kranthie/marvin-bot/sim/motion/README.md

# Motion pipeline: human motion to a Marvin Bot tracking policy

Status: one tracker follows all 25 clips generated with Kimodo (locomotion, sidesteps, turns,
a jog, a march, a kick, squatting and picking up, a bow, a dance and arm gestures) on the 1.41 m
model with the RS10P arm motors. Tracker v6: warm-started from v5 (about 5,000 epochs on the 1.44 m
model) and trained 1,800 more epochs on the current one (16,384 environments, batch 65,536, about
3 hours on one GPU); every clip stays upright, the hands are 3-8 cm and the feet 2-6.5 cm from the
reference's on most clips, with the arm-heavy clips the weakest (two-hand wave, reach forward,
clap, arms raise: hands 9-13 cm).
The clips with the reference as a ghost are on the [skills page](../../docs/skills.md).
Replayed in MuJoCo (`replay_mujoco.py`), it tracks as in training: see
[the MuJoCo check](#the-mujoco-check).

Instead of writing rewards for each skill, train a policy that tracks a reference motion
(BeyondMimic-style motion tracking). A new skill is then a new clip, not new reward code. The
pipeline uses NVIDIA's open tools:

| Step | Tool | Here |
|---|---|---|
| Motions | [Kimodo](https://github.com/nv-tlabs/kimodo) text to motion, with a root path per clip | `generate_kimodo.py` |
| Keypoints | ProtoMotions' `convert_soma23_npz_to_proto.py`, `extract_retargeting_input_keypoints_from_packaged_motionlib.py` | |
| Retarget | ProtoMotions' PyRoki retargeter | `retarget_marvin_bot.py` |
| Convert, package | ProtoMotions' `convert_pyroki_retargeted_robot_motions_to_proto.py`, `motion_lib.py` | `fix_sole_height.py` |
| Track | [ProtoMotions](https://github.com/NVlabs/ProtoMotions) on Newton, BeyondMimic-style rewards | `setup_protomotions.py`, `check_tracking.py` |

`setup_protomotions.py` writes Marvin Bot's MJCF, retargeting URDF and robot config into a
ProtoMotions checkout, all generated from `description/`, and the tracker experiment, made from
upstream's BeyondMimic config with the changes below; rerun it after a description change.

What is specific to Marvin Bot:

- **Scale.** Human keypoints are scaled to Marvin Bot's size in place of the retargeter's G1
  scale: the legs uniformly (0.69, the robot's straight leg over the source's standing one), the
  pelvis target put on the hip axis, the shoulders about the hips (0.62 wide, 0.75 high) and
  6.5 cm forward, the arms about each shoulder (0.79, reach to the wrist pitch axis). The knees
  and feet are then moved 1.5 and 3 cm out along the hip axis: scaled down, the human's feet end
  up 12-14 cm apart and Marvin Bot's are 11 cm wide. The solver also starts from and pulls
  towards the standing pose rather than the middle of each joint's range. With the source's
  pelvis and shoulders left high, the solver crouched the robot to reach them (knees at 37-58°
  through a walk).
- **Arms kept out of the body.** Upstream's retargeter leaves its self-collision cost off, and
  the retargeted arms passed through the body: hands 4-10 cm into the thighs in most walking
  frames, the palms 9 cm through each other in the clap. `retarget_marvin_bot.py` turns it on
  for the arms against the trunk, the legs and the other arm, which leaves no frame with an arm
  inside the body, and the tracking model's arms collide with the body and each other too.
- **Motions at Marvin Bot's pace.** `generate_kimodo.py` gives every locomotion clip and
  in-place skill a root path, so the speed and turn rate are set rather than worded: Kimodo's
  idea of "jogs forward" was a 2 m/s run, which no tracker followed. Of four samples per clip it
  keeps the one with the least foot sliding and crossing of the feet.
- **Palms in.** The motion pipeline's standing pose turns the wrists 80° so the palms face the
  thighs (`robot.yaml`'s stance, which the walking policies use, leaves them facing forward), and
  the retargeter holds the wrist yaw and pitch there, since no keypoint sets the hand's angle.
- **Soles.** ProtoMotions' converter puts the lowest body origin 4 cm above the floor, which
  suits G1's foot frame; `fix_sole_height.py` lifts each clip until the stance foot (the flatter
  one) is on the floor. Lifting until the clip's lowest corner touched instead left the walks
  3-5 cm in the air, since that corner is a toe tipped down at push-off, and the trackers hopped
  to keep up.
- **Tracker.** `mlp_bm_marvin_bot.py` is upstream's `mlp_bm_l2c2.py` with BeyondMimic's
  global anchor-position reward (0.5, sigma 0.3) and a termination when the torso is 0.5 m off
  the reference's, both left out upstream, which is why trackers 1-4 stood still; the reference
  torso's offset in the policy's observations; softer gains for an action scale of at least
  0.4 rad (the walking task's placeholder gains gave 0.2 rad at the hips and knees); more
  exploration (log std -2.3) and a looser body-velocity term (sigma 0.5); and a penalty (-2.0)
  on each foot whose contact differs from the reference's. Without it the trackers hopped,
  with both feet on the ground 70% of the time and both in the air 20%, where the reference
  steps; upstream's other experiments use -0.1, and -0.5 only halved it. The body rewards
  score BeyondMimic's 14 key bodies (pelvis, hips, knees, ankles, torso, shoulders, elbows,
  wrists) instead of all 28, whose average let an arm hang while the reference raised it (hands
  40-75 cm off in the arm skills), and an episode ends when any body is 25 cm from the
  reference's, as in ProtoMotions' deployed G1 tracker; together they brought the hands to
  8-20 cm in the same skills.
- **A second check.** ProtoMotions counts a clip as tracked when the torso height stays within
  25 cm of the reference's; `check_tracking.py` also compares the distance covered, the joint
  angles and the body positions, all bodies and the hands and feet alone (an average over every
  body hides a limb that misses), which is how the first tracker's shuffling showed up.
- **The head and a joint-angle term.** With only the 14 bodies scored the head was free: the
  tracker turned it at 46-60°/s RMS standing still (1-3°/s in the reference). Scoring the head
  and adding a joint-angle term (weight 0.5, sigma 0.3 rad) more than halved that (93°/s to 41°/s
  averaged over the 25 clips) and stopped the crouch the 0.3 m body kernel let through. The term
  scores only the legs, waist and neck: the retargeted arm angles are ill-defined (with the elbow
  nearly straight nothing fixes shoulder yaw, and with the arm out sideways shoulder pitch and yaw
  turn the arm the same way), so the arms-raise reference twists the shoulder yaw by 175° for no
  change in the hand. Scored over every joint, the term made the tracker copy that twist and miss
  the hands by 3 cm more in the arm clips; the arms are scored by their bodies instead.
- **Training size.** 16,384 robots at once keep one RTX-class GPU busy (95%, against 58% with
  4,096), for twice the simulated steps per hour.

## Environments

Everything lives in one parent folder, outside this repo: the ProtoMotions, PyRoki and Kimodo
checkouts, three Python environments (PyRoki uses JAX; Kimodo its own torch) and a work folder.
ProtoMotions keeps its checkpoints, meshes and sample motions in Git LFS (about 6 GB; install
`git lfs` first). The torch wheels below need an NVIDIA driver for CUDA 12.8 (570 or later);
Kimodo needs about 17 GB of GPU memory (or `TEXT_ENCODER_DEVICE=cpu`, under 3 GB). The pipeline
was last run on ProtoMotions `f69fdcaabff31846b4d2247207417b57dc788828` (2026-10-16), PyRoki
`388e43e1fc0d0ee382968d3dd72970fd62a0450c` and Kimodo `e1c219c99b4b94ba48be1fb6a1cbc64ecee4c954`
(2026-10-15), with JAX on the CPU.

Kimodo encodes prompts with Meta's Llama 3 8B Instruct, which is gated: request access to
`meta-llama/Meta-Llama-3-8B-Instruct` on Hugging Face, accepting the Meta Llama 3 Community
License, and log in with `hf auth login` before the first run. Kimodo downloads its own model
and the text encoder on first use (about 16 GB).

```bash
export M=/path/to/marvin-bot          # this repo
cd /path/to/parent && export W=$PWD/work && mkdir -p $W
git lfs install
git clone https://github.com/NVlabs/ProtoMotions
git -C ProtoMotions checkout f69fdcaabff31846b4d2247207417b57dc788828 && git -C ProtoMotions lfs pull
git clone https://github.com/chungmin99/pyroki
git -C pyroki checkout 388e43e1fc0d0ee382968d3dd72970fd62a0450c
git clone https://github.com/nv-tlabs/kimodo
git -C kimodo checkout e1c219c99b4b94ba48be1fb6a1cbc64ecee4c954
uv venv --python 3.12 venvs/proto
VIRTUAL_ENV=venvs/proto uv pip install torch --index-url https://download.pytorch.org/whl/cu128
VIRTUAL_ENV=venvs/proto uv pip install -r ProtoMotions/requirements_newton.txt
VIRTUAL_ENV=venvs/proto uv pip install -e ProtoMotions
uv venv --python 3.12 venvs/pyroki
VIRTUAL_ENV=venvs/pyroki uv pip install -e pyroki
uv venv --python 3.12 venvs/kimodo
VIRTUAL_ENV=venvs/kimodo uv pip install torch --index-url https://download.pytorch.org/whl/cu128
VIRTUAL_ENV=venvs/kimodo uv pip install -e "kimodo[soma]"
```

`setup_protomotions.py` edits the ProtoMotions checkout (it adds four generated files and
registers `marvin_bot` in `robot_configs/factory.py`), so rerun it after updating ProtoMotions or
the description.

## Steps

Generate the motions (`locomotion`, `skills` or clip names; see `generate_kimodo.py`), then run
the rest from the ProtoMotions checkout (`cd /path/to/parent/ProtoMotions`); the interpreters
are `../venvs/proto` and `../venvs/pyroki`. The retargeter runs one clip per process, all at
once, which takes a few minutes for the eleven locomotion clips on a 32-thread CPU (one after
another it takes about 10 minutes a clip, since JAX recompiles for each).

```bash
../venvs/kimodo/bin/python $M/sim/motion/generate_kimodo.py $W/npz locomotion skills
P=../venvs/proto/bin/python; R=../venvs/pyroki/bin/python
$P $M/sim/motion/setup_protomotions.py .
$P data/scripts/convert_soma23_npz_to_proto.py --input-dir $W/npz --output-dir $W/soma \
    --input-fps 30 --output-fps 30 --ignore-motion-filter
$P protomotions/components/motion_lib.py --motion-path $W/soma --output-file $W/soma.pt
$P data/scripts/extract_retargeting_input_keypoints_from_packaged_motionlib.py $W/soma.pt \
    --output-path $W/keypoints --skeleton-format soma --start-idx 0 --skip-freq 1
for f in $W/keypoints/*.npy; do
  d=$W/keypoints_split/$(basename $f .npy); mkdir -p $d; cp $f $d/
  ( $R $M/sim/motion/retarget_marvin_bot.py --protomotions . --keypoints-folder-path $d \
      --output-dir $W/retargeted --source-type soma --no-visualize &&
    $R $M/sim/motion/retarget_marvin_bot.py --protomotions . --keypoints-folder-path $d \
      --output-dir $W/retargeted --source-type soma --no-visualize \
      --save-contacts-only --contacts-dir $W/contacts ) &
done; wait
$P $M/sim/motion/add_head_motion.py $W/npz $W/retargeted \
    protomotions/data/assets/urdf/for_retargeting/marvin_bot.urdf
$P data/scripts/convert_pyroki_retargeted_robot_motions_to_proto.py \
    --retargeted-motion-dir $W/retargeted --output-dir $W/proto --robot-type marvin_bot \
    --contact-labels-dir $W/contacts --apply-motion-filter --force-remake
$P $M/sim/motion/fix_sole_height.py . $W/proto
$P protomotions/components/motion_lib.py --motion-path $W/proto --output-file $W/marvin_bot_motions.pt
$P protomotions/train_agent.py --robot-name marvin_bot --simulator newton \
    --experiment-path examples/experiments/mimic/mlp_bm_marvin_bot.py --experiment-name marvin_bot_track \
    --motion-file $W/marvin_bot_motions.pt --num-envs 16384 --batch-size 65536 --headless
$P $M/sim/motion/check_tracking.py \
    results/marvin_bot_track/results/predicted_motion_lib_epoch_<N>.pt $W/marvin_bot_motions.pt
```

The tracker trains at about 5.6 s an epoch with 16,384 robots on one RTX-class GPU and writes a
rollout of every clip (`predicted_motion_lib_epoch_<N>.pt`) every 600 epochs, from epoch 200;
score the latest with `check_tracking.py`.

### The MuJoCo check

The tracker is exported to ONNX with ProtoMotions' own tool and replayed in MuJoCo, clip by clip,
on the training MJCF with the motors as the walking policies' MuJoCo check models them (PD clipped
by the torque-speed line, joint armature and friction, none of which Newton's built-in PD has) and
sensor noise on the joint angles, joint speeds and pelvis rate. It fails if any clip falls, so it
is run on every new tracker when its training stops:

```bash
$P deployment/export_bm_tracker_onnx.py --checkpoint results/marvin_bot_track/last.ckpt --output $W/onnx
$P $M/sim/motion/replay_mujoco.py $W/onnx/unified_pipeline.onnx $W/marvin_bot_motions.pt $W/mujoco.pt
$P $M/sim/motion/check_tracking.py $W/mujoco.pt $W/marvin_bot_motions.pt
$P $M/sim/motion/render_tracking.py export <Newton rollout> $W/marvin_bot_motions.pt $W/v.npz \
    --mujoco $W/mujoco.pt    # then render: MuJoCo is drawn as a translucent orange robot
```

(`pip install onnx onnxruntime` in the ProtoMotions environment first.) Tracker v6 in MuJoCo: every
clip upright, and the averages over the 25 clips match training (joints 9.3° against 9.4° in
Newton, hands 5.6 cm against 5.6, feet 4.2 against 4.6; tracker v5 on the 1.44 m model: 11.0°,
6.7 cm, 4.5 cm). Peak torque stays under 75% of each motor's peak except the two-hand wave's left
shoulder yaw, which touches the RS10P's 42 N·m (the RS06 there hit its 36 N·m in v5). The hottest
joint in any clip is the clap's left shoulder roll at 78% of the RS10P's 14 N·m rating (RMS); the
legs stay under 56%.

The tracker reads the torso's position in the world (how far the reference is ahead of it). In
simulation that is exact; on the robot it has to come from odometry (legged odometry or the
camera's visual odometry), so a version without it, or trained with odometry drift (ProtoMotions
has a synthetic odometry-corruption option), is needed before hardware.

`add_head_motion.py` sets the neck from the human's head: ProtoMotions' retargeter (built for a
robot without a neck) has no head keypoint, so before it every reference looked straight ahead.

**Checking the clips before training** (`check_clips.py`). Each layer runs on Kimodo's human clip
and the third again on the robot reference, so a failure points at generation or at retargeting:

1. *Text match*: NVIDIA's text-motion retrieval model for SOMA (TMR-SOMA-RP-v1, which Kimodo's
   benchmark scores with) gives each clip its similarity to its own prompt and that prompt's rank
   among all 25; a clip another prompt describes better is suspect.
2. *Quality*: Kimodo's benchmark metrics: foot sliding while in contact (its published Skate is
   2-4 cm/s), contact consistency, and the hips' distance from the root path asked for.
3. *Skill checks*: a geometric test of what each prompt asked for (the hands meet in a clap, a
   hand above the shoulder swinging in a wave, the pelvis dropping in a squat, the speed, turn and
   direction of a walk), in units of the standing head height so it runs on both bodies.
4. *Review renders*: the human as a stick figure beside the robot reference, with the checks.

```bash
../venvs/kimodo/bin/python $M/sim/motion/check_clips.py human $W/npz       # layers 1-3
$P $M/sim/motion/render_tracking.py export $W/marvin_bot_motions.pt $W/marvin_bot_motions.pt $W/ref.npz
python sim/motion/check_clips.py robot $W/ref.npz                            # layer 3, this repo's env
MUJOCO_GL=egl python sim/motion/check_clips.py render $W/npz $W/ref.npz <out dir>   # layer 4
```

On the first 25 clips (2026-10-29) every clip ranked its own prompt first or second and slid
0.2-3.8 cm/s in contact, but five did less than asked: the wave waved for 2 s of 8, the arm raise
lifted the arms about 45° rather than to the sides, the march stopped after 3 s, and the idle and
the dance sway barely moved (1-2 cm; a root path pinned at the start held their hips still).
`generate_kimodo.py` now keeps the sample with the fewest failed skill checks; with sharper
prompts, no root path for the idle and the dance, and 8 samples each, all 25 pass and every clip
ranks its own prompt first except the reach (second, after the two-hand wave). On the robot two
fall short of the human: the clap's palms meet once rather than three times, and the pick-up's
hands stop 27 cm above the floor (with no waist pitch the robot cannot bend over to reach it).

`render_tracking.py render --plot` adds a strip under a tracked clip plotting how far the hands,
feet and head are from the reference's, frame by frame.

`convert_100style.py` turns [100STYLE](https://zenodo.org/records/8127870) motion capture
(CC-BY-4.0) into keypoints instead (then retarget with `--converted` and skip the Kimodo and
keypoint-extraction steps); it was the source before Kimodo.

## Lite's clips

[Lite](../../docs/design/lite.md) shares Max's upper body and has no legs. Its clips take the
upper body (waist, arms, wrists, neck) from the retargeted clips above. A base path and a column
height are written for each in `lite_clips.py`, as keyframes joined by minimum-jerk curves inside
the base controller's limits and the column's 38 mm/s, instead of being taken from the hips. The
`lite` group of `generate_kimodo.py` adds two standing upper bodies for it: holding a box and
handing something over.

No tracker is trained: Lite does not balance, so `lite_clips.py run` plays each clip on its
wheels in MuJoCo (`sim/mujoco/check_lite.py`'s model) with the joints' position servos. It scores:

- the hands against the clip;
- the base's path error;
- the two lightest wheels' loads;
- each joint's peak and RMS torque.

It fails if two wheels unload, a joint passes its rating, or the column is asked for more than
38 mm/s. Results are on the [skills page](../../docs/skills.md#lite).

```bash
../venvs/kimodo/bin/python $M/sim/motion/generate_kimodo.py $W/npz lite
# then the Steps above, from convert_soma23_npz_to_proto.py to add_head_motion.py, for these clips
python $M/sim/motion/lite_clips.py run $W/lite.npz $W/retargeted <the other clips' retargeted/> \
    --protomotions <ProtoMotions checkout>
MUJOCO_GL=egl python $M/sim/motion/lite_clips.py render $W/lite.npz $M/docs/media/skills/lite
```

## Motion sources compared

The same eight motions from three openly licensed sources, retargeted and tracked the same way
(1,400 epochs each, before the root paths, the contact penalty and the sole fix):

| | 100STYLE | Kimodo (SOMA-RP model) | CMU |
|---|---|---|---|
| Clips through ProtoMotions' motion filter | 8 of 8 | 8 of 8 | 5 of 8 (the rest jump) |
| Planted foot sliding (median) | 0.07 m/s | 0.06 m/s | 0.43 m/s |
| Tracker stays up | 5 of 8 | 3 of 8; 5 of 8 with gentler prompts | 3 of 5 |

Kimodo became the source: its motions tracked as well as 100STYLE's once the prompts asked for
a pace Marvin Bot can keep, a root path now sets that pace exactly, and it makes the skills
beyond walking that no openly licensed dataset has. 100STYLE remains an option for locomotion
(CC-BY-4.0, real capture). CMU's recordings are older and noisier.

## Data licences

Motion data is not committed. Kimodo's models are under the NVIDIA Open Model License (NVIDIA
claims no rights in the motions they generate) and were trained on Bones Studio's motion
capture; its text encoder is Meta's Llama 3 8B Instruct under the Meta Llama 3 Community License
and the LLM2Vec adapters (MIT). Each user accepts those licences when downloading the models;
nothing from them is redistributed here. 100STYLE is CC-BY-4.0: credit "100STYLE, I. Mason,
S. Starke and T. Komura, Real-Time Style Modelling of Human Locomotion via Feature-Wise
Transformations and Local Motion Phases (2022)" with anything you publish from it.
ProtoMotions' own sample motions are from the BONES-SEED dataset, whose licence covers only
non-profit academic institutions and companies under $1M annual revenue; this pipeline does not
use them. The CMU database (mocap.cs.cmu.edu) is free to use, with that credit. ProtoMotions'
and PyRoki's code is Apache-2.0 and MIT.
