kranthie/marvin-bot/docs/safety.md

# Safety

Marvin Bot weighs about 40 kg, runs on a 48 V lithium-ion battery that can deliver well over 100 A, and has joints that produce up to 120 N·m. It can break fingers, cause serious injury when it falls, and start a battery fire. These rules apply from the first actuator bench test onward. They are a first version and will grow with each phase.

> [!WARNING]
> Nothing described below has been built or tested yet: the e-stop, watchdog, fuses and battery
> protection are the design's requirements, and each must be verified on the bench before it is
> relied on. These notes are a starting point, not a complete or certified safety procedure.
> They do not replace your own risk assessment, the component makers' instructions, or the laws
> and standards that apply where you are, and following them does not make the robot safe. You
> build and run it at your own risk; see the warranty disclaimers in the licences.

## Before any actuator is powered

- Clamp the actuator or limb to the bench. Keep hands out of the range of motion whenever the driver is enabled.
- Start with low torque limits and low gains; raise them only after the motion has been checked at low limits.
- Know where the e-stop is and test it before each session.
- The CAN driver (`robot/drivers/robstride.py`) and the bench scripts are untested: check every command at low torque limits first.
- The wrist servos and the hands' finger servos are pinch points; treat them like any other powered joint.
- Lift the robot with two people or a hoist.

## E-stop and power

- The hardware e-stop is designed to open a contactor that removes power from all actuators. It does not cut the computer's supply, so logs and state survive a stop.
- There are two stops in series: a latching wired mushroom button and a wireless stop. Either one is to cut actuator power.
- A watchdog relay is to open the contactor too if the control loop stops sending heartbeats.
- The main battery path has a Class-T fuse, a precharge circuit and the contactor. Each limb's branch has its own fuse.
- When running from a bench supply, a regen clamp (brake resistor or TVS) must be fitted. Braking joints push energy back into the supply, and many supplies are damaged by it.

## Battery

- Charge the pack only on a non-flammable surface, attended, with a charger set to 4.1 V per cell for everyday use (4.2 V only when maximum range is needed).
- Store at about 50% charge, in a fire-resistant container, away from exits.
- Never use a pack that is swollen, damaged or has been in a hard fall until it has been inspected.
- If a pack swells, smokes or hisses: cut power only if that is safe, move away, keep others out and call emergency services. A lithium-ion fire cannot be put out reliably with a small extinguisher.
- The BMS must report to the computer; the robot sits down and powers off its actuators at about 15% charge.

## Walking tests

- All early standing and walking happens on a gantry with a harness that catches the robot before its knees touch the floor.
- Free walking starts only after phase 4's gantry walking tests in [plan.md](plan.md), in a clear area with padding and nobody within 2 m.
- One person operates; one person holds the e-stop and does nothing else.
- Policies run first in simulation (Isaac Lab and the MuJoCo cross-check) with the same limits, rates and latency as the robot.

## Lite (the wheeled variant)

Lite cannot fall the way a walking robot does, but it can tip over, run into people and pinch.
The figures are from `sim/mujoco/check_lite.py` ([design/lite.md](design/lite.md)).

- With the column up, a sideways push of about 46 N at the shoulders tips Lite over. Lower the
  column before driving, and whenever people are within reach.
- The base controller limits deceleration by column height and arm pose (0.8 m/s² with the column
  up and the arms forward), and ramps it. Never drive it with those limits off.
- The column is a pinch point at its stages and under the torso, and it is self-locking: it stays
  where it is when the power goes. Keep hands off it while it moves.
- The column's motor is rated for a 10% duty cycle (about 2 minutes on, 18 off). The driver
  enforces it.
- The e-stop cuts the wheels', arms' and column's power. Test that the base stops on it before
  every session, on blocks first with the wheels off the floor.
- Keep Lite away from stairs and drops: its wheels cross 10 mm thresholds, nothing taller.

## Software safety layers

- Commands from any high-level model (VLA, teleoperation) are clamped to joint, velocity and torque limits.
- If no new command arrives within a timeout, the robot holds its pose; if the controller itself stops, the watchdog cuts actuator power.
- Fall detection switches all joints to a damping mode.
- Motor faults (over-temperature, over-current, encoder errors) are logged and stop the robot.
