kranthie/marvin-bot/docs/skills.md

# Skills in simulation

Every skill the motion tracker has learned, on the current 1.41 m model (RS10P arm motors, the
rounded head). The solid robot is the trained policy; the translucent blue robot is the reference
motion it follows (a human motion generated with Kimodo and retargeted to Marvin Bot). One policy
plays all 25 clips: tracker v6, warm-started from the previous tracker (about 5,000 epochs on the
1.44 m model) and trained 1,800 more epochs on the current model, on Newton with 16,384 robots at
once (about 3 hours on one GPU); every clip stays upright. Under each clip: the hands' and feet's
mean distance from where the reference puts them, measured relative to the pelvis.

The clips are rendered with `sim/motion/render_tracking.py`; how they are made, trained and scored
is in [sim/motion/README.md](../sim/motion/README.md). This is simulation only, though in two
simulators: replayed in MuJoCo (`sim/motion/replay_mujoco.py`) with sensor noise and the motors'
torque-speed limits, every clip stays upright and the hands, feet and joints track as closely as
in Newton, where it was trained. It has not run on hardware. The weakest skills are the
arm-heavy ones (the two-hand wave, reach forward, clap, arms raise: hands 9–13 cm off), and the
squat and pick-up stop 4.5 and 9 cm short of the reference's lowest point. The arm motors are
closest to their limits in the two-hand wave (the left shoulder yaw touches the RS10P's 42 N·m
peak) and the clap (the left shoulder roll at 78% of its rated torque, RMS).

## Walking and turning

| Walk | Walk slow | Walk back |
|---|---|---|
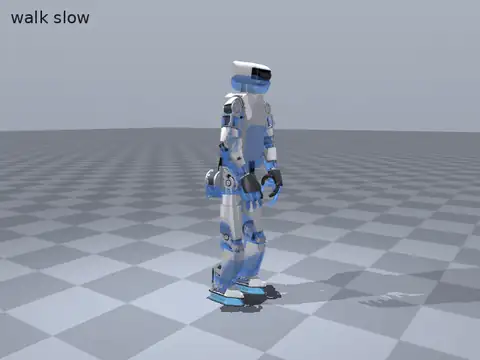
[picture p10: docs/media/skills/walk_slow.webp]
walk slow
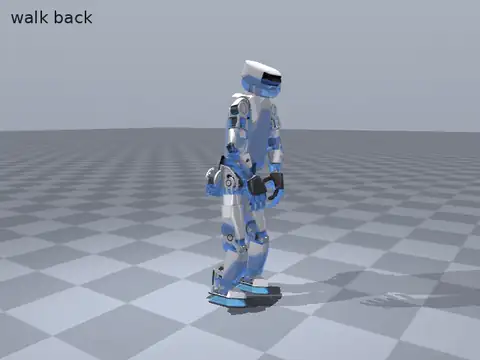
[picture p11: docs/media/skills/walk_back.webp]
walk back
| walk |  |  |
| hands 4.2 cm, feet 5.5 cm | hands 4.7 cm, feet 4.4 cm | hands 5.4 cm, feet 4.2 cm |

| Jog | March | Start stop |
|---|---|---|
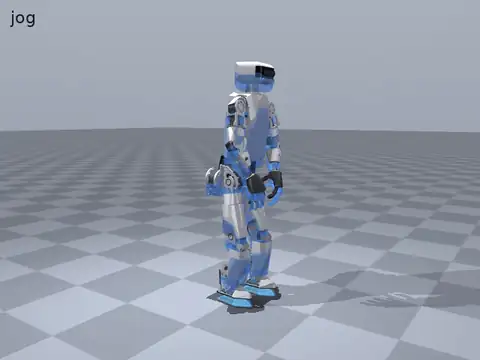
[picture p12: docs/media/skills/jog.webp]
jog
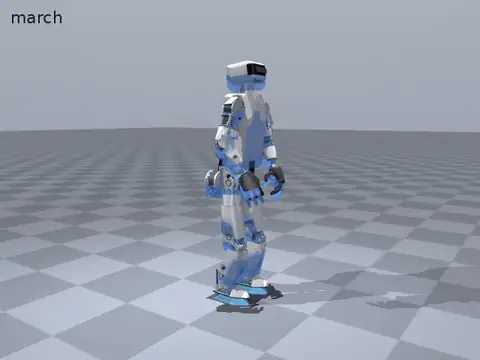
[picture p13: docs/media/skills/march.webp]
march
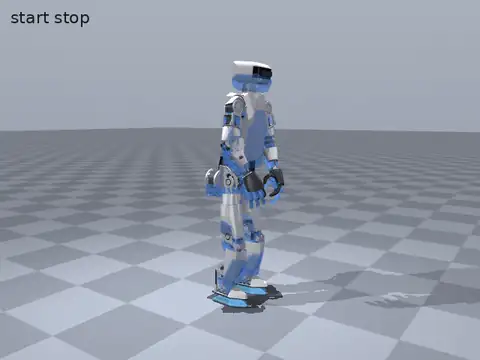
[picture p14: docs/media/skills/start_stop.webp]
start stop
|  |  |  |
| hands 4.1 cm, feet 6.1 cm | hands 4.9 cm, feet 6.1 cm | hands 3.6 cm, feet 4.8 cm |

| Carry walk | Side left | Side right |
|---|---|---|
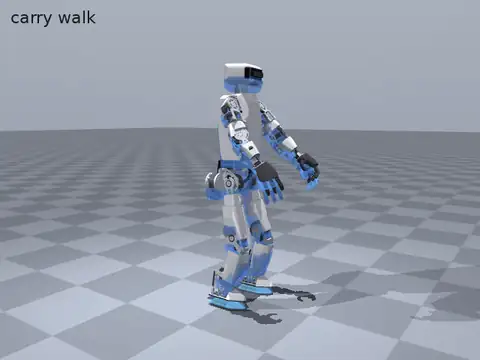
[picture p15: docs/media/skills/carry_walk.webp]
carry walk
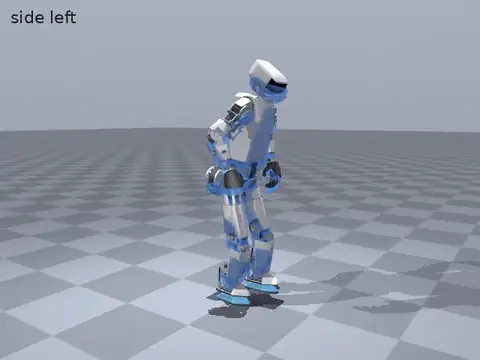
[picture p16: docs/media/skills/side_left.webp]
side left
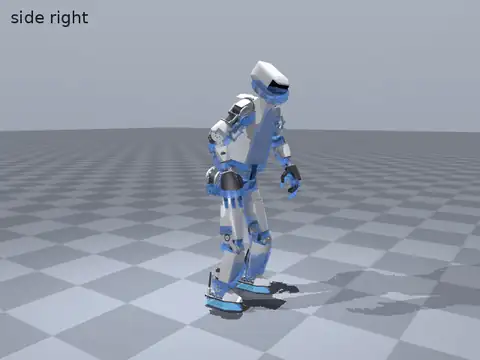
[picture p17: docs/media/skills/side_right.webp]
side right
|  |  |  |
| hands 6.7 cm, feet 5.5 cm | hands 6.2 cm, feet 5.3 cm | hands 7.2 cm, feet 5.2 cm |

| Turn left | Turn right | Turn in place |
|---|---|---|
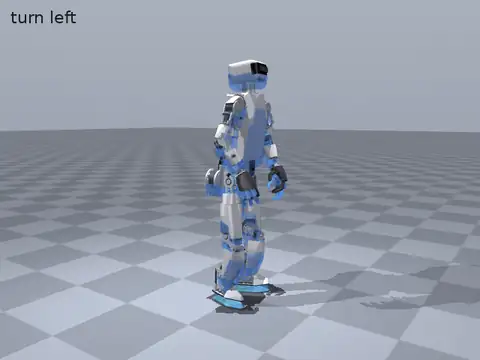
[picture p18: docs/media/skills/turn_left.webp]
turn left
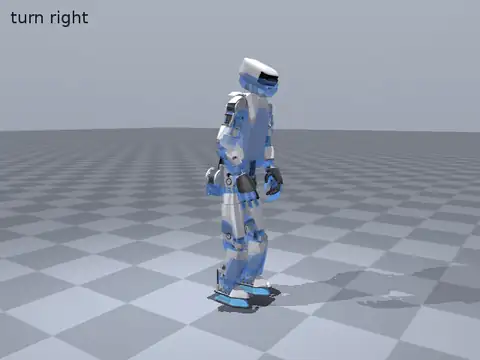
[picture p19: docs/media/skills/turn_right.webp]
turn right
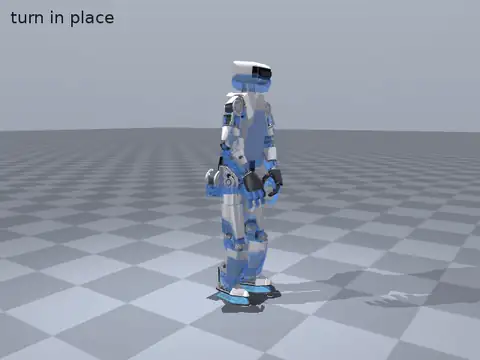
[picture p20: docs/media/skills/turn_in_place.webp]
turn in place
|  |  |  |
| hands 4.7 cm, feet 4.6 cm | hands 5.2 cm, feet 5.5 cm | hands 2.6 cm, feet 6.4 cm |

## Whole body

| Kick | Squat | Pick up |
|---|---|---|
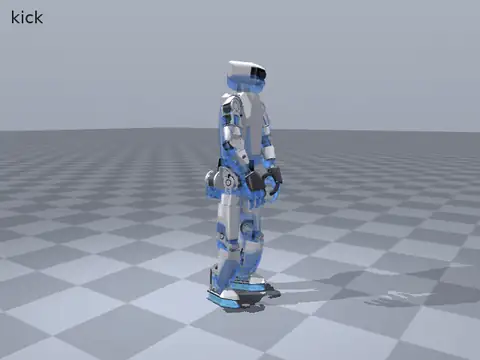
[picture p21: docs/media/skills/kick.webp]
kick
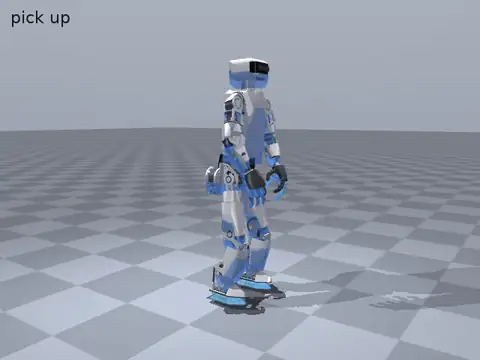
[picture p22: docs/media/skills/pick_up.webp]
pick up
|  | squat |  |
| hands 3.9 cm, feet 4.4 cm | hands 6.8 cm, feet 5.6 cm | hands 3.2 cm, feet 3.8 cm |

| Bow | Dance sway | Idle |
|---|---|---|
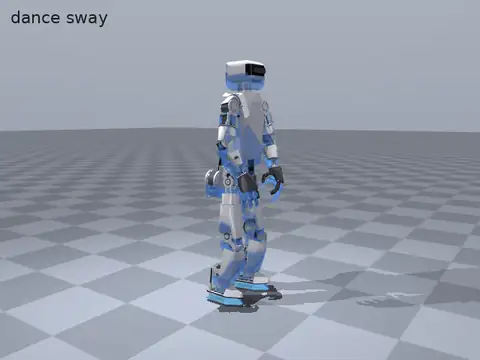
[picture p23: docs/media/skills/dance_sway.webp]
dance sway
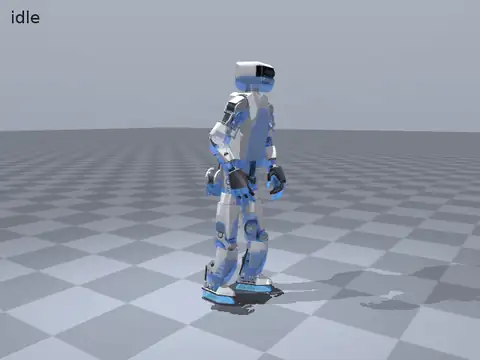
[picture p24: docs/media/skills/idle.webp]
idle
| bow |  |  |
| hands 3.6 cm, feet 4.3 cm | hands 7.3 cm, feet 3.5 cm | hands 2.9 cm, feet 4.4 cm |

| Look around |
|---|
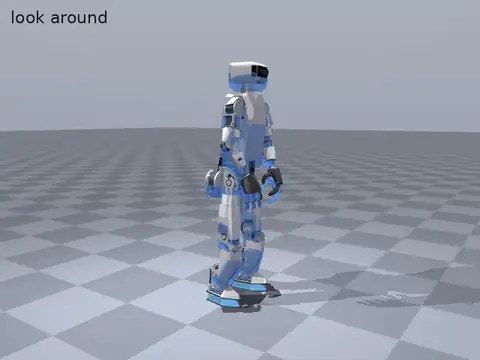
[picture p25: docs/media/skills/look_around.webp]
look around
|  |
| hands 3.4 cm, feet 3.6 cm |

## Arms and gestures

| Clap | Wave | Wave both |
|---|---|---|
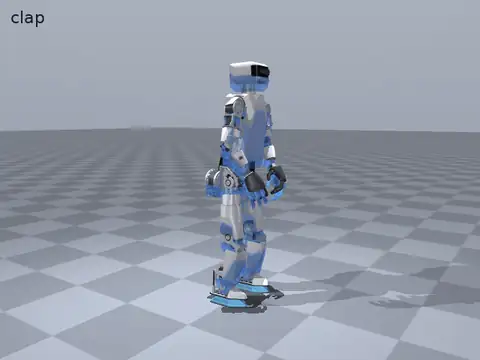
[picture p26: docs/media/skills/clap.webp]
clap
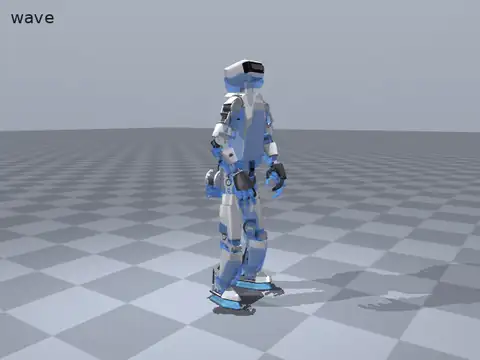
[picture p27: docs/media/skills/wave.webp]
wave
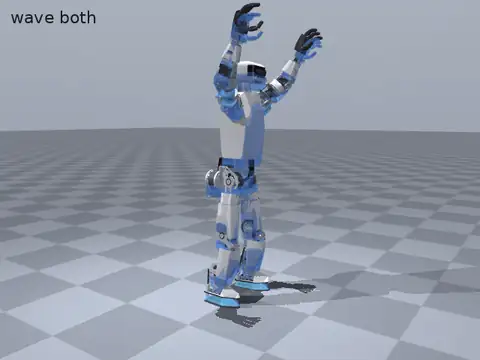
[picture p28: docs/media/skills/wave_both.webp]
wave both
|  |  |  |
| hands 8.8 cm, feet 3.8 cm | hands 5.1 cm, feet 2.7 cm | hands 12.8 cm, feet 5.2 cm |

| Point | Reach forward | Arms raise |
|---|---|---|
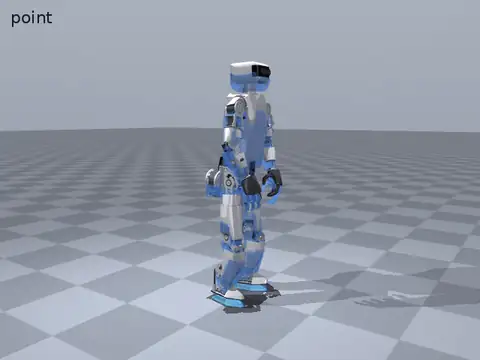
[picture p29: docs/media/skills/point.webp]
point
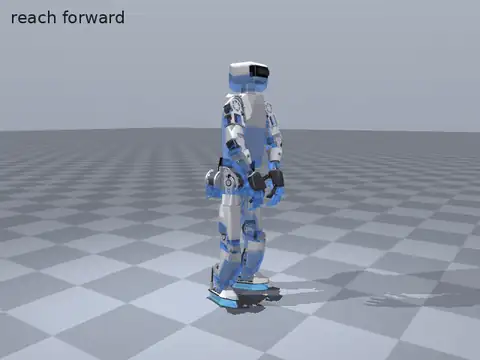
[picture p30: docs/media/skills/reach_forward.webp]
reach forward
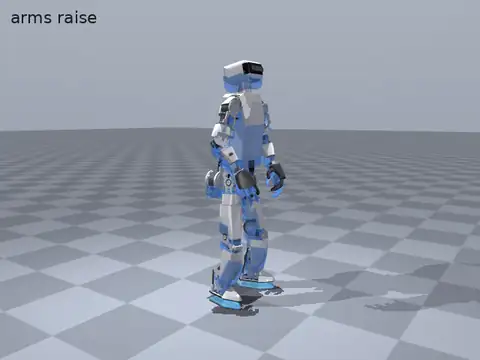
[picture p31: docs/media/skills/arms_raise.webp]
arms raise
|  |  |  |
| hands 3.4 cm, feet 2.9 cm | hands 9.7 cm, feet 4.8 cm | hands 8.8 cm, feet 1.8 cm |

## Lite

[Lite](design/lite.md) has no legs, so its clips keep only the upper body (waist, arms, wrists,
neck) from the same retargeted clips. Each clip's base path and column height are written as
keyframes, not taken from the hips, and kept inside the base controller's limits and the
column's 38 mm/s. Two upper bodies were generated for Lite: holding a box and handing something
over. `sim/motion/lite_clips.py` plays each clip on Lite's wheels in MuJoCo (rollers, torque
limits) with the joints' position servos. No learned policy is needed, since Lite does not
balance.

Under each clip:

- **hands:** how far the hands are from where the clip puts them;
- **wheels:** the two lightest wheels' lowest loads, as a share of a wheel's static share (both
  near 0% would mean tipping);
- **RMS:** the joint working hardest, as RMS torque against its rating.

Every clip stays on all four wheels, and no joint passes 33% of its rating.

| Idle | Look around | Point |
|---|---|---|
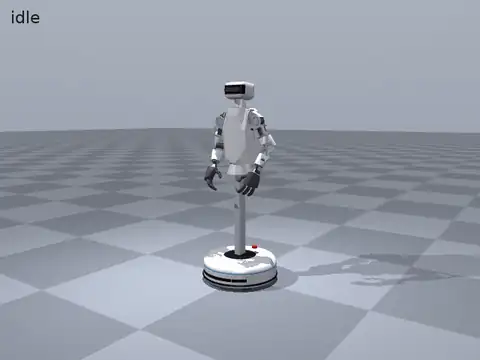
[picture p32: docs/media/skills/lite/idle.webp]
idle
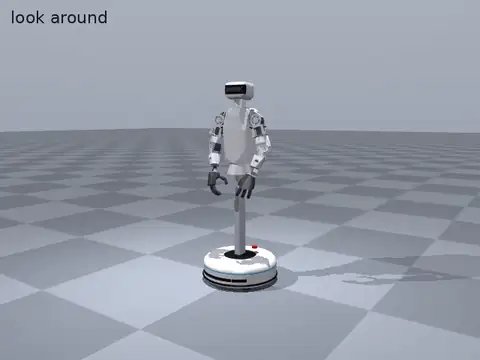
[picture p33: docs/media/skills/lite/look_around.webp]
look around
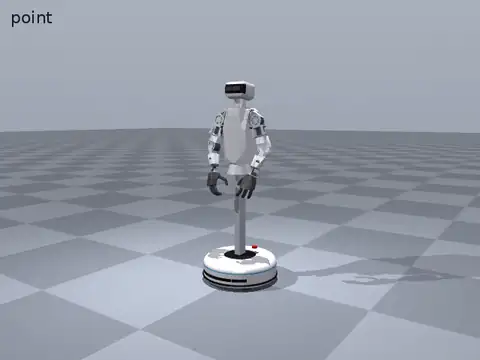
[picture p34: docs/media/skills/lite/point.webp]
point
|  |  |  |
| hands 0.9 cm, wheels 95/97%, RMS 8% | hands 0.6 cm, wheels 92/94%, RMS 9% | hands 1.2 cm, wheels 83/88%, RMS 17% |

| Wave | Wave both | Clap |
|---|---|---|
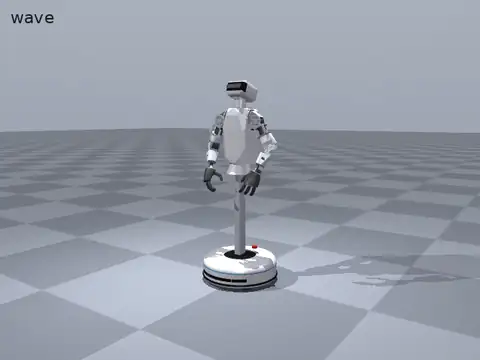
[picture p35: docs/media/skills/lite/wave.webp]
wave
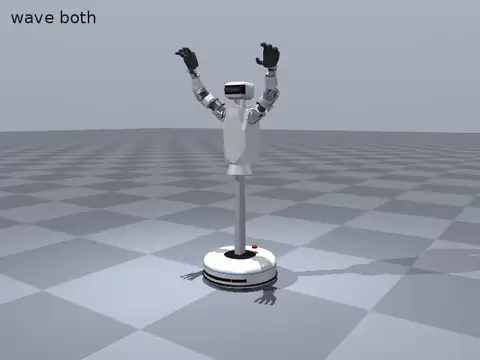
[picture p36: docs/media/skills/lite/wave_both.webp]
wave both
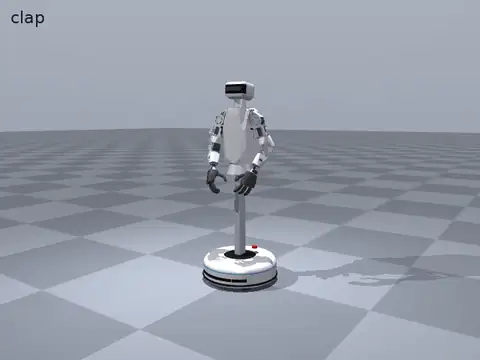
[picture p37: docs/media/skills/lite/clap.webp]
clap
|  |  |  |
| hands 1.4 cm, wheels 77/85%, RMS 17% | hands 2.5 cm, wheels 70/75%, RMS 20% | hands 1.7 cm, wheels 63/74%, RMS 24% |

| Arms raise | Dance sway | Hand over |
|---|---|---|
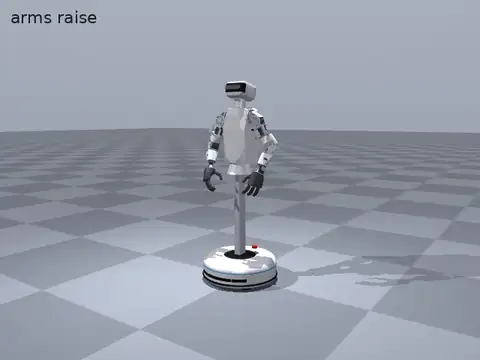
[picture p38: docs/media/skills/lite/arms_raise.webp]
arms raise
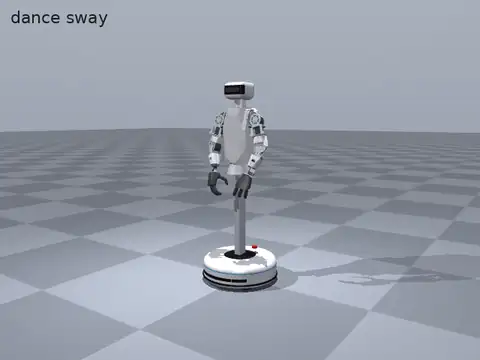
[picture p39: docs/media/skills/lite/dance_sway.webp]
dance sway
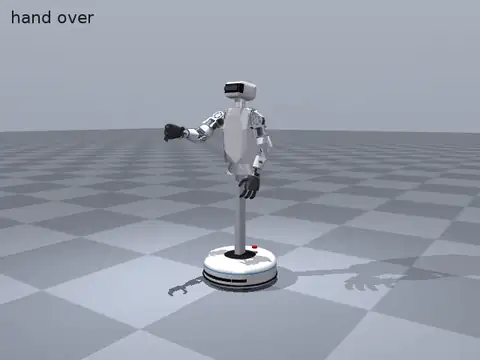
[picture p40: docs/media/skills/lite/hand_over.webp]
hand over
|  |  |  |
| hands 4.5 cm, wheels 93/95%, RMS 33% | hands 1.6 cm, wheels 16/45%, RMS 18% | hands 1.0 cm, wheels 90/92%, RMS 16% |

| Reach forward (column rises 0.10 m) | Carry (1 kg box, 1.2 m) | Turn (180°) |
|---|---|---|
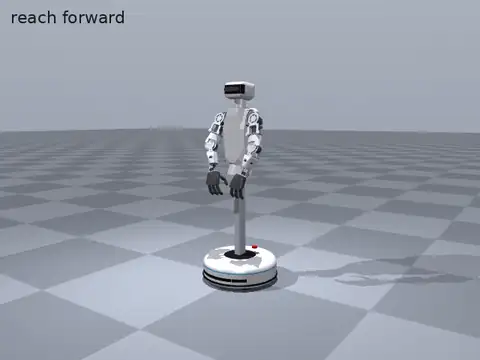
[picture p41: docs/media/skills/lite/reach_forward.webp]
reach forward
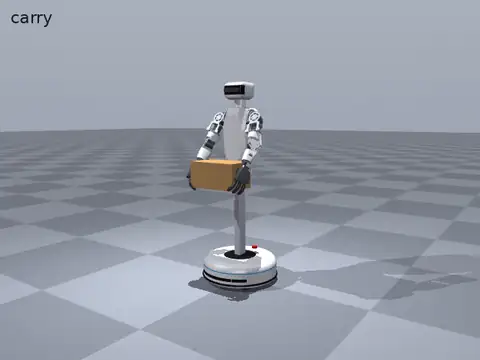
[picture p42: docs/media/skills/lite/carry.webp]
carry
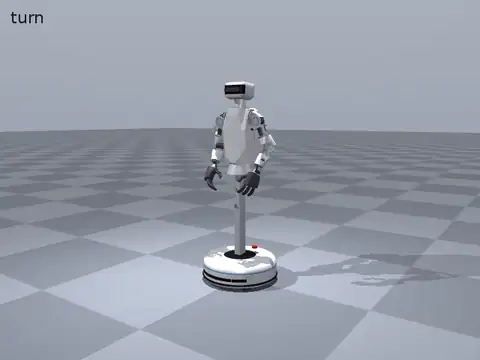
[picture p43: docs/media/skills/lite/turn.webp]
turn
|  |  |  |
| hands 1.0 cm, wheels 52/63%, RMS 21% | hands 1.8 cm, wheels 73/74%, RMS 27% | hands 0.9 cm, wheels 92/92%, RMS 8% |

| Sidestep (0.6 m and back) | Wave while driving | Column rise |
|---|---|---|
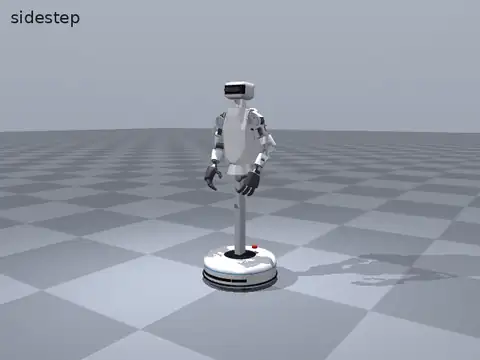
[picture p44: docs/media/skills/lite/sidestep.webp]
sidestep
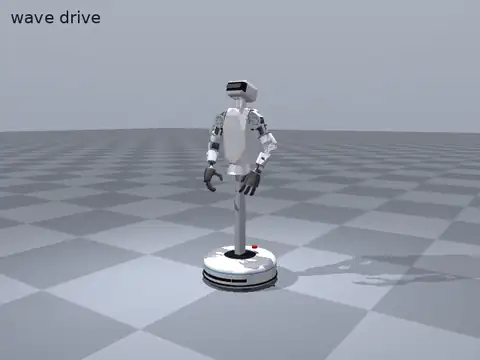
[picture p45: docs/media/skills/lite/wave_drive.webp]
wave drive
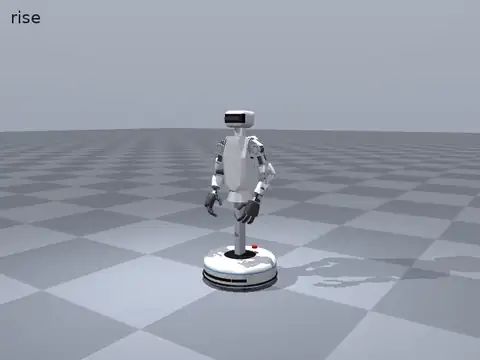
[picture p46: docs/media/skills/lite/rise.webp]
rise
|  |  |  |
| hands 1.0 cm, wheels 81/84%, RMS 8% | hands 1.5 cm, wheels 70/84%, RMS 17% | hands 1.0 cm, wheels 96/98%, RMS 8% |

The dance sway is the closest to the base's limit: one wheel drops to 16% of its share as the
torso swings.

The leg clips (walking, jogging, sidesteps, the kick, the march) and the bow have nothing to map
onto. The squat and pick-up need a reach to the floor, which Lite's hands, at least 0.44 m up,
cannot make.
