kranthie/marvin-bot/bom/bom.xlsx

Sheet: Summary
Marvin Bot bill of materials
This workbook is the BOM's source of truth; copy it to track your own build. Set a line's status to owned or ordered as you go (empty counts as to buy) and the totals follow. After editing, run python tools/bom/book.py to tidy it. Prices are indicative: see each line's price basis and the Sourcing sheet.
Group | Lines | Total USD | Owned USD | Ordered USD | To buy USD
Actuators | 6 | $6338.91 | $0 | $0 | $6338.91
Hands | 3 | $224 | $0 | $0 | $224
Compute & sensors | 6 | $4723 | $0 | $0 | $4723
Power | 14 | $1633.05 | $0 | $0 | $1633.05
Electronics & wiring | 14 | $843.9 | $0 | $0 | $843.9
Structure & materials | 19 | $2452 | $0 | $0 | $2452
Fasteners | 1 | $180 | $0 | $0 | $180
Tooling | 5 | $710 | $0 | $0 | $710
Safety | 4 | $470 | $0 | $0 | $470
Total (full cost to replicate) | 72 | $17574.86 | $0 | $0 | $17574.86
Lite (Lite qty, no spares) |  | $13439.13
Optional, not counted: a desktop RTX GPU with 24-32 GB for training and GR00T fine-tuning (RTX 5090: $1,999 list, about $4,000 or more street price in late 2026). Also not counted: the desktop CNC mill and 3D printer, shipping, import duties and tariffs.

Sheet: Actuators
ID | Item | Model | Status | Qty | Spares | Lite qty | Unit USD | Line USD | Price basis | Source | Notes
sts3250 | Feetech STS3250 serial-bus servo | STS3250 |  | 4 | 0 | 4 | $97.00 | $388.00 | 2026-10-29: $97 (AIFit Lab, ST-3250-C001, backordered); $125 elsewhere (sold out) | https://aifitlab.com/products/feetech-sts3250-servo-motor | neck yaw/pitch and wrist pitch; check the variant (C001 or C002) before ordering
desk-column | LINAK DL6 three-stage desk lifting column, 560 mm retracted, 650 mm stroke, Hall sensor | DL6 |  | 0 | 0 | 1 | $161.00 | $0.00 | EUR 152.05 incl. VAT at a European reseller (Nov 2026), about $161; reseller figure, not confirmed by LINAK |  | Lite's column (decisions 2026-11-07). Mounting from LINAK's data sheet: bottom plate 4 x M6 + 2 x M8, motor housing 177 x 97 x 46 with 6 x M6 in its sides. Driven directly through its motor and Hall sensor (column-driver), not LINAK's control box: bench-test that first. Fallback: TiMOTION TL18
rs00 | Robstride RS00 14 N·m actuator | RS00 |  | 2 | 0 | 6 | $138.99 | $277.98 | Seeed 2026-10-29: $138.99 each, $131.99 at 10+, in stock (RobStride list $125) | https://www.seeedstudio.com/Robostride-00-Actuator-p-6664.html | wrist yaw
rs03 | Robstride RS03 60 N·m actuator | RS03 |  | 9 | 1 | 3 | $225.00 | $2250.00 | Seeed 2026-10-29: $225 each, $214 at 10+, in stock (RobStride list $225) | https://www.seeedstudio.com/Robostride-03-Actuator-p-6774.html | hip yaw and the two ankle motors, both legs; waist yaw; shoulder pitch. Buy one first for the actuator bench test; 10 or more in one order get Seeed's $214 price
rs04 | Robstride RS04 120 N·m actuator | RS04 |  | 6 | 1 | 0 | $255.00 | $1785.00 | Seeed 2026-10-29: $255 each, $242 at 10+, in stock (RobStride list $255) | https://www.seeedstudio.com/Robostride-04-Actuator-p-6775.html | hip pitch, hip roll and knee, both legs; buy one first for the actuator bench test
rs10p | Robstride RS10P 42 N·m actuator | RS10P |  | 6 | 1 | 6 | $233.99 | $1637.93 | OpenELAB 2026-11-02 (search listing): $233.99 sale price, pre-order; RobStride China list ¥859 | https://openelab.io/products/robstride-10p-qdd-joint-actuator | shoulder roll, shoulder yaw and elbow; not stocked by Seeed when checked
 | Total actuators |  |  |  |  |  |  | $6338.91

Sheet: Hands
ID | Item | Model | Status | Qty | Spares | Lite qty | Unit USD | Line USD | Price basis | Source | Notes
hand-kit | AmazingHand open-source 8-DOF four-finger hand kit, left and right (8 Feetech SCS0009 servos each, 5 V) |  |  | 2 | 0 | 2 | $99.00 | $198.00 | Seeed 2026-10-29: $99 each, $97 at 10+, in stock; SKUs 100062181 (left), 100063642 (right) | https://www.seeedstudio.com/Amazing-Hand-Open-Source-3D-Printable-Robotic-Hand-Kit.html | the listing does not say what is in the box, so check that servos are included. 0.40 kg each as published (weigh); its design is CC-BY-4.0, see ACKNOWLEDGMENTS.md
dcdc-hand | DC-DC 12 V to 5 V, 3 A, small (in the wrist) |  |  | 2 | 0 | 2 | $8.00 | $16.00 | estimate |  | one per hand: 8 SCS0009 servos at up to 0.3 A each
servo-adapter-hand | Feetech serial-bus USB adapter (Waveshare Bus Servo Adapter (A) class) |  |  | 2 | 0 | 2 | $5.00 | $10.00 | Waveshare 2026-10-29: $4.99 (SKU 25514) | https://www.waveshare.com/bus-servo-adapter-a.htm | one bus per hand: SCS0009 servos use Feetech's SCS protocol, the STS3250s its STS protocol; the hand kit's own driver board may do instead
 | Total hands |  |  |  |  |  |  | $224

Sheet: Compute & sensors
ID | Item | Model | Status | Qty | Spares | Lite qty | Unit USD | Line USD | Price basis | Source | Notes
lidar-2d | 2-D scanning lidar, 360°, 12 m, ROS 2 driver (RPLIDAR C1 class) |  |  | 0 | 0 | 1 | $100.00 | $0.00 | retail listings $80-130 (Nov 2026); not confirmed by the maker |  | Lite: navigation and people near the base. Chosen for its 12 m range, 360° scan and open ROS 2 driver; any 360° 2-D lidar under 70 mm across fits the bracket
compute | Jetson AGX Orin 64 GB developer kit |  |  | 1 | 0 | 1 | $3499.00 | $3499.00 | NVIDIA list price since July 2026 (was $1,999); SparkFun 2026-10-29: $3,499, backorder | https://marketplace.nvidia.com/en-us/enterprise/robotics-edge/jetson-agx-orin-developer-kit/
imu-backup | Low-cost USB AHRS IMU |  |  | 1 | 0 | 1 | $35.00 | $35.00 | estimate |  | backup IMU and bench use
nvme | NVMe SSD, 1 TB, M.2 2280 |  |  | 1 | 0 | 1 | $100.00 | $100.00 | estimate |  | the dev kit's 64 GB eMMC is too small for logs and datasets
camera | Orbbec Gemini 335L depth camera |  |  | 1 | 0 | 1 | $359.00 | $359.00 | Orbbec store list $359 (store page rate-limited 2026-10-29); RobotShop US $413 with tariffs | https://store.orbbec.com/products/gemini-335l | check the JetPack 7.2 driver before ordering
imu | Primary IMU (industrial AHRS; or BMI088 on a microcontroller) |  |  | 1 | 0 | 1 | $730.00 | $730.00 | distributor 2026-10 |  | decide after bench test; the existing USB AHRS IMU is the backup
 | Total compute & sensors |  |  |  |  |  |  | $4723

Sheet: Power
ID | Item | Model | Status | Qty | Spares | Lite qty | Unit USD | Line USD | Price basis | Source | Notes
charger | 13S charger adjustable to 4.1 V per cell |  |  | 1 | 0 | 1 | $300.00 | $300.00 | reseller 2026-10 |  | daily charging at 4.1 V per cell
bms | 13S smart BMS 150 A with CAN telemetry |  |  | 1 | 0 | 1 | $145.00 | $145.00 | 2026-10-29: JK 8-24S 150 A $145 (18650 Battery Store, sold out); Daly 13S 150 A with CAN also sold | https://www.18650batterystore.com/products/jk-b2a24s15p-bms | check its CAN protocol and precharge support
psu-bench | 48 V 20 A bench power supply |  |  | 1 | 0 | 1 | $250.00 | $250.00 | estimate |  | for bench and gantry tests
batt-conn | Anti-spark blind-mate battery connector (AS150 class) |  |  | 2 | 0 | 2 | $15.00 | $30.00 | estimate |  | one on the pack and one on the cradle
fuse | Class-T fuse 100-125 A with holder; limb branch fuses |  |  | 1 | 0 | 1 | $60.00 | $60.00 | estimate
dcdc-servo | DC-DC 48 V to 12 V, 10 A, compact (at most 60 x 34 x 25 mm) |  |  | 1 | 0 | 1 | $60.00 | $60.00 | estimate |  | the pelvis channel under the waist motor has room for 60 x 34 x 25 mm; a chassis-mount 150 W module does not fit
dcdc-compute | DC-DC 75 V-input to 19-20 V; at least 120 W (computer) |  |  | 1 | 0 | 1 | $80.00 | $80.00 | estimate |  | upstream of the contactor
ideal-diode | Ideal-diode OR circuit (LTC4359 class) for the computer rail |  |  | 1 | 0 | 1 | $40.00 | $40.00 | estimate
keepalive | Keep-alive battery 50-100 Wh for the computer |  |  | 1 | 0 | 1 | $80.00 | $80.00 | estimate |  | lets the computer stay up during a pack swap
contactor | Main contactor (48 V DC rated) |  |  | 1 | 0 | 1 | $60.00 | $60.00 | estimate |  | opened by the e-stop chain
cells | Molicel P45B 21700 cells |  |  | 39 | 0 | 39 | $9.95 | $388.05 | 2026-10-29: $9.95 (Batteries in a Flash, in stock); 18650 Battery Store $9.99 regular | https://www.18650batterystore.com/products/molicel-p45b | 13S3P pack ~630 Wh; buy from an authorised dealer
pack-hw | Pack housing; nickel strip; quick-release cradle |  |  | 1 | 0 | 1 | $80.00 | $80.00 | estimate
precharge | Precharge resistor and relay |  |  | 1 | 0 | 1 | $20.00 | $20.00 | estimate
regen-clamp | Regen clamp (brake resistor chopper or TVS ~56-58 V) |  |  | 1 | 0 | 1 | $40.00 | $40.00 | estimate |  | needed whenever a bench supply is used
 | Total power |  |  |  |  |  |  | $1633.05

Sheet: Electronics & wiring
ID | Item | Model | Status | Qty | Spares | Lite qty | Unit USD | Line USD | Price basis | Source | Notes
can-xcvr | 3.3 V CAN transceiver boards for the Orin's on-board CAN |  |  | 2 | 0 | 2 | $10.00 | $20.00 | estimate |  | arm buses
loop-ties | Cable ties, P-clips and spiral wrap for the service loops |  |  | 1 | 0 | 1 | $20.00 | $20.00 | estimate |  | each joint's service loop tied to a plate either side (electrical/harness.yaml lists the plates): ties through the plates' lightening pockets, P-clips under a screw where a plate has none; spiral wrap over each loop
column-driver | Column driver: 24 V H-bridge module (BTS7960 class) and a USB microcontroller board |  |  | 0 | 0 | 1 | $20.00 | $0.00 | estimate |  | Lite: drives the desk column's motor and reads its Hall sensor
usb-hub | Compact USB 3 hub, 4-port |  |  | 1 | 0 | 1 | $30.00 | $30.00 | estimate |  | the dev kit has 4 USB-A and 2 USB-C ports; the robot uses 3 CAN adapters, 3 servo adapters, the camera, the IMU and the gamepad receiver
servo-adapter | Feetech serial-bus USB adapter (Waveshare Bus Servo Adapter (A) class) |  |  | 1 | 0 | 1 | $5.00 | $5.00 | Waveshare 2026-10-29: $4.99 (SKU 25514) | https://www.waveshare.com/bus-servo-adapter-a.htm | STS3250 bus (neck and wrist pitch)
can-usb-dual | Isolated USB-CAN adapter, dual channel (InnoMaker USB2CAN-X2 class; SocketCAN) |  |  | 2 | 0 | 0 | $130.00 | $260.00 | unconfirmed 2026-10-29: no live US listing found; ~$126 (AED 462) at a UAE marketplace | https://github.com/INNO-MAKER/usb2can | one per leg (hip and shank buses), 3 kV isolation per its manual; with can-usb-batt and the Orin's two on-board ports (arm buses) this covers all 7 CAN buses in robot.yaml in the 3 adapter outlines of the electronics bay
can-usb-single | Isolated USB-CAN adapter, single channel (CANable Pro class; candleLight / gs_usb) |  |  | 2 | 0 | 2 | $60.00 | $120.00 | reseller listing 2026-10-29, unverified: CANable Pro $60, Pro 1.1 (5 kV) $70 | https://reach.dog/shop/openlight-labs/products/canable-pro-isolated-usb-to-can-adapter | one for the battery (BMS) bus, one for the actuator bench rig
limb-conn | Limb-root connectors: XT60-class power pair and latching signal pair, per limb |  |  | 4 | 0 | 2 | $12.00 | $48.00 | estimate |  | on the bulkheads beside each limb's first flange
clip-mounts | Push-in cable-tie mounts (fir-tree stem for a 6.5 mm hole in a 1-6 mm panel) |  |  | 27 | 6 | 14 | $0.30 | $9.90 | estimate |  | one in each 6.5 mm harness clip hole on a solid pad (cad/mounts.py: CLIP_HOLE), at the service loops electrical/harness.yaml lists; the thicker plates take the printed TPU edge clips (cad/clips.py) instead
can-robstride-dbg | RobStride USB-to-CAN debug adapter (official GUI tool) |  |  | 1 | 0 | 1 | $15.00 | $15.00 | Seeed listing 2026-10, unverified: $15 each, $14 at 10+ | https://www.seeedstudio.com/Robostride-CAN-USB-Driver-Board-p-6708.html | for RobStride's configuration GUI (IDs, firmware); check whether it works as a SocketCAN bus before using it on the robot
cable-grommets | Rubber grommets for the motor cable holes (20-30 mm holes in 2-4 mm plate) |  |  | 6 | 0 | 6 | $1.00 | $6.00 | estimate |  | where a motor's cable passes a plate: the thigh floors and pelvis top plate (hip yaw and waist RS03 caps) and the wrist brackets (RS00 rear faces); the RS10Ps' cables leave their sides, through no plate; 5 used, 1 spare
harness | Silicone wire; connectors; strain relief; sleeving |  |  | 1 | 0 | 1 | $200.00 | $200.00 | estimate
can-cable | Twisted-pair CAN cable, connectors and 120 Ω terminations |  |  | 1 | 0 | 1 | $50.00 | $50.00 | estimate
gamepad | Wireless gamepad |  |  | 1 | 0 | 1 | $60.00 | $60.00 | estimate
 | Total electronics & wiring |  |  |  |  |  |  | $843.9

Sheet: Structure & materials
ID | Item | Model | Status | Qty | Spares | Lite qty | Unit USD | Line USD | Price basis | Source | Notes
omni-wheel | 152 mm double aluminium omni wheel (40 kg rating) |  |  | 0 | 0 | 4 | $79.00 | $0.00 | reseller listing (Nov 2026), not confirmed by the maker |  | Lite's base: hub bolt pattern and bore assumed in cad/lite_base.py; confirm before machining the hubs
alu-6061 | 6061-T6 aluminium plate and bar stock |  |  | 1 | 0 | 1 | $300.00 | $300.00 | estimate |  | leg cores and brackets for both legs; about 6 kg of finished CNC 6061 across the robot (build_parts.csv)
idler-6805 | 6805-2RS ball bearing (25 x 37 x 7 mm) |  |  | 4 | 1 | 4 | $4.00 | $20.00 | estimate 2026-11 |  | the arm yokes' idlers on the shoulder roll and elbow RS10Ps' rear stubs (cad/arm.py IDLER)
bearing-6806 | 6806-2RS thin-section ball bearing (30 x 42 x 7 mm) for far-side joint support |  |  | 6 | 0 | 0 | $10.00 | $60.00 | 2026-10-29: $6.45 (Zoro, 61806-2RS) to CA$25.68 (VXB); budget grades ~$8 | https://www.zoro.com/ezo-deep-groove-30mm-bore-42mm-od-sealed-6806-2rsc0srl/i/G2080051 | hip roll, hip pitch and knee, both legs
bearing-6901 | 6901-2RS ball bearing (12 x 24 x 6 mm) for the wheel pods' outer plates |  |  | 0 | 0 | 4 | $3.00 | $0.00 | estimate
alu-7075 | 7075-T6 bar for highly loaded flanges and ankle cranks |  |  | 1 | 0 | 1 | $100.00 | $100.00 | estimate
materials-upper | Aluminium and filament for torso; arms; head |  |  | 1 | 0 | 1 | $250.00 | $250.00 | estimate
push-rods | Ankle push rods (steel tube with threaded inserts) |  |  | 4 | 0 | 0 | $10.00 | $40.00 | estimate |  | two per ankle
fil-cfnylon | Carbon-fibre nylon filament (kg) |  |  | 2 | 0 | 1 | $95.00 | $190.00 | typical first-party price 2026-10 |  | structural and hidden functional prints (battery guides and latch, jigs); the shells are PETG; needs a hardened nozzle and dry storage
crossed-roller | Crossed-roller bearing for the waist |  |  | 1 | 0 | 1 | $80.00 | $80.00 | reseller range $20-80
rod-ends | M6 steel-ball rod ends for ankle push rods |  |  | 8 | 0 | 0 | $8.00 | $64.00 | estimate |  | two per push rod; size from simulated linkage loads
base-plates | Online laser or water-jet cutting: Lite's 6 mm floor plate and 4 mm deck plate (6061) |  |  | 0 | 0 | 1 | $150.00 | $0.00 | estimate, not quoted
machining-pelvis | Online machining: pelvis back (20 mm, 3D), pelvis top and two gussets (6 mm plates) |  |  | 1 | 0 | 0 | $400.00 | $400.00 | estimate, not quoted (typical online CNC price) |  | too large for a desktop mill; process "service" in build_parts.csv
machining-legs | Online machining: shin inner and outer plates, foot bases (6 pocketed 4-5 mm 6061 plates) |  |  | 1 | 0 | 0 | $450.00 | $450.00 | estimate, not quoted (typical online CNC price for pocketed plates) |  | too large for a desktop mill; process "service" in build_parts.csv
machining-torso | Online machining: two torso uprights (25 mm 6061; 3D) |  |  | 1 | 0 | 1 | $350.00 | $350.00 | estimate, not quoted (typical online CNC price) |  | too large for a desktop mill; process "service" in build_parts.csv
fil-petg | PETG filament, white (kg) |  |  | 2 | 0 | 2 | $20.00 | $40.00 | typical price 2026-11 |  | the body shells and head panels (about 1 kg printed, white); the visor band and camera frame in black PETG
fil-petgcf | PETG-CF filament (kg) |  |  | 2 | 0 | 2 | $33.00 | $66.00 | typical price 2026-10 |  | jigs and non-structural parts
base-springs | Pod compression springs: music wire 1.8 mm, mean dia 13 mm, 11.6 active coils, free 60 mm, ground ends (about 4.1 N/mm); urethane bump-stop tubes 10 x 6.5 x 32 mm |  |  | 0 | 0 | 4 | $4.00 | $0.00 | estimate: a stock spring near this size, or made to order |  | Lite: sized in cad/lite_base.py spring_rates() (12.5 N/mm at the wheel, 100 N at mid travel, 782 MPa at the bump stop)
fil-tpu | TPU 95A filament (kg) |  |  | 1 | 0 | 1 | $42.00 | $42.00 | typical price 2026-10 |  | soles and bumpers
 | Total structure & materials |  |  |  |  |  |  | $2452

Sheet: Fasteners
ID | Item | Model | Status | Qty | Spares | Lite qty | Unit USD | Line USD | Price basis | Source | Notes
fasteners | Metric fasteners; heat-set inserts; dowel pins; threadlocker |  |  | 1 | 0 | 1 | $180.00 | $180.00 | estimate |  | includes the 348 actuator bolts in build_fasteners.csv (12.9 socket head, M3-M5)
 | Total fasteners |  |  |  |  |  |  | $180

Sheet: Tooling
ID | Item | Model | Status | Qty | Spares | Lite qty | Unit USD | Line USD | Price basis | Source | Notes
spot-welder | Battery spot welder and pack supplies (fish paper, insulating rings, Kapton) |  |  | 1 | 0 | 1 | $150.00 | $150.00 | estimate |  | or have the pack built by a battery shop
endmills | Carbide 3-flute end mills for aluminium (1/8 and 1/4 in) |  |  | 8 | 0 | 8 | $20.00 | $160.00 | reseller range $14-33
hand-tools | Hand tools: torque screwdriver and hex bits, crimp tools, multimeter, digital scale (5 kg x 1 g) |  |  | 1 | 0 | 1 | $200.00 | $200.00 | estimate |  | the scale weighs parts against the mass budget; a desktop CNC mill and 3D printer are assumed and not counted
print-tools | Hardened-steel nozzle and filament dryer |  |  | 1 | 0 | 1 | $80.00 | $80.00 | estimate |  | carbon-fibre nylon wears brass nozzles and must be printed dry
leg-jig | Single-leg test jig (aluminium extrusion) |  |  | 1 | 0 | 0 | $120.00 | $120.00 | estimate
 | Total tooling |  |  |  |  |  |  | $710

Sheet: Safety
ID | Item | Model | Status | Qty | Spares | Lite qty | Unit USD | Line USD | Price basis | Source | Notes
padding | Fall padding foam |  |  | 1 | 0 | 0 | $50.00 | $50.00 | estimate
gantry | Gantry frame; harness and hoist |  |  | 1 | 0 | 0 | $300.00 | $300.00 | estimate
estop-wired | Latching e-stop button and contactor driver |  |  | 1 | 0 | 1 | $40.00 | $40.00 | estimate
estop-rf | Wireless e-stop: handheld transmitter; receiver and watchdog relay |  |  | 1 | 0 | 1 | $80.00 | $80.00 | estimate |  | in series with the wired e-stop
 | Total safety |  |  |  |  |  |  | $470

Sheet: Sourcing
ID | Vendor | Kind | URL | Unit USD | Tiers | Availability | Checked | Confirmed | Notes
bearing-6806 | Simply Bearings | distributor | https://simplybearings.co.uk/shop/p170125/68062RS-Budget-Rubber-Sealed-Thin-Section-Deep-Groove-Ball-Bearing-30x42x7mm/product_info.html |  | £6.33 ex VAT; £5.64 at 4+ |  | 2026-10-29 | yes | budget grade
bearing-6806 | Zoro | distributor | https://www.zoro.com/ezo-deep-groove-30mm-bore-42mm-od-sealed-6806-2rsc0srl/i/G2080051 |  |  |  | 2026-10-29 | no | EZO 6806-2RS; a 61806-2RS listing showed $6.45
bms | 18650 Battery Store | dealer | https://www.18650batterystore.com/products/jk-b2a24s15p-bms | $145.00 |  | sold out | 2026-10-29 | yes | JK-B2A24S15P, 8-24S 150 A, 2 A active balancing; confirm its CAN protocol
camera | Orbbec store | official | https://store.orbbec.com/products/gemini-335l | $359.00 |  |  | 2026-10-29 | no | store page rate-limited; $359 is the list price shown by resellers
camera | RobotShop | distributor | https://www.robotshop.com/products/orbbec-gemini-335l-camera | $413.00 |  | 5 in stock | 2026-10-29 | yes | includes US tariffs
can-robstride-dbg | Seeed Studio | official reseller | https://www.seeedstudio.com/Robostride-CAN-USB-Driver-Board-p-6708.html | $15.00 | $14 at 10+ |  | 2026-10 | no | price from an earlier check; not reopened
can-usb-dual | Carrefour UAE marketplace | marketplace | https://www.carrefouruae.com/mafuae/en/miscellaneous/innomaker-dual-channels-usb-to-can-converter-for-raspberry-pi5-4-pi3b-pi3-pi-zero-w-jetson-nano-tinker-bo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 | $126.00 |  |  | 2026-10-29 | no | AED 462 incl. VAT; the only listing with a price
can-usb-dual | InnoMaker USB2CAN-X2 (docs) | official | https://github.com/INNO-MAKER/usb2can |  |  |  | 2026-10-29 | yes | two channels, 3 kV isolation, SocketCAN; no live US price found
can-usb-single | Openlight Labs (CANable Pro) | official | https://reach.dog/shop/openlight-labs/products/canable-pro-isolated-usb-to-can-adapter | $60.00 |  |  | 2026-10-29 | no | Pro 1.1 (5 kV) $70; candleLight firmware gives gs_usb SocketCAN
can-usb-single | RobotShop (CANable Pro clone) | distributor | https://robotshop.com/products/eyou-robotics-can-usb-adapter-canable-pro | $42.00 |  |  | 2026-10-29 | no | third-party CANable Pro build
cells | 18650 Battery Store | authorised dealer | https://www.18650batterystore.com/products/molicel-p45b | $9.99 | sale $5.19 when in stock | sold out | 2026-10-29 | yes | regular price $9.99
cells | Batteries in a Flash | dealer | https://www.batteriesinaflash.com/regular-rechargeable-batteries/molicel-inr-21700-p45b-3-6-volt-4500mah-45a-lithium-ion-cell | $9.95 | $8.95 at 600+ | in stock | 2026-10-29 | yes
compute | CNX Software (news) | price report | https://www.cnx-software.com/2026/07/22/nvidia-increases-the-price-of-jetson-modules-and-devkits-by-up-to-101/ | $3499.00 |  |  | 2026-10-29 | yes | source for the July 2026 price change
compute | NVIDIA Marketplace | official | https://marketplace.nvidia.com/en-us/enterprise/robotics-edge/jetson-agx-orin-developer-kit/ | $3499.00 |  | reported out of stock 2026-10-21 | 2026-10-29 | no | page timed out; list price raised from $1,999 to $3,499 in July 2026 (NVIDIA developer FAQ, reported by CNX Software)
compute | SparkFun | distributor | https://www.sparkfun.com/nvidia-jetson-agx-orin-64gb-developer-kit.html | $3499.00 |  | backorder | 2026-10-29 | yes | SKU DEV-22099
dcdc-servo | Bravo Electro | distributor | https://www.bravoelectro.com/ddr-120c-12.html | $67.26 | $61.24 at 10+ |  | 2026-10-29 | yes | Mean Well DDR-120C-12 (33.6-67.2 V in, 12 V 10 A) is a DIN-rail module and too big for the pelvis channel; reference price only
hand-kit | Pollen Robotics AmazingHand | open-source design | https://github.com/pollen-robotics/AmazingHand |  |  |  | 2026-10-29 | yes | bill of materials and print files for building the hand from parts (the project gives under €200 per hand, plus the control board)
hand-kit | Seeed Studio (left) | official reseller | https://www.seeedstudio.com/Amazing-Hand-Open-Source-3D-Printable-Robotic-Hand-Kit.html | $99.00 | $97 at 10+ | in stock, China warehouse | 2026-10-29 | yes | SKU 100062181; box contents not listed
hand-kit | Seeed Studio (right) | official reseller | https://www.seeedstudio.com/Amazing-Hand-Right-Hand-The-Open-Source-Robotic-Hand-Developer-Kit.html | $99.00 | $97 at 10+ | in stock, China warehouse | 2026-10-29 | yes | SKU 100063642; box contents not listed
rs00 | Seeed Studio | official reseller | https://www.seeedstudio.com/Robostride-00-Actuator-p-6664.html | $138.99 | $131.99 at 10+ | in stock, China warehouse | 2026-10-29 | yes | RobStride list $125
rs03 | Seeed Studio | official reseller | https://www.seeedstudio.com/Robostride-03-Actuator-p-6774.html | $225.00 | $214 at 10+ | in stock, China warehouse | 2026-10-29 | yes
rs04 | Seeed Studio | official reseller | https://www.seeedstudio.com/Robostride-04-Actuator-p-6775.html | $255.00 | $242 at 10+ | in stock, China warehouse; lead time not shown | 2026-10-29 | yes | RobStride's own site links to Seeed and Amazon for ordering
rs10p | OpenELAB | reseller | https://openelab.io/products/robstride-10p-qdd-joint-actuator | $233.99 |  | pre-order (restock date shown had passed) | 2026-11-02 | no | search-result listing; page not loaded (rate-limited)
servo-adapter | Feetech FE-URT-1 (RobotShop UK) | distributor | https://uk.robotshop.com/products/fe-urt-1-usb-to-ttl-485-bus-programmer |  | £13.67 | 1 left | 2026-10-29 | yes | Feetech's own programmer; alternative
servo-adapter | Waveshare | official | https://www.waveshare.com/bus-servo-adapter-a.htm | $4.99 |  |  | 2026-10-29 | yes | Bus Servo Adapter (A) SKU 25514; supports ST and SC series
sts3250 | AIFit Lab | reseller | https://aifitlab.com/products/feetech-sts3250-servo-motor | $97.00 |  | backordered | 2026-10-29 | yes | ST-3250-C001 with bracket
sts3250 | OpenELAB | reseller | https://openelab.io/products/feetech-sts3250-c002-servo-12v |  | €75.85 |  | 2026-10-29 | yes | STS3250-C002 variant (12 V, 50 kg·cm, 1:345); check it suits the neck and wrist
sts3250 | RCDrone | reseller | https://rcdrone.top/products/feetech-sts3250-servo-motor | $125.00 |  | sold out | 2026-10-29 | yes

Sheet: Made parts (CAD)
Part | Qty | Process | Material | Form | Stock mm | Mass g | Size mm | Notes | Status | Build notes
elec_battery_socket | 1 | bought | bought |  |  | 15.0 | 31 x 21 x 11 | battery connector, cradle half (AS150 class), at the front of the battery bay
elec_bulkhead_arm_{side} | 2 | bought | bought |  |  | 15.0 | 30 x 28 x 10 | arm power and signal connectors
elec_bulkhead_leg_{side} | 2 | bought | bought |  |  | 15.0 | 30 x 28 x 12 | leg power (XT60 class) and signal connectors
elec_can_usb_1 | 1 | bought | bought |  |  | 35.0 | 60 x 22 x 12 | isolated USB-CAN adapter
elec_can_usb_2 | 1 | bought | bought |  |  | 35.0 | 60 x 22 x 12 | isolated USB-CAN adapter
elec_can_usb_3 | 1 | bought | bought |  |  | 35.0 | 60 x 22 x 12 | isolated USB-CAN adapter
elec_contactor | 1 | bought | bought |  |  | 180.0 | 50 x 45 x 35 | main contactor, 48 V DC, opened by the e-stop chain
elec_dcdc_compute | 1 | bought | bought |  |  | 120.0 | 60 x 40 x 13 | DC-DC 48 V to 19-20 V, 120 W+, ahead of the contactor
elec_dcdc_servo | 1 | bought | bought |  |  | 110.0 | 60 x 34 x 25 | DC-DC 48 V to 12 V, 10 A (servos)
elec_estop_relay | 1 | bought | bought |  |  | 60.0 | 40 x 35 x 14 | wireless e-stop receiver and watchdog relay
elec_harness_pelvis | 1 | bought | bought |  |  | 220.0 | 10 x 10 x 10 | harness allowance: pelvis (limb-root connectors on the bulkheads)
elec_harness_torso | 1 | bought | bought |  |  | 270.0 | 10 x 10 x 10 | harness allowance: torso (limb-root connectors on the bulkheads)
elec_imu | 1 | bought | bought |  |  | 60.0 | 40 x 30 x 20 | IMU on the pelvis, in the top box
elec_power_board_pelvis | 1 | bought | bought |  |  | 150.0 | 80 x 50 x 34 | pelvis power board: leg branch fuses
elec_power_board_torso | 1 | bought | bought |  |  | 90.0 | 50 x 30 x 12 | torso power board: bus bars, arm branch fuses
elec_precharge | 1 | bought | bought |  |  | 30.0 | 40 x 35 x 12 | precharge resistor and relay, across the contactor
head_camera | 1 | bought | bought |  |  | 133.0 | 124 x 29 x 27
pelvis_roll_bearing_{side} | 2 | bought | bought |  |  | 90.0 | 76 x 76 x 8 | RA6008 crossed-roller bearing (60 x 76 x 8 mm)
waist_bearing | 1 | bought | bought |  |  | 90.0 | 76 x 76 x 8 | RA6008 crossed-roller bearing (60 x 76 x 8 mm)
{side}_ankle_rod_a | 2 | bought | bought |  |  | 30.0 | 91 x 20 x 11 | steel tube with two M6 rod ends
{side}_ankle_rod_b | 2 | bought | bought |  |  | 45.0 | 191 x 50 x 11 | steel tube with two M6 rod ends
{side}_elbow_idler | 2 | bought | bought |  |  | 22.0 | 37 x 37 x 7 | 6805-2RS ball bearing: the elbow yoke's idler on the motor's rear stub
{side}_hand | 2 | bought | bought |  |  | 400.0 | 170 x 134 x 119 | AmazingHand by Pollen Robotics (CC-BY-4.0), description/third_party/amazing_hand
{side}_hip_pitch_bearing | 2 | bought | bought |  |  | 25.0 | 42 x 42 x 7 | 6806-2RS far-side bearing
{side}_hip_yaw_bearing | 2 | bought | bought |  |  | 90.0 | 76 x 76 x 8 | RA6008 crossed-roller bearing (60 x 76 x 8 mm)
{side}_knee_bearing | 2 | bought | bought |  |  | 25.0 | 42 x 42 x 7 | 6806-2RS far-side bearing
{side}_shoulder_roll_idler | 2 | bought | bought |  |  | 22.0 | 37 x 37 x 7 | 6805-2RS ball bearing: the shoulder roll yoke's idler
{side}_wrist_idler_pin | 2 | bought | bought |  |  | 4.0 | 9 x 8 x 8 | M4 shoulder screw, 8 mm shoulder: the hand mount's idler pivot
torso_foot_{side} | 2 | cnc | al6061 | flat 6.0 mm | 6 | 40.8 | 140 x 18 x 6
torso_strut_l0 | 1 | cnc | al6061 | flat 10.5 mm | 12 | 8.1 | 24 x 12 x 10
torso_strut_l1 | 1 | cnc | al6061 | flat 10.5 mm | 12 | 8.1 | 24 x 12 x 10
torso_strut_r0 | 1 | cnc | al6061 | flat 10.5 mm | 12 | 8.1 | 24 x 12 x 10
torso_strut_r1 | 1 | cnc | al6061 | flat 10.5 mm | 12 | 8.1 | 24 x 12 x 10
torso_waist_flange | 1 | cnc | al6061 | 3D | 6 | 97.0 | 96 x 96 x 6
{side}_foot_lug_back | 2 | cnc | al6061 | flat 8.0 mm | 8 | 41.1 | 66 x 36 x 8
{side}_foot_post_a | 2 | cnc | al6061 | flat 16.0 mm | 20 | 29.2 | 42 x 16 x 16
{side}_foot_post_b | 2 | cnc | al6061 | flat 16.0 mm | 20 | 29.2 | 42 x 16 x 16
{side}_foot_rib_a | 2 | cnc | al6061 | flat 4.0 mm | 4 | 25.9 | 150 x 16 x 4
{side}_foot_rib_b | 2 | cnc | al6061 | flat 4.0 mm | 4 | 25.9 | 150 x 16 x 4
{side}_foot_rib_c | 2 | cnc | al6061 | flat 4.0 mm | 4 | 22.0 | 102 x 20 x 4
{side}_hip_pitch_flange | 2 | cnc | al6061 | 3D | 4 | 42.4 | 80 x 80 x 4
{side}_hip_pitch_inner | 2 | cnc | al6061 | flat 4.0 mm | 4 | 81.0 | 170 x 80 x 4
{side}_hip_pitch_stub | 2 | cnc | al6061 | flat 12.0 mm | 12 | 21.0 | 30 x 30 x 12
{side}_shin_bridge_spacer | 2 | cnc | al6061 | flat 2.0 mm | 3 | 1.4 | 24 x 24 x 2
{side}_shin_knee_outer | 2 | cnc | al6061 | 3D | 8 | 97.9 | 121 x 100 x 8
{side}_shin_spacer_0 | 2 | cnc | al6061 | 3D | 20 | 22.4 | 58 x 16 x 16
{side}_shin_spacer_1 | 2 | cnc | al6061 | 3D | 20 | 22.4 | 58 x 16 x 16
{side}_thigh_knee_mount | 2 | cnc | al6061 | 3D | 15 | 61.4 | 120 x 120 x 14
{side}_thigh_knee_stub | 2 | cnc | al6061 | flat 12.0 mm | 12 | 21.0 | 30 x 30 x 12
head_frame | 1 | cnc | al7075 | flat 6.0 mm | 6 | 26.5 | 98 x 16 x 6
head_frame_bridge | 1 | cnc | al7075 | flat 4.0 mm | 4 | 13.3 | 40 x 30 x 4
head_frame_side_horn | 1 | cnc | al7075 | flat 3.0 mm | 3 | 16.2 | 110 x 18 x 3
head_frame_side_idler | 1 | cnc | al7075 | flat 3.0 mm | 3 | 16.2 | 110 x 18 x 3
head_frame_top | 1 | cnc | al7075 | flat 4.0 mm | 4 | 7.8 | 40 x 18 x 4
neck_bracket | 1 | cnc | al7075 | flat 2.5 mm | 3 | 13.8 | 50 x 40 x 2
neck_cheek_{side} | 2 | cnc | al7075 | flat 2.5 mm | 3 | 15.2 | 53 x 42 x 2
neck_hub | 1 | cnc | al7075 | flat 7.0 mm | 8 | 6.2 | 20 x 20 x 7
pelvis_gusset_front_{side} | 2 | cnc | al7075 | flat 8.0 mm | 8 | 252.2 | 212 x 135 x 8
pelvis_keel_floor | 1 | cnc | al7075 | flat 3.0 mm | 3 | 31.0 | 97 x 38 x 3
pelvis_roll_carrier_{side} | 2 | cnc | al7075 | 3D | 15 | 120.0 | 120 x 120 x 12
pelvis_roll_mount_{side} | 2 | cnc | al7075 | 3D | 15 | 78.9 | 120 x 120 x 14
pelvis_top | 1 | cnc | al7075 | flat 4.0 mm | 4 | 197.1 | 234 x 124 x 4
pelvis_waist_cage | 1 | cnc | al7075 | flat 55.1 mm | 60 | 111.5 | 107 x 107 x 55
pelvis_waist_ring | 1 | cnc | al7075 | 3D | 12 | 122.3 | 112 x 112 x 12
torso_base | 1 | cnc | al7075 | flat 2.5 mm | 3 | 112.7 | 150 x 122 x 2
torso_battery_shelf | 1 | cnc | al7075 | flat 1.5 mm | 3 | 20.4 | 155 x 60 x 2
torso_bridge | 1 | cnc | al7075 | flat 8.0 mm | 8 | 192.0 | 112 x 108 x 8
torso_compute_plate | 1 | cnc | al7075 | flat 1.5 mm | 3 | 27.1 | 115 x 104 x 2
torso_shoulder_cage_{side} | 2 | cnc | al7075 | flat 41.6 mm | 50 | 46.8 | 119 x 119 x 42
torso_shoulder_plate_{side} | 2 | cnc | al7075 | flat 6.0 mm | 6 | 114.5 | 146 x 134 x 6
torso_shoulder_ring_{side} | 2 | cnc | al7075 | 3D | 5 | 51.5 | 119 x 119 x 5
torso_spacer_l0 | 1 | cnc | al7075 | flat 17.3 mm | 20 | 20.7 | 22 x 22 x 17
torso_spacer_l1 | 1 | cnc | al7075 | flat 17.3 mm | 20 | 20.7 | 22 x 22 x 17
torso_spacer_r0 | 1 | cnc | al7075 | flat 17.3 mm | 20 | 20.7 | 22 x 22 x 17
torso_spacer_r1 | 1 | cnc | al7075 | flat 17.3 mm | 20 | 20.7 | 22 x 22 x 17
torso_waist_hub | 1 | cnc | al7075 | 3D | 10 | 38.2 | 66 x 66 x 9
{side}_ankle_crank_a | 2 | cnc | al7075 | 3D | 15 | 43.9 | 86 x 36 x 13
{side}_ankle_crank_b | 2 | cnc | al7075 | 3D | 15 | 43.9 | 86 x 36 x 13
{side}_ankle_cross | 2 | cnc | al7075 | 3D | 30 | 48.9 | 53 x 44 x 30
{side}_elbow_idler_stub | 2 | cnc | al7075 | 3D | 12 | 23.0 | 50 x 50 x 11
{side}_foot_lug_front | 2 | cnc | al7075 | flat 8.0 mm | 8 | 42.8 | 66 x 36 x 8
{side}_forearm_frame | 2 | cnc | al7075 | 3D | 5 | 72.8 | 132 x 72 x 5
{side}_forearm_hub | 2 | cnc | al7075 | flat 4.0 mm | 4 | 8.0 | 34 x 34 x 4
{side}_forearm_yoke | 2 | cnc | al7075 | 3D | 60 | 70.8 | 87 x 77 x 58
{side}_hand_arm_horn | 2 | cnc | al7075 | flat 3.0 mm | 3 | 4.9 | 29 x 22 x 3
{side}_hand_arm_idler | 2 | cnc | al7075 | flat 3.0 mm | 3 | 3.3 | 26 x 22 x 3
{side}_hand_mount | 2 | cnc | al7075 | flat 4.0 mm | 4 | 35.7 | 68 x 53 x 4
{side}_hip_pitch_back | 2 | cnc | al7075 | flat 3.0 mm | 3 | 27.9 | 69 x 68 x 3
{side}_hip_pitch_front | 2 | cnc | al7075 | flat 3.0 mm | 3 | 27.3 | 69 x 68 x 3
{side}_hip_pitch_mount | 2 | cnc | al7075 | 3D | 15 | 67.7 | 120 x 120 x 14
{side}_hip_pitch_outer | 2 | cnc | al7075 | 3D | 8 | 129.5 | 168 x 76 x 8
{side}_hip_pitch_top | 2 | cnc | al7075 | 3D | 3 | 52.2 | 109 x 96 x 3
{side}_hip_roll_front | 2 | cnc | al7075 | 3D | 5 | 105.8 | 141 x 98 x 5
{side}_hip_roll_hub | 2 | cnc | al7075 | 3D | 10 | 37.3 | 66 x 66 x 9
{side}_hip_roll_web | 2 | cnc | al7075 | flat 6.0 mm | 6 | 188.9 | 154 x 128 x 6
{side}_hip_yaw_hub | 2 | cnc | al7075 | 3D | 10 | 38.2 | 66 x 66 x 9
{side}_shin_bridge | 2 | cnc | al7075 | 3D | 25 | 40.8 | 58 x 24 x 24
{side}_shoulder_flange | 2 | cnc | al7075 | flat 6.0 mm | 6 | 107.3 | 101 x 92 x 6
{side}_shoulder_hub | 2 | cnc | al7075 | flat 3.0 mm | 3 | 30.6 | 70 x 70 x 3
{side}_shoulder_roll_front | 2 | cnc | al7075 | 3D | 8 | 123.5 | 152 x 112 x 7
{side}_shoulder_roll_hub | 2 | cnc | al7075 | flat 5.0 mm | 5 | 10.0 | 34 x 34 x 5
{side}_shoulder_roll_idler_stub | 2 | cnc | al7075 | 3D | 12 | 23.0 | 50 x 50 x 11
{side}_shoulder_roll_ring | 2 | cnc | al7075 | 3D | 6 | 56.2 | 81 x 73 x 6
{side}_shoulder_roll_top | 2 | cnc | al7075 | flat 2.5 mm | 3 | 41.8 | 90 x 80 x 2
{side}_shoulder_roll_yoke | 2 | cnc | al7075 | flat 8.0 mm | 8 | 47.6 | 74 x 49 x 8
{side}_shoulder_yaw_ring | 2 | cnc | al7075 | 3D | 8 | 60.1 | 112 x 92 x 7
{side}_thigh_cage | 2 | cnc | al7075 | flat 55.1 mm | 60 | 39.6 | 94 x 94 x 55
{side}_thigh_floor | 2 | cnc | al7075 | flat 6.0 mm | 6 | 132.4 | 124 x 124 x 6
{side}_thigh_plate | 2 | cnc | al7075 | flat 5.0 mm | 5 | 159.2 | 182 x 124 x 5
{side}_thigh_rib_back | 2 | cnc | al7075 | flat 6.0 mm | 6 | 17.2 | 61 x 17 x 6
{side}_thigh_rib_front | 2 | cnc | al7075 | flat 6.0 mm | 6 | 17.2 | 61 x 17 x 6
{side}_thigh_yaw_ring | 2 | cnc | al7075 | 3D | 12 | 107.9 | 112 x 112 x 12
{side}_upper_arm_hub | 2 | cnc | al7075 | flat 2.0 mm | 3 | 4.0 | 34 x 34 x 2
{side}_upper_arm_ring | 2 | cnc | al7075 | 3D | 6 | 72.5 | 84 x 84 x 6
{side}_upper_arm_strap | 2 | cnc | al7075 | flat 5.0 mm | 5 | 93.9 | 130 x 96 x 5
{side}_wrist_bracket | 2 | cnc | al7075 | flat 3.5 mm | 4 | 29.6 | 66 x 63 x 4
{side}_wrist_cradle | 2 | cnc | al7075 | 3D | 3 | 15.9 | 55 x 55 x 3
{side}_wrist_cradle_back | 2 | cnc | al7075 | flat 3.0 mm | 3 | 11.1 | 44 x 31 x 3
{side}_wrist_cradle_side_{side} | 4 | cnc | al7075 | flat 3.0 mm | 3 | 6.6 | 30 x 26 x 3
neck_cover | 1 | cover | petg | 3D |  | 59.6 | 93 x 92 x 92
pelvis_cover_back | 1 | cover | petg | 3D |  | 20.4 | 200 x 92 x 56
pelvis_cover_front | 1 | cover | petg | 3D |  | 11.7 | 143 x 68 x 56
torso_cover_back_l_waist | 1 | cover | petg | 3D |  | 51.1 | 174 x 107 x 98
torso_cover_back_r_waist | 1 | cover | petg | 3D |  | 51.1 | 174 x 107 x 98
torso_cover_back_{side} | 2 | cover | petg | 3D |  | 69.7 | 219 x 106 x 98
torso_cover_front_l_waist | 1 | cover | petg | 3D |  | 52.1 | 174 x 112 x 98
torso_cover_front_r_waist | 1 | cover | petg | 3D |  | 52.1 | 174 x 112 x 98
torso_cover_front_{side} | 2 | cover | petg | 3D |  | 65.1 | 219 x 113 x 98
{side}_forearm_cover | 2 | cover | petg | 3D |  | 24.1 | 90 x 80 x 76
{side}_shin_cover | 2 | cover | petg | 3D |  | 57.7 | 188 x 103 x 103
{side}_shoulder_cover | 2 | cover | petg | 3D |  | 6.6 | 104 x 66 x 63
{side}_thigh_cover | 2 | cover | petg | 3D |  | 63.8 | 201 x 134 x 134
{side}_toe_cover | 2 | cover | petg | 3D |  | 15.7 | 119 x 99 x 64
{side}_upper_arm_cover | 2 | cover | petg | 3D |  | 21.7 | 104 x 97 x 82
{side}_upper_thigh_cover | 2 | cover | petg | 3D |  | 14.6 | 108 x 91 x 64
torso_battery_guides | 1 | print | pa_cf | 3D |  | 7.9 | 147 x 60 x 20
torso_battery_latch | 1 | print | pa_cf | 3D |  | 34.3 | 130 x 60 x 4
head_camera_frame | 1 | print | petg | 3D |  | 9.0 | 131 x 36 x 11
head_shell_cheek_{side} | 2 | print | petg | 3D |  | 23.7 | 100 x 95 x 34
head_shell_chin | 1 | print | petg | 3D |  | 19.5 | 147 x 40 x 32
head_shell_crown | 1 | print | petg | 3D |  | 85.9 | 199 x 153 x 26
head_shell_rear | 1 | print | petg | 3D |  | 52.1 | 155 x 95 x 58
head_visor | 1 | print | petg | 3D |  | 21.3 | 153 x 63 x 44
pelvis_back_clip_{side} | 2 | print | tpu | 3D |  | 1.6 | 26 x 15 x 14 | harness edge clip for a 10 mm plate (cad/clips.py)
torso_bridge_clip | 1 | print | tpu | 3D |  | 1.6 | 24 x 12 x 10 | harness edge clip for a 8 mm plate (cad/clips.py)
{side}_foot_sole | 2 | print | tpu | 3D |  | 78.6 | 240 x 110 x 3
{side}_hip_pitch_outer_clip | 2 | print | tpu | 3D |  | 1.6 | 24 x 12 x 10 | harness edge clip for a 8 mm plate (cad/clips.py)
{side}_shoulder_roll_front_clip | 2 | print | tpu | 3D |  | 1.6 | 26 x 20 x 12 | harness edge clip for a 7 mm plate (cad/clips.py)
pelvis_back | 1 | service | al7075 | flat 10.0 mm | 10 | 632.9 | 324 x 135 x 10
torso_upright_{side} | 2 | service | al7075 | flat 3.0 mm | 3 | 116.8 | 314 x 149 x 3
{side}_foot_base | 2 | service | al7075 | flat 4.0 mm | 4 | 96.9 | 230 x 100 x 4
{side}_shin_inner | 2 | service | al7075 | flat 4.0 mm | 4 | 198.5 | 379 x 140 x 4
{side}_shin_outer | 2 | service | al7075 | flat 5.0 mm | 5 | 186.7 | 310 x 160 x 5

Sheet: Actuator bolts (CAD)
Actuator | Face | Thread | Qty | Notes | Status
RS00 | output | M3 | 12 | socket head, 12.9; length = plate + thread engagement, per part
RS00 | rear | M3 | 8 | socket head, 12.9; length = plate + thread engagement, per part
RS00 | stator | M3 | 12 | socket head, 12.9; length = plate + thread engagement, per part
RS03 | output | M4 | 54 | socket head, 12.9; length = plate + thread engagement, per part
RS03 | stator | M4 | 72 | socket head, 12.9; length = plate + thread engagement, per part
RS04 | output | M5 | 54 | socket head, 12.9; length = plate + thread engagement, per part
RS04 | stator | M4 | 60 | socket head, 12.9; length = plate + thread engagement, per part
RS10P | output | M4 | 36 | socket head, 12.9; length = plate + thread engagement, per part
RS10P | rear | M3 | 8 | socket head, 12.9; length = plate + thread engagement, per part
RS10P | stator | M4 | 36 | socket head, 12.9; length = plate + thread engagement, per part
