kranthie/marvin-bot/site/src/content/docs/guide/sources.mdx

---
title: "Sources"
description: "Every source cited in the guide (184 in all), grouped by kind, with what it was used for and the pages that cite it."
sidebar:
  label: "Sources"
  order: 901
---

import '../../../guide/sources/style.css';

Every source cited in the guide (184 in all), grouped by kind, with what it was used for and the pages that cite it. Each playground also lists its own sources, numbered as they are cited on that page.

:::tip[The project itself]
Marvin Bot's own numbers and decisions come from its repository, [github.com/kranthie/marvin-bot](https://github.com/kranthie/marvin-bot): `README.md`, `docs/` (plan, decisions, roadmap, requirements, safety, skills, design notes), `description/`, `cad/`, `sim/`, `tools/`, `electrical/`, `bom/bom.xlsx` and `ACKNOWLEDGMENTS.md`, as of 2026-10-29.
:::

:::note[Credits]
This guide was researched and written with Claude (Anthropic), as was much of the Marvin Bot project. Open-source projects, papers, datasheets and documentation are credited below; no text or figures are copied from them beyond short cited facts. Hand meshes and designs belong to their authors (AmazingHand by Pollen Robotics, CC-BY-4.0).
:::

## Papers

1. [A. A. Biewener, Biomechanical consequences of scaling, J. Exp. Biol. 2005](https://doi.org/10.1242/jeb.01520) <span class="used">— how animals compensate for scaling · cited on [07](../07-mass-proportions/)</span>
2. [A. Ghanbarzadeh, E. Najafi, Safe physical human-robot interaction through variable impedance control based on ISO/TS 15066, arXiv:2311.13814, 2023](https://arxiv.org/abs/2311.13814) <span class="used">— table of ISO/TS 15066 maximum permissible force, effective spring constant and effective mass per body region; vmax = F/√(μk); reduced mass. · cited on [12](../12-safety/)</span>
3. [A. Kumar et al., RMA: Rapid Motor Adaptation for Legged Robots, RSS 2021 (arXiv 2107.04034)](https://arxiv.org/abs/2107.04034) <span class="used">— online adaptation from history. · cited on [20](../20-sim-to-real/)</span>
4. [A. L. Hof, M. G. J. Gazendam, W. E. Sinke, The condition for dynamic stability, J. Biomech. 2005](https://doi.org/10.1016/j.jbiomech.2004.03.025) <span class="used">— extrapolated centre of mass · cited on [02](../02-balance/)</span>
5. [Araujo et al., Retargeting Matters (GMR), arXiv:2510.02252 (2025)](https://arxiv.org/abs/2510.02252) <span class="used">— GMR, non-uniform scaling, retargeting artefacts hurt tracking · cited on [17](../17-motion-tracking/)</span>
6. [B. Katz, J. Di Carlo, S. Kim, "Mini Cheetah: A Platform for Pushing the Limits of Dynamic Quadruped Control," ICRA 2019](https://doi.org/10.1109/ICRA.2019.8793865) <span class="used">— low-cost modular QDD actuators and the MIT-mode driver lineage. · cited on [04](../04-actuators/)</span>
7. [Ben et al., HOMIE, arXiv:2502.13013](https://arxiv.org/abs/2502.13013) <span class="used">— RL legs + exoskeleton arms, pose curriculum, height command; walk and squat with free arms · cited on [18](../18-wbc-vla/), [22](../22-roadmap/)</span>
8. [Black, Galliker, Levine, Real-Time Execution of Action Chunking Flow Policies, arXiv:2506.07339](https://arxiv.org/abs/2506.07339) <span class="used">— real-time chunking · cited on [18](../18-wbc-vla/)</span>
9. [Christoph et al., ORCA hand, 2025](https://arxiv.org/abs/2504.04259) <span class="used">— tendon-driven open-source hand alternative · cited on [19](../19-hands/)</span>
10. [D. Amodei et al., Concrete Problems in AI Safety, arXiv 1606.06565, 2016](https://arxiv.org/abs/1606.06565) <span class="used">— reward hacking as a general failure mode. · cited on [16](../16-rl-walking/)</span>
11. [D. Rempe, M. Petrovich, Y. Yuan et al., Kimodo: Scaling Controllable Human Motion Generation, arXiv 2603.15546, 2026](https://arxiv.org/abs/2603.15546) <span class="used">— Kimodo as kinematic motion diffusion · cited on [17](../17-motion-tracking/)</span>
12. [F. Muratore et al., Robot Learning from Randomized Simulations: A Review, Frontiers in Robotics and AI 2022 (arXiv 2111.00956)](https://arxiv.org/abs/2111.00956) <span class="used">— robustness versus conservatism of randomisation. · cited on [20](../20-sim-to-real/)</span>
13. [G. Cervettini, R. Mauceri, A. Coppola, F. Bergonti, L. Fiorio, M. Maggiali, D. Pucci, "A Framework for Optimal Ankle Design of Humanoid Robots," IEEE-RAS Humanoids 2025 (arXiv 2509.16469)](https://arxiv.org/abs/2509.16469) <span class="used">— RSU and SPU parallel ankles, closed-form inverse kinematics, Jacobian rank loss, RSU judged better overall. · cited on [06](../06-ankle-linkage/)</span>
14. [Gu, Wang, Chen, Humanoid-Gym, arXiv 2404.05695](https://arxiv.org/abs/2404.05695) <span class="used">— sim-to-sim validation in MuJoCo; open humanoid RL framework with sim-to-sim check.; sim-to-sim validation in MuJoCo, humanoid randomisation practice. · cited on [14](../14-simulation/), [16](../16-rl-walking/), [20](../20-sim-to-real/)</span>
15. [H. Wang, W. Zhang, R. Yu et al., PhysHSI: Towards a Real-World Generalizable and Natural Humanoid-Scene Interaction System, arXiv 2510.11072, 2025](https://arxiv.org/abs/2510.11072) <span class="used">— carry/sit skills as cited in roadmap · cited on [22](../22-roadmap/)</span>
16. [He, Luo et al., OmniH2O, arXiv:2406.08858](https://arxiv.org/abs/2406.08858) <span class="used">— whole-body teleoperation tracker · cited on [18](../18-wbc-vla/)</span>
17. [Huang et al., HoST: Learning humanoid standing-up control across diverse postures (2025)](https://arxiv.org/abs/2502.08378) <span class="used">— get-up skill · cited on [22](../22-roadmap/)</span>
18. [Hwangbo et al., Learning agile and dynamic motor skills for legged robots, 2019](https://arxiv.org/abs/1901.08652) <span class="used">— actuator and delay modelling for transfer; learned actuator networks; RL in simulation transferring to a legged robot.; actuator networks, actuator dynamics as a main gap.; measured actuator model used in training · cited on [03](../03-architecture/), [15](../15-pd-control/), [16](../16-rl-walking/), [20](../20-sim-to-real/), [22](../22-roadmap/)</span>
19. [J. Denavit and R. S. Hartenberg, A kinematic notation for lower-pair mechanisms based on matrices, J. Applied Mechanics 1955](https://doi.org/10.1115/1.4011045) <span class="used">— classic joint-parameter convention · cited on [01](../01-dof-kinematics/)</span>
20. [J. Englsberger, C. Ott, A. Albu-Schäffer, Three-dimensional bipedal walking control based on DCM, T-RO 2015](https://doi.org/10.1109/TRO.2015.2405592) <span class="used">— DCM dynamics · cited on [02](../02-balance/)</span>
21. [J. Lee et al., Learning Quadrupedal Locomotion over Challenging Terrain, Science Robotics, 2020 (arXiv 2010.11251)](https://arxiv.org/abs/2010.11251) <span class="used">— privileged teacher-student training. · cited on [16](../16-rl-walking/), [20](../20-sim-to-real/)</span>
22. [J. Pratt, J. Carff, S. Drakunov, A. Goswami, Capture Point: a step toward humanoid push recovery, Humanoids 2006](https://doi.org/10.1109/ICHR.2006.321385) <span class="used">— capture point, flywheel/hip strategy · cited on [02](../02-balance/)</span>
23. [J. Schulman et al., High-Dimensional Continuous Control Using Generalized Advantage Estimation, arXiv 1506.02438, 2015](https://arxiv.org/abs/1506.02438) <span class="used">— GAE, the γ/λ trade-off. · cited on [16](../16-rl-walking/)</span>
24. [J. Schulman et al., Proximal Policy Optimization Algorithms, arXiv 1707.06347, 2017](https://arxiv.org/abs/1707.06347) <span class="used">— clipped surrogate objective, ε = 0.2, loss terms. · cited on [16](../16-rl-walking/)</span>
25. [J. Siekmann et al., Blind Bipedal Stair Traversal via Sim-to-Real Reinforcement Learning, RSS 2021 (arXiv 2105.08328)](https://arxiv.org/abs/2105.08328) <span class="used">— biped stair policy transferred with randomisation. · cited on [20](../20-sim-to-real/)</span>
26. [J. Tobin et al., Domain Randomization for Transferring Deep Neural Networks from Simulation to the Real World, IROS 2017 (arXiv 1703.06907)](https://arxiv.org/abs/1703.06907) <span class="used">— domain randomisation idea.; origin of domain randomisation. · cited on [16](../16-rl-walking/), [20](../20-sim-to-real/)</span>
27. [Kim et al., PyRoki, arXiv:2505.03728 (2025)](https://arxiv.org/abs/2505.03728) <span class="used">— retargeting as cost minimisation, Levenberg-Marquardt in JAX · cited on [17](../17-motion-tracking/)</span>
28. [L. Pinto et al., Asymmetric Actor Critic for Image-Based Robot Learning, arXiv 1710.06542, 2017](https://arxiv.org/abs/1710.06542) <span class="used">— critic with privileged observations. · cited on [16](../16-rl-walking/)</span>
29. [Liao et al., Berkeley Humanoid, 2024 (arXiv 2407.21781)](https://arxiv.org/abs/2407.21781) <span class="used">— policy 50 Hz, PD 25 kHz on the motor driver · cited on [03](../03-architecture/)</span>
30. [Liao et al., BeyondMimic, 2025 (arXiv 2508.08241)](https://arxiv.org/abs/2508.08241) <span class="used">— motion-tracking recipe; armature = I\_rotor N², kp = I w², kd = 2 I zeta w, w = 10 Hz, zeta = 2, action scale 0.25 tau\_max/kp, zero-armature effects; tracking formulation, observations, anchor, kernels, sigma values and weights, penalties, terminations, adaptive sampling · cited on [03](../03-architecture/), [15](../15-pd-control/), [17](../17-motion-tracking/)</span>
31. [Luo et al., SONIC, arXiv:2511.07820](https://arxiv.org/abs/2511.07820) <span class="used">— scale of a general tracker · cited on [18](../18-wbc-vla/)</span>
32. [M. Mittal et al., Symmetry Considerations for Learning Task Symmetric Robot Policies, ICRA 2024 (arXiv 2403.04359)](https://arxiv.org/abs/2403.04359) <span class="used">— mirror data augmentation. · cited on [16](../16-rl-walking/)</span>
33. [M. Vukobratović and B. Borovac, Zero-moment point: thirty five years of its life, IJHR 2004](https://doi.org/10.1142/S0219843604000083) <span class="used">— ZMP definition and balance condition · cited on [02](../02-balance/)</span>
34. [Mahony, Hamel, Pflimlin, Nonlinear complementary filters on SO(3), IEEE TAC 2008](https://ieeexplore.ieee.org/document/4608934) <span class="used">— complementary filtering · cited on [11](../11-sensors-compute/)</span>
35. [N. Rudin et al., Learning to walk in minutes using massively parallel deep RL, CoRL 2021](https://arxiv.org/abs/2109.11978) <span class="used">— RL locomotion with random pushes; thousands of parallel robots on one GPU; policies output position targets to PD at a lower rate; massively parallel PPO, terrain curriculum.; friction, push and noise randomisation in GPU-parallel locomotion training.; GPU-parallel simulation makes sim-first cheap · cited on [02](../02-balance/), [14](../14-simulation/), [15](../15-pd-control/), [16](../16-rl-walking/), [20](../20-sim-to-real/), [22](../22-roadmap/)</span>
36. [NVIDIA, GR00T N1, 2025 (arXiv 2503.14734)](https://arxiv.org/abs/2503.14734) <span class="used">— dual-system VLA design; System 1/2, Eagle-2 10 Hz, H=16, K=4, 63.9 ms L40, data pyramid · cited on [03](../03-architecture/), [18](../18-wbc-vla/)</span>
37. [P. M. Wensing et al., Proprioceptive actuator design in the MIT Cheetah, T-RO 2017](https://doi.org/10.1109/TRO.2016.2640183) <span class="used">— reflected inertia scales with N^2; low gear ratios; torque density and leg inertia · cited on [05](../05-leg-loads-stairs/), [07](../07-mass-proportions/)</span>
38. [R. I. Davis, A. Burns, R. J. Bril, J. J. Lukkien, Controller Area Network (CAN) schedulability analysis: refuted, revisited and revised, Real-Time Systems 35(3), 2007](https://doi.org/10.1007/s11241-007-9012-7) <span class="used">— worst-case frame length formula (g + 8s + 13 + ⌊(g + 8s − 1)/4⌋), response time growth with load. · cited on [10](../10-can-bus/)</span>
39. [R. Riener, M. Rabuffetti, C. Frigo, Stair ascent and descent at different inclinations, Gait &amp; Posture 2002](<https://doi.org/10.1016/S0966-6362(01)00141-4>) <span class="used">— human knee moments on stairs vs level walking · cited on [05](../05-leg-loads-stairs/)</span>
40. [R. Zanella, F. Califano, S. Stramigioli, Physical human-robot interaction: a critical review of safety constraints, arXiv:2601.19462, 2026](https://arxiv.org/abs/2601.19462) <span class="used">— transient limits taken as twice the quasi-static values except for the skull, forehead and face (no factor) · cited on [12](../12-safety/)</span>
41. [Radosavovic et al., Real-World Humanoid Locomotion with RL, 2023](https://arxiv.org/abs/2303.03381) <span class="used">— further reading on learned humanoid controllers; humanoid RL locomotion, history-based policies.; humanoid sim-to-real with a history-conditioned policy. · cited on [03](../03-architecture/), [16](../16-rl-walking/), [20](../20-sim-to-real/)</span>
42. [S. Kajita et al., Biped walking pattern generation by using preview control of ZMP, ICRA 2003](https://doi.org/10.1109/ROBOT.2003.1241826) <span class="used">— cart-table model, preview control · cited on [02](../02-balance/)</span>
43. [S. Kajita et al., The 3D linear inverted pendulum mode, IROS 2001](https://doi.org/10.1109/IROS.2001.973365) <span class="used">— LIPM · cited on [02](../02-balance/)</span>
44. [S. Seok et al., "Design Principles for Energy-Efficient Legged Locomotion and Implementation on the MIT Cheetah Robot," IEEE/ASME T-Mech, 2015](https://doi.org/10.1109/TMECH.2014.2339013) <span class="used">— large-gap motors with a single low-ratio stage.; motor torque scaling with gap radius · cited on [04](../04-actuators/), [07](../07-mass-proportions/)</span>
45. [Sentis &amp; Khatib, Synthesis of Whole-Body Behaviors through Hierarchical Control of Behavioral Primitives, IJHR 2(4) 2005](https://doi.org/10.1142/S0219843605000594) <span class="used">— prioritised whole-body control · cited on [18](../18-wbc-vla/)</span>
46. [Shaw, Agarwal, Pathak, LEAP Hand, RSS 2023](https://arxiv.org/abs/2309.06440) <span class="used">— direct-servo open-source hand alternative · cited on [19](../19-hands/)</span>
47. [T. He et al., ASAP: Aligning Simulation and Real-World Physics for Learning Agile Humanoid Whole-Body Skills, arXiv 2502.01143, 2025](https://arxiv.org/abs/2502.01143) <span class="used">— humanoid delta-action correction from real data. · cited on [20](../20-sim-to-real/)</span>
48. [T. Koolen et al., Capturability-based analysis and control of legged locomotion, Part 1, IJRR 2012](https://doi.org/10.1177/0278364912452673) <span class="used">— N-step capturability · cited on [02](../02-balance/)</span>
49. [Tan et al., Sim-to-Real: Learning Agile Locomotion for Quadruped Robots, 2018](https://arxiv.org/abs/1804.10332) <span class="used">— latency as a sim-to-real factor; actuator identification, latency modelling, randomisation.; actuator identification to close the sim-to-real gap · cited on [03](../03-architecture/), [20](../20-sim-to-real/), [22](../22-roadmap/)</span>
50. [W. Zhao, J. P. Queralta, T. Westerlund, Sim-to-Real Transfer in Deep Reinforcement Learning for Robotics: a Survey, arXiv 2009.13303, 2020](https://arxiv.org/abs/2009.13303) <span class="used">— the reality gap and mitigation families. · cited on [20](../20-sim-to-real/)</span>
51. [X. B. Peng et al., Sim-to-Real Transfer of Robotic Control with Dynamics Randomization, ICRA 2018 (arXiv 1710.06537)](https://arxiv.org/abs/1710.06537) <span class="used">— dynamics randomisation.; dynamics randomisation with a memory policy. · cited on [16](../16-rl-walking/), [20](../20-sim-to-real/)</span>
52. [Y. Chi et al., "Demonstrating Berkeley Humanoid Lite: An Open-source, Accessible, and Customizable 3D-printed Humanoid Robot," RSS 2025 (arXiv 2504.17249)](https://arxiv.org/abs/2504.17249) <span class="used">— cycloidal gearboxes chosen for printed parts; directly driven joints.; an open humanoid whose joints are each driven by their own actuator with no linkages. · cited on [04](../04-actuators/), [06](../06-ankle-linkage/)</span>
53. [Ze et al., TWIST, arXiv:2505.02833](https://arxiv.org/abs/2505.02833) <span class="used">— single whole-body controller, RL+BC · cited on [18](../18-wbc-vla/)</span>
54. [Zhao et al., ACT, arXiv:2304.13705](https://arxiv.org/abs/2304.13705) <span class="used">— action chunking · cited on [18](../18-wbc-vla/)</span>
55. [Zhu et al., Hiking in the Wild (2026)](https://arxiv.org/abs/2601.07718) <span class="used">— depth-image locomotion · cited on [22](../22-roadmap/)</span>
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
