kranthie/marvin-bot/description/urdf/marvin_bot.urdf

<?xml version='1.0' encoding='utf-8'?>
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
<robot name="marvin_bot">
  <link name="pelvis">
    <inertial><origin xyz="-0.0748805 1.36046e-06 0.0318838"/><mass value="6.64042"/>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</inertial>
    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
  </link>
  <link name="left_hip_roll_link">
    <inertial><origin xyz="-0.0064319 -0.018442 0.00142279"/><mass value="1.84062"/>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</inertial>
    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
  </link>
  <link name="left_hip_pitch_link">
    <inertial><origin xyz="-0.000205741 0.0105302 -0.058796"/><mass value="0.42525"/>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</inertial>
    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
  </link>
  <link name="left_thigh_link">
    <inertial><origin xyz="-0.000192525 0.00264786 -0.0853338"/><mass value="3.15606"/>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</inertial>
    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
  </link>
  <link name="left_shin_link">
    <inertial><origin xyz="0.0130723 0.00148225 -0.168535"/><mass value="2.72775"/>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</inertial>
    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
  </link>
  <link name="left_ankle_link">
    <inertial><origin xyz="0 0 0"/><mass value="0.04888"/>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</inertial>
    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
  </link>
  <link name="left_foot_link">
    <inertial><origin xyz="0.00740474 -0.000590465 -0.0435859"/><mass value="0.39163"/>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</inertial>
    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
  </link>
  <link name="torso_link">
    <inertial><origin xyz="-0.0258329 0.000785997 0.221944"/><mass value="8.91888"/>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</inertial>
    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
  </link>
  <link name="neck_link">
    <inertial><origin xyz="-1.11549e-06 -0.00426394 0.016063"/><mass value="0.12495"/>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</inertial>
    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
  </link>
  <link name="head_link">
    <inertial><origin xyz="0.0339416 -0.00132547 0.0916511"/><mass value="0.44837"/>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</inertial>
    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
  </link>
  <link name="left_shoulder_pitch_link">
    <inertial><origin xyz="0.00165018 0.037703 -0.0207198"/><mass value="0.67707"/>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</inertial>
    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
  </link>
  <link name="left_shoulder_roll_link">
    <inertial><origin xyz="0.00390892 -0.000116495 -0.065583"/><mass value="0.7665"/>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</inertial>
    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
  </link>
  <link name="left_upper_arm_link">
    <inertial><origin xyz="-0.00259556 -0.0009845 -0.0979229"/><mass value="0.73331"/>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</inertial>
    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
  </link>
  <link name="left_forearm_link">
    <inertial><origin xyz="-0.00679528 -0.000789061 -0.0808469"/><mass value="0.60312"/>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</inertial>
    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
  </link>
  <link name="left_wrist_link">
    <inertial><origin xyz="9.43313e-07 -0.00588037 -0.0547627"/><mass value="0.11874"/>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</inertial>
    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
  </link>
  <link name="left_palm_link">
    <inertial><origin xyz="-0.00180875 -0.0015828 -0.0818449"/><mass value="0.44391"/>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</inertial>
    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
  </link>
  <link name="right_hip_roll_link">
    <inertial><origin xyz="-0.0064319 0.018442 0.00142279"/><mass value="1.84062"/>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</inertial>
    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
  </link>
  <link name="right_hip_pitch_link">
    <inertial><origin xyz="-0.000205741 -0.0105302 -0.058796"/><mass value="0.42525"/>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</inertial>
    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
  </link>
  <link name="right_thigh_link">
    <inertial><origin xyz="-0.000192525 -0.00264786 -0.0853338"/><mass value="3.15606"/>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</inertial>
    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
  </link>
  <link name="right_shin_link">
    <inertial><origin xyz="0.0130723 -0.00148225 -0.168535"/><mass value="2.72775"/>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</inertial>
    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
  </link>
  <link name="right_ankle_link">
    <inertial><origin xyz="0 0 0"/><mass value="0.04888"/>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</inertial>
    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
  </link>
  <link name="right_foot_link">
    <inertial><origin xyz="0.00740474 0.000590465 -0.0435859"/><mass value="0.39163"/>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</inertial>
    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
  </link>
  <link name="right_shoulder_pitch_link">
    <inertial><origin xyz="0.00165018 -0.037703 -0.0207198"/><mass value="0.67707"/>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</inertial>
    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
  </link>
  <link name="right_shoulder_roll_link">
    <inertial><origin xyz="0.00390892 0.000116495 -0.065583"/><mass value="0.7665"/>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</inertial>
    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
  </link>
  <link name="right_upper_arm_link">
    <inertial><origin xyz="-0.00259556 0.0009845 -0.0979229"/><mass value="0.73331"/>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</inertial>
    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
  </link>
  <link name="right_forearm_link">
    <inertial><origin xyz="-0.00679528 0.000789061 -0.0808469"/><mass value="0.60312"/>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</inertial>
    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
  </link>
  <link name="right_wrist_link">
    <inertial><origin xyz="9.43313e-07 0.00588037 -0.0547627"/><mass value="0.11874"/>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</inertial>
    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
  </link>
  <link name="right_palm_link">
    <inertial><origin xyz="-0.00192237 0.00156631 -0.0812256"/><mass value="0.44391"/>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</inertial>
    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
  </link>
  <joint name="left_hip_roll" type="revolute">
    <parent link="pelvis"/><child link="left_hip_roll_link"/>
    <origin xyz="0 0.1 0"/><axis xyz="1 0 0"/>
    <limit lower="-0.523599" upper="0.785398" effort="120" velocity="20.944"/>
  </joint>
  <joint name="left_hip_pitch" type="revolute">
    <parent link="left_hip_roll_link"/><child link="left_hip_pitch_link"/>
    <origin xyz="0 -0.025 0"/><axis xyz="0 -1 0"/>
    <limit lower="-0.523599" upper="2.0944" effort="120" velocity="20.944"/>
  </joint>
  <joint name="left_hip_yaw" type="revolute">
    <parent link="left_hip_pitch_link"/><child link="left_thigh_link"/>
    <origin xyz="0 0.025 -0.17"/><axis xyz="0 0 -1"/>
    <limit lower="-1.5708" upper="1.5708" effort="60" velocity="20.4204"/>
  </joint>
  <joint name="left_knee" type="revolute">
    <parent link="left_thigh_link"/><child link="left_shin_link"/>
    <origin xyz="0 0 -0.155"/><axis xyz="0 1 0"/>
    <limit lower="0" upper="2.26893" effort="120" velocity="20.944"/>
  </joint>
  <joint name="left_ankle_pitch" type="revolute">
    <parent link="left_shin_link"/><child link="left_ankle_link"/>
    <origin xyz="0 0 -0.315"/><axis xyz="0 -1 0"/>
    <limit lower="-0.698132" upper="0.698132" effort="118.8" velocity="20.6266"/>
  </joint>
  <joint name="left_ankle_roll" type="revolute">
    <parent link="left_ankle_link"/><child link="left_foot_link"/>
    <origin xyz="0 0 0"/><axis xyz="1 0 0"/>
    <limit lower="-0.349066" upper="0.349066" effort="84" velocity="29.1719"/>
  </joint>
  <joint name="waist_yaw" type="revolute">
    <parent link="pelvis"/><child link="torso_link"/>
    <origin xyz="0.025 0 0.115"/><axis xyz="0 0 1"/>
    <limit lower="-2.61799" upper="2.61799" effort="60" velocity="20.4204"/>
  </joint>
  <joint name="neck_yaw" type="revolute">
    <parent link="torso_link"/><child link="neck_link"/>
    <origin xyz="0 0 0.41"/><axis xyz="0 0 1"/>
    <limit lower="-1.0472" upper="1.0472" effort="4.9" velocity="7.85398"/>
  </joint>
  <joint name="neck_pitch" type="revolute">
    <parent link="neck_link"/><child link="head_link"/>
    <origin xyz="0 0 0.035"/><axis xyz="0 1 0"/>
    <limit lower="-0.349066" upper="0.698132" effort="4.9" velocity="7.85398"/>
  </joint>
  <joint name="left_shoulder_pitch" type="revolute">
    <parent link="torso_link"/><child link="left_shoulder_pitch_link"/>
    <origin xyz="0 0.11 0.35"/><axis xyz="0 -1 0"/>
    <limit lower="-1.0472" upper="3.14159" effort="60" velocity="20.4204"/>
  </joint>
  <joint name="left_shoulder_roll" type="revolute">
    <parent link="left_shoulder_pitch_link"/><child link="left_shoulder_roll_link"/>
    <origin xyz="0 0.048 -0.025"/><axis xyz="1 0 0"/>
    <limit lower="-0.349066" upper="2.0944" effort="42" velocity="13.09"/>
  </joint>
  <joint name="left_shoulder_yaw" type="revolute">
    <parent link="left_shoulder_roll_link"/><child link="left_upper_arm_link"/>
    <origin xyz="0 0 -0.085"/><axis xyz="0 0 -1"/>
    <limit lower="-2.61799" upper="2.61799" effort="42" velocity="13.09"/>
  </joint>
  <joint name="left_elbow" type="revolute">
    <parent link="left_upper_arm_link"/><child link="left_forearm_link"/>
    <origin xyz="0 0 -0.115"/><axis xyz="0 -1 0"/>
    <limit lower="0" upper="2.35619" effort="42" velocity="13.09"/>
  </joint>
  <joint name="left_wrist_yaw" type="revolute">
    <parent link="left_forearm_link"/><child link="left_wrist_link"/>
    <origin xyz="0 0 -0.125"/><axis xyz="0 0 -1"/>
    <limit lower="-1.5708" upper="1.5708" effort="14" velocity="32.9867"/>
  </joint>
  <joint name="left_wrist_pitch" type="revolute">
    <parent link="left_wrist_link"/><child link="left_palm_link"/>
    <origin xyz="0 0 -0.063"/><axis xyz="0 -1 0"/>
    <limit lower="-1.0472" upper="1.0472" effort="4.9" velocity="7.85398"/>
  </joint>
  <joint name="right_hip_roll" type="revolute">
    <parent link="pelvis"/><child link="right_hip_roll_link"/>
    <origin xyz="0 -0.1 0"/><axis xyz="-1 0 0"/>
    <limit lower="-0.523599" upper="0.785398" effort="120" velocity="20.944"/>
  </joint>
  <joint name="right_hip_pitch" type="revolute">
    <parent link="right_hip_roll_link"/><child link="right_hip_pitch_link"/>
    <origin xyz="0 0.025 0"/><axis xyz="0 -1 0"/>
    <limit lower="-0.523599" upper="2.0944" effort="120" velocity="20.944"/>
  </joint>
  <joint name="right_hip_yaw" type="revolute">
    <parent link="right_hip_pitch_link"/><child link="right_thigh_link"/>
    <origin xyz="0 -0.025 -0.17"/><axis xyz="0 0 1"/>
    <limit lower="-1.5708" upper="1.5708" effort="60" velocity="20.4204"/>
  </joint>
  <joint name="right_knee" type="revolute">
    <parent link="right_thigh_link"/><child link="right_shin_link"/>
    <origin xyz="0 0 -0.155"/><axis xyz="0 1 0"/>
    <limit lower="0" upper="2.26893" effort="120" velocity="20.944"/>
  </joint>
  <joint name="right_ankle_pitch" type="revolute">
    <parent link="right_shin_link"/><child link="right_ankle_link"/>
    <origin xyz="0 0 -0.315"/><axis xyz="0 -1 0"/>
    <limit lower="-0.698132" upper="0.698132" effort="118.8" velocity="20.6266"/>
  </joint>
  <joint name="right_ankle_roll" type="revolute">
    <parent link="right_ankle_link"/><child link="right_foot_link"/>
    <origin xyz="0 0 0"/><axis xyz="-1 0 0"/>
    <limit lower="-0.349066" upper="0.349066" effort="84" velocity="29.1719"/>
  </joint>
  <joint name="right_shoulder_pitch" type="revolute">
    <parent link="torso_link"/><child link="right_shoulder_pitch_link"/>
    <origin xyz="0 -0.11 0.35"/><axis xyz="0 -1 0"/>
    <limit lower="-1.0472" upper="3.14159" effort="60" velocity="20.4204"/>
  </joint>
  <joint name="right_shoulder_roll" type="revolute">
    <parent link="right_shoulder_pitch_link"/><child link="right_shoulder_roll_link"/>
    <origin xyz="0 -0.048 -0.025"/><axis xyz="-1 0 0"/>
    <limit lower="-0.349066" upper="2.0944" effort="42" velocity="13.09"/>
  </joint>
  <joint name="right_shoulder_yaw" type="revolute">
    <parent link="right_shoulder_roll_link"/><child link="right_upper_arm_link"/>
    <origin xyz="0 0 -0.085"/><axis xyz="0 0 1"/>
    <limit lower="-2.61799" upper="2.61799" effort="42" velocity="13.09"/>
  </joint>
  <joint name="right_elbow" type="revolute">
    <parent link="right_upper_arm_link"/><child link="right_forearm_link"/>
    <origin xyz="0 0 -0.115"/><axis xyz="0 -1 0"/>
    <limit lower="0" upper="2.35619" effort="42" velocity="13.09"/>
  </joint>
  <joint name="right_wrist_yaw" type="revolute">
    <parent link="right_forearm_link"/><child link="right_wrist_link"/>
    <origin xyz="0 0 -0.125"/><axis xyz="0 0 1"/>
    <limit lower="-1.5708" upper="1.5708" effort="14" velocity="32.9867"/>
  </joint>
  <joint name="right_wrist_pitch" type="revolute">
    <parent link="right_wrist_link"/><child link="right_palm_link"/>
    <origin xyz="0 0 -0.063"/><axis xyz="0 -1 0"/>
    <limit lower="-1.0472" upper="1.0472" effort="4.9" velocity="7.85398"/>
  </joint>
</robot>
