kranthie/marvin-bot/description/urdf/marvin_bot_lite.urdf

<?xml version='1.0' encoding='utf-8'?>
<!-- Generated by tools/build_urdf.py from description/*.yaml. Do not edit. -->
<robot name="marvin_bot_lite">
  <link name="lite_base">
    <inertial><origin xyz="-0.00294806 7.22359e-07 0.116589"/><mass value="17.3345"/><inertia ixx="0.486622" ixy="-7.83679e-06" ixz="-0.000716606" iyy="0.405784" iyz="-6.6709e-07" izz="0.517966"/></inertial>
    <visual><geometry><mesh filename="../meshes/floor_plate.stl"/></geometry><material name="al6061"><color rgba="0.72 0.74 0.77 1"/></material></visual>
    <visual><geometry><mesh filename="../meshes/deck_plate.stl"/></geometry><material name="al6061"><color rgba="0.72 0.74 0.77 1"/></material></visual>
    <visual><geometry><mesh filename="../meshes/standoff_0.stl"/></geometry><material name="al6061"><color rgba="0.72 0.74 0.77 1"/></material></visual>
    <visual><geometry><mesh filename="../meshes/standoff_1.stl"/></geometry><material name="al6061"><color rgba="0.72 0.74 0.77 1"/></material></visual>
    <visual><geometry><mesh filename="../meshes/standoff_2.stl"/></geometry><material name="al6061"><color rgba="0.72 0.74 0.77 1"/></material></visual>
    <visual><geometry><mesh filename="../meshes/standoff_3.stl"/></geometry><material name="al6061"><color rgba="0.72 0.74 0.77 1"/></material></visual>
    <visual><geometry><mesh filename="../meshes/standoff_4.stl"/></geometry><material name="al6061"><color rgba="0.72 0.74 0.77 1"/></material></visual>
    <visual><geometry><mesh filename="../meshes/standoff_5.stl"/></geometry><material name="al6061"><color rgba="0.72 0.74 0.77 1"/></material></visual>
    <visual><geometry><mesh filename="../meshes/standoff_6.stl"/></geometry><material name="al6061"><color rgba="0.72 0.74 0.77 1"/></material></visual>
    <visual><geometry><mesh filename="../meshes/standoff_7.stl"/></geometry><material name="al6061"><color rgba="0.72 0.74 0.77 1"/></material></visual>
    <visual><geometry><mesh filename="../meshes/standoff_8.stl"/></geometry><material name="al6061"><color rgba="0.72 0.74 0.77 1"/></material></visual>
    <visual><geometry><mesh filename="../meshes/standoff_9.stl"/></geometry><material name="al6061"><color rgba="0.72 0.74 0.77 1"/></material></visual>
    <visual><geometry><mesh filename="../meshes/standoff_10.stl"/></geometry><material name="al6061"><color rgba="0.72 0.74 0.77 1"/></material></visual>
    <visual><geometry><mesh filename="../meshes/standoff_11.stl"/></geometry><material name="al6061"><color rgba="0.72 0.74 0.77 1"/></material></visual>
    <visual><geometry><mesh filename="../meshes/column_foot.stl"/></geometry><material name="al6061"><color rgba="0.72 0.74 0.77 1"/></material></visual>
    <visual><geometry><mesh filename="../meshes/column_collar.stl"/></geometry><material name="al6061"><color rgba="0.72 0.74 0.77 1"/></material></visual>
    <visual><geometry><mesh filename="../meshes/pod_inner_45.stl"/></geometry><material name="al6061"><color rgba="0.72 0.74 0.77 1"/></material></visual>
    <visual><geometry><mesh filename="../meshes/pod_outer_45.stl"/></geometry><material name="al6061"><color rgba="0.72 0.74 0.77 1"/></material></visual>
    <visual><geometry><mesh filename="../meshes/pod_spacer_0_45.stl"/></geometry><material name="al6061"><color rgba="0.72 0.74 0.77 1"/></material></visual>
    <visual><geometry><mesh filename="../meshes/pod_spacer_1_45.stl"/></geometry><material name="al6061"><color rgba="0.72 0.74 0.77 1"/></material></visual>
    <visual><geometry><mesh filename="../meshes/pod_bearing_45.stl"/></geometry><material name="bought"><color rgba="0.45 0.45 0.47 1"/></material></visual>
    <visual><geometry><mesh filename="../meshes/pod_motor_45.stl"/></geometry><material name="bought"><color rgba="0.45 0.45 0.47 1"/></material></visual>
    <visual><geometry><mesh filename="../meshes/pod_clevis_45.stl"/></geometry><material name="al6061"><color rgba="0.72 0.74 0.77 1"/></material></visual>
    <visual><geometry><mesh filename="../meshes/pod_pivot_pin_45.stl"/></geometry><material name="steel"><color rgba="0.45 0.45 0.47 1"/></material></visual>
    <visual><geometry><mesh filename="../meshes/pod_spring_tab_45.stl"/></geometry><material name="al6061"><color rgba="0.72 0.74 0.77 1"/></material></visual>
    <visual><geometry><mesh filename="../meshes/pod_post_45.stl"/></geometry><material name="steel"><color rgba="0.45 0.45 0.47 1"/></material></visual>
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
    <visual><geometry><mesh filename="../meshes/charge_contact_l.stl"/></geometry><material name="bought"><color rgba="0.45 0.45 0.47 1"/></material></visual>
    <visual><geometry><mesh filename="../meshes/charge_contact_r.stl"/></geometry><material name="bought"><color rgba="0.45 0.45 0.47 1"/></material></visual>
    <visual><geometry><mesh filename="../meshes/desk_column.stl"/></geometry><material name="bought"><color rgba="0.45 0.45 0.47 1"/></material></visual>
    <visual><geometry><mesh filename="../meshes/screws_pod_45.stl"/></geometry><material name="bought"><color rgba="0.45 0.45 0.47 1"/></material></visual>
    <visual><geometry><mesh filename="../meshes/screws_pod_135.stl"/></geometry><material name="bought"><color rgba="0.45 0.45 0.47 1"/></material></visual>
    <visual><geometry><mesh filename="../meshes/screws_pod_225.stl"/></geometry><material name="bought"><color rgba="0.45 0.45 0.47 1"/></material></visual>
    <visual><geometry><mesh filename="../meshes/screws_pod_315.stl"/></geometry><material name="bought"><color rgba="0.45 0.45 0.47 1"/></material></visual>
    <visual><geometry><mesh filename="../meshes/screws_frame.stl"/></geometry><material name="bought"><color rgba="0.45 0.45 0.47 1"/></material></visual>
    <collision><origin xyz="0 0 0.105"/><geometry><box size="0.5 0.5 0.16"/></geometry></collision>
    <collision><origin xyz="0 0 0.4"/><geometry><box size="0.08 0.05 0.43"/></geometry></collision>
  </link>
  <link name="torso_link">
    <inertial><origin xyz="-0.00355161 0.00127022 0.232075"/><mass value="5.51888"/><inertia ixx="0.102978" ixy="-0.00033485" ixz="-0.00435817" iyy="0.0920814" iyz="-9.70297e-05" izz="0.02584"/></inertial>
    <visual><origin xyz="0.01 0 0.1"/><geometry><box size="0.072 0.11 0.11"/></geometry><material name="body"><color rgba="0.19 0.20 0.23 1"/></material></visual>
    <visual><origin xyz="-0.068 0 0.07"/><geometry><box size="0.05 0.08 0.05"/></geometry><material name="body"><color rgba="0.19 0.20 0.23 1"/></material></visual>
    <visual><geometry><mesh filename="../meshes/torso_waist_hub.stl"/></geometry><material name="al7075"><color rgba="0.72 0.74 0.77 1"/></material></visual>
    <visual><geometry><mesh filename="../meshes/torso_waist_flange.stl"/></geometry><material name="al6061"><color rgba="0.72 0.74 0.77 1"/></material></visual>
    <visual><geometry><mesh filename="../meshes/torso_base.stl"/></geometry><material name="al7075"><color rgba="0.72 0.74 0.77 1"/></material></visual>
    <visual><geometry><mesh filename="../meshes/torso_battery_shelf.stl"/></geometry><material name="al7075"><color rgba="0.72 0.74 0.77 1"/></material></visual>
    <visual><geometry><mesh filename="../meshes/torso_upright_l.stl"/></geometry><material name="al7075"><color rgba="0.72 0.74 0.77 1"/></material></visual>
    <visual><geometry><mesh filename="../meshes/torso_foot_l.stl"/></geometry><material name="al6061"><color rgba="0.72 0.74 0.77 1"/></material></visual>
    <visual><geometry><mesh filename="../meshes/torso_strut_l0.stl"/></geometry><material name="al6061"><color rgba="0.72 0.74 0.77 1"/></material></visual>
    <visual><geometry><mesh filename="../meshes/torso_strut_l1.stl"/></geometry><material name="al6061"><color rgba="0.72 0.74 0.77 1"/></material></visual>
    <visual><geometry><mesh filename="../meshes/torso_shoulder_ring_l.stl"/></geometry><material name="al7075"><color rgba="0.72 0.74 0.77 1"/></material></visual>
    <visual><geometry><mesh filename="../meshes/torso_shoulder_cage_l.stl"/></geometry><material name="al7075"><color rgba="0.72 0.74 0.77 1"/></material></visual>
    <visual><geometry><mesh filename="../meshes/torso_shoulder_plate_l.stl"/></geometry><material name="al7075"><color rgba="0.72 0.74 0.77 1"/></material></visual>
    <visual><geometry><mesh filename="../meshes/torso_spacer_l0.stl"/></geometry><material name="al7075"><color rgba="0.72 0.74 0.77 1"/></material></visual>
    <visual><geometry><mesh filename="../meshes/torso_spacer_l1.stl"/></geometry><material name="al7075"><color rgba="0.72 0.74 0.77 1"/></material></visual>
    <visual><geometry><mesh filename="../meshes/torso_upright_r.stl"/></geometry><material name="al7075"><color rgba="0.72 0.74 0.77 1"/></material></visual>
    <visual><geometry><mesh filename="../meshes/torso_foot_r.stl"/></geometry><material name="al6061"><color rgba="0.72 0.74 0.77 1"/></material></visual>
    <visual><geometry><mesh filename="../meshes/torso_strut_r0.stl"/></geometry><material name="al6061"><color rgba="0.72 0.74 0.77 1"/></material></visual>
    <visual><geometry><mesh filename="../meshes/torso_strut_r1.stl"/></geometry><material name="al6061"><color rgba="0.72 0.74 0.77 1"/></material></visual>
    <visual><geometry><mesh filename="../meshes/torso_shoulder_ring_r.stl"/></geometry><material name="al7075"><color rgba="0.72 0.74 0.77 1"/></material></visual>
    <visual><geometry><mesh filename="../meshes/torso_shoulder_cage_r.stl"/></geometry><material name="al7075"><color rgba="0.72 0.74 0.77 1"/></material></visual>
    <visual><geometry><mesh filename="../meshes/torso_shoulder_plate_r.stl"/></geometry><material name="al7075"><color rgba="0.72 0.74 0.77 1"/></material></visual>
    <visual><geometry><mesh filename="../meshes/torso_spacer_r0.stl"/></geometry><material name="al7075"><color rgba="0.72 0.74 0.77 1"/></material></visual>
    <visual><geometry><mesh filename="../meshes/torso_spacer_r1.stl"/></geometry><material name="al7075"><color rgba="0.72 0.74 0.77 1"/></material></visual>
    <visual><geometry><mesh filename="../meshes/torso_bridge.stl"/></geometry><material name="al7075"><color rgba="0.72 0.74 0.77 1"/></material></visual>
    <visual><geometry><mesh filename="../meshes/torso_bridge_clip.stl"/></geometry><material name="tpu"><color rgba="0.17 0.18 0.20 1"/></material></visual>
    <visual><geometry><mesh filename="../meshes/torso_compute_plate.stl"/></geometry><material name="al7075"><color rgba="0.72 0.74 0.77 1"/></material></visual>
    <visual><geometry><mesh filename="../meshes/elec_contactor.stl"/></geometry><material name="bought"><color rgba="0.45 0.45 0.47 1"/></material></visual>
    <visual><geometry><mesh filename="../meshes/elec_precharge.stl"/></geometry><material name="bought"><color rgba="0.45 0.45 0.47 1"/></material></visual>
    <visual><geometry><mesh filename="../meshes/elec_power_board_torso.stl"/></geometry><material name="bought"><color rgba="0.45 0.45 0.47 1"/></material></visual>
    <visual><geometry><mesh filename="../meshes/elec_estop_relay.stl"/></geometry><material name="bought"><color rgba="0.45 0.45 0.47 1"/></material></visual>
    <visual><geometry><mesh filename="../meshes/elec_can_usb_1.stl"/></geometry><material name="bought"><color rgba="0.45 0.45 0.47 1"/></material></visual>
    <visual><geometry><mesh filename="../meshes/elec_can_usb_2.stl"/></geometry><material name="bought"><color rgba="0.45 0.45 0.47 1"/></material></visual>
    <visual><geometry><mesh filename="../meshes/elec_can_usb_3.stl"/></geometry><material name="bought"><color rgba="0.45 0.45 0.47 1"/></material></visual>
    <visual><geometry><mesh filename="../meshes/elec_dcdc_compute.stl"/></geometry><material name="bought"><color rgba="0.45 0.45 0.47 1"/></material></visual>
    <visual><geometry><mesh filename="../meshes/elec_battery_socket.stl"/></geometry><material name="bought"><color rgba="0.45 0.45 0.47 1"/></material></visual>
    <visual><geometry><mesh filename="../meshes/elec_harness_torso.stl"/></geometry><material name="bought"><color rgba="0.45 0.45 0.47 1"/></material></visual>
    <visual><geometry><mesh filename="../meshes/elec_bulkhead_arm_l.stl"/></geometry><material name="bought"><color rgba="0.45 0.45 0.47 1"/></material></visual>
    <visual><geometry><mesh filename="../meshes/elec_bulkhead_arm_r.stl"/></geometry><material name="bought"><color rgba="0.45 0.45 0.47 1"/></material></visual>
    <visual><geometry><mesh filename="../meshes/torso_battery_guides.stl"/></geometry><material name="pa_cf"><color rgba="0.17 0.18 0.20 1"/></material></visual>
    <visual><geometry><mesh filename="../meshes/torso_battery_latch.stl"/></geometry><material name="pa_cf"><color rgba="0.17 0.18 0.20 1"/></material></visual>
    <visual><origin xyz="0 0.08225 0.35" rpy="1.5708 0 0"/><geometry><cylinder radius="0.05" length="0.0441"/></geometry><material name="RS03"><color rgba="0.23 0.49 0.85 1"/></material></visual>
    <visual><origin xyz="0 0.05395 0.35" rpy="1.5708 0 0"/><geometry><cylinder radius="0.039" length="0.0125"/></geometry><material name="RS03"><color rgba="0.23 0.49 0.85 1"/></material></visual>
    <visual><origin xyz="0 -0.08225 0.35" rpy="1.5708 0 0"/><geometry><cylinder radius="0.05" length="0.0441"/></geometry><material name="RS03"><color rgba="0.23 0.49 0.85 1"/></material></visual>
    <visual><origin xyz="0 -0.05395 0.35" rpy="1.5708 0 0"/><geometry><cylinder radius="0.039" length="0.0125"/></geometry><material name="RS03"><color rgba="0.23 0.49 0.85 1"/></material></visual>
    <visual><origin xyz="0.0115 0 0.3529" rpy="0 0 0"/><geometry><box size="0.0453 0.0248 0.0358"/></geometry><material name="STS3250"><color rgba="0.88 0.66 0.0 1"/></material></visual>
    <collision><origin xyz="-0.02 0 0.135"/><geometry><box size="0.16 0.2 0.25"/></geometry></collision>
  </link>
  <link name="neck_link">
    <inertial><origin xyz="-1.11549e-06 -0.00426394 0.016063"/><mass value="0.12495"/><inertia ixx="0.000108357" ixy="-2.0618e-09" ixz="-6.13454e-09" iyy="0.000110279" iyz="-1.32978e-05" izz="3.26202e-05"/></inertial>
    <visual><geometry><mesh filename="../meshes/neck_hub.stl"/></geometry><material name="al7075"><color rgba="0.72 0.74 0.77 1"/></material></visual>
    <visual><geometry><mesh filename="../meshes/neck_bracket.stl"/></geometry><material name="al7075"><color rgba="0.72 0.74 0.77 1"/></material></visual>
    <visual><geometry><mesh filename="../meshes/neck_cheek_l.stl"/></geometry><material name="al7075"><color rgba="0.72 0.74 0.77 1"/></material></visual>
    <visual><geometry><mesh filename="../meshes/neck_cheek_r.stl"/></geometry><material name="al7075"><color rgba="0.72 0.74 0.77 1"/></material></visual>
    <visual><origin xyz="0 -0.0121 0.0235" rpy="0 0 0"/><geometry><box size="0.0248 0.0358 0.0453"/></geometry><material name="STS3250"><color rgba="0.88 0.66 0.0 1"/></material></visual>
  </link>
  <link name="head_link">
    <inertial><origin xyz="0.0339416 -0.00132547 0.0916511"/><mass value="0.44837"/><inertia ixx="0.00138602" ixy="-1.99168e-05" ixz="6.03695e-05" iyy="0.00238647" iyz="-1.48245e-05" izz="0.0027742"/></inertial>
    <visual><geometry><mesh filename="../meshes/head_frame_side_horn.stl"/></geometry><material name="al7075"><color rgba="0.72 0.74 0.77 1"/></material></visual>
    <visual><geometry><mesh filename="../meshes/head_frame_side_idler.stl"/></geometry><material name="al7075"><color rgba="0.72 0.74 0.77 1"/></material></visual>
    <visual><geometry><mesh filename="../meshes/head_frame_bridge.stl"/></geometry><material name="al7075"><color rgba="0.72 0.74 0.77 1"/></material></visual>
    <visual><geometry><mesh filename="../meshes/head_frame.stl"/></geometry><material name="al7075"><color rgba="0.72 0.74 0.77 1"/></material></visual>
    <visual><geometry><mesh filename="../meshes/head_frame_top.stl"/></geometry><material name="al7075"><color rgba="0.72 0.74 0.77 1"/></material></visual>
    <visual><geometry><mesh filename="../meshes/head_visor.stl"/></geometry><material name="petg"><color rgba="0.17 0.18 0.20 1"/></material></visual>
    <visual><geometry><mesh filename="../meshes/head_shell_crown.stl"/></geometry><material name="petg"><color rgba="0.17 0.18 0.20 1"/></material></visual>
    <visual><geometry><mesh filename="../meshes/head_shell_chin.stl"/></geometry><material name="petg"><color rgba="0.17 0.18 0.20 1"/></material></visual>
    <visual><geometry><mesh filename="../meshes/head_shell_rear.stl"/></geometry><material name="petg"><color rgba="0.17 0.18 0.20 1"/></material></visual>
    <visual><geometry><mesh filename="../meshes/head_shell_cheek_l.stl"/></geometry><material name="petg"><color rgba="0.17 0.18 0.20 1"/></material></visual>
    <visual><geometry><mesh filename="../meshes/head_shell_cheek_r.stl"/></geometry><material name="petg"><color rgba="0.17 0.18 0.20 1"/></material></visual>
    <visual><geometry><mesh filename="../meshes/head_camera_frame.stl"/></geometry><material name="petg"><color rgba="0.17 0.18 0.20 1"/></material></visual>
    <visual><geometry><mesh filename="../meshes/head_camera.stl"/></geometry><material name="bought"><color rgba="0.45 0.45 0.47 1"/></material></visual>
    <collision><origin xyz="0.004 0 0.099"/><geometry><box size="0.16 0.142 0.158"/></geometry></collision>
  </link>
  <link name="left_shoulder_pitch_link">
    <inertial><origin xyz="0.00165018 0.037703 -0.0207198"/><mass value="0.67707"/><inertia ixx="0.000628004" ixy="2.46695e-06" ixz="6.97985e-06" iyy="0.000529114" iyz="0.000111369" izz="0.000664778"/></inertial>
    <visual><geometry><mesh filename="../meshes/left_shoulder_hub.stl"/></geometry><material name="al7075"><color rgba="0.72 0.74 0.77 1"/></material></visual>
    <visual><geometry><mesh filename="../meshes/left_shoulder_flange.stl"/></geometry><material name="al7075"><color rgba="0.72 0.74 0.77 1"/></material></visual>
    <visual><geometry><mesh filename="../meshes/left_shoulder_roll_ring.stl"/></geometry><material name="al7075"><color rgba="0.72 0.74 0.77 1"/></material></visual>
    <visual><geometry><mesh filename="../meshes/left_shoulder_roll_idler_stub.stl"/></geometry><material name="al7075"><color rgba="0.72 0.74 0.77 1"/></material></visual>
    <visual><origin xyz="0 0.048 -0.025" rpy="0 1.5708 0"/><geometry><cylinder radius="0.0285" length="0.0606"/></geometry><material name="RS10P"><color rgba="0.18 0.66 0.70 1"/></material></visual>
  </link>
  <link name="left_shoulder_roll_link">
    <inertial><origin xyz="0.00390892 -0.000116495 -0.065583"/><mass value="0.7665"/><inertia ixx="0.00129027" ixy="3.13497e-06" ixz="-2.98699e-05" iyy="0.0014479" iyz="2.79074e-06" izz="0.000747046"/></inertial>
    <visual><geometry><mesh filename="../meshes/left_shoulder_roll_hub.stl"/></geometry><material name="al7075"><color rgba="0.72 0.74 0.77 1"/></material></visual>
    <visual><geometry><mesh filename="../meshes/left_shoulder_roll_front.stl"/></geometry><material name="al7075"><color rgba="0.72 0.74 0.77 1"/></material></visual>
    <visual><geometry><mesh filename="../meshes/left_shoulder_roll_front_clip.stl"/></geometry><material name="tpu"><color rgba="0.17 0.18 0.20 1"/></material></visual>
    <visual><geometry><mesh filename="../meshes/left_shoulder_roll_top.stl"/></geometry><material name="al7075"><color rgba="0.72 0.74 0.77 1"/></material></visual>
    <visual><geometry><mesh filename="../meshes/left_shoulder_roll_idler.stl"/></geometry><material name="bought"><color rgba="0.45 0.45 0.47 1"/></material></visual>
    <visual><geometry><mesh filename="../meshes/left_shoulder_roll_yoke.stl"/></geometry><material name="al7075"><color rgba="0.72 0.74 0.77 1"/></material></visual>
    <visual><geometry><mesh filename="../meshes/left_shoulder_yaw_ring.stl"/></geometry><material name="al7075"><color rgba="0.72 0.74 0.77 1"/></material></visual>
    <visual><origin xyz="0 0 -0.08" rpy="0 0 0"/><geometry><cylinder radius="0.0285" length="0.0606"/></geometry><material name="RS10P"><color rgba="0.18 0.66 0.70 1"/></material></visual>
  </link>
  <link name="left_upper_arm_link">
    <inertial><origin xyz="-0.00259556 -0.0009845 -0.0979229"/><mass value="0.73331"/><inertia ixx="0.00122068" ixy="4.43318e-06" ixz="7.18369e-05" iyy="0.00116744" iyz="-5.59564e-05" izz="0.000541878"/></inertial>
    <visual><geometry><mesh filename="../meshes/left_upper_arm_hub.stl"/></geometry><material name="al7075"><color rgba="0.72 0.74 0.77 1"/></material></visual>
    <visual><geometry><mesh filename="../meshes/left_upper_arm_ring.stl"/></geometry><material name="al7075"><color rgba="0.72 0.74 0.77 1"/></material></visual>
    <visual><geometry><mesh filename="../meshes/left_upper_arm_strap.stl"/></geometry><material name="al7075"><color rgba="0.72 0.74 0.77 1"/></material></visual>
    <visual><geometry><mesh filename="../meshes/left_elbow_idler_stub.stl"/></geometry><material name="al7075"><color rgba="0.72 0.74 0.77 1"/></material></visual>
    <visual><origin xyz="0 -0.005 -0.115" rpy="1.5708 0 0"/><geometry><cylinder radius="0.0285" length="0.0606"/></geometry><material name="RS10P"><color rgba="0.18 0.66 0.70 1"/></material></visual>
    <collision><origin xyz="0 0 -0.06"/><geometry><box size="0.08 0.08 0.14"/></geometry></collision>
  </link>
  <link name="left_forearm_link">
    <inertial><origin xyz="-0.00424567 -0.000860389 -0.0872511"/><mass value="0.55312"/><inertia ixx="0.00173463" ixy="-1.65669e-05" ixz="7.45645e-05" iyy="0.00158852" iyz="5.43628e-05" izz="0.00044875"/></inertial>
    <visual><geometry><mesh filename="../meshes/left_forearm_hub.stl"/></geometry><material name="al7075"><color rgba="0.72 0.74 0.77 1"/></material></visual>
    <visual><geometry><mesh filename="../meshes/left_forearm_frame.stl"/></geometry><material name="al7075"><color rgba="0.72 0.74 0.77 1"/></material></visual>
    <visual><geometry><mesh filename="../meshes/left_wrist_bracket.stl"/></geometry><material name="al7075"><color rgba="0.72 0.74 0.77 1"/></material></visual>
    <visual><geometry><mesh filename="../meshes/left_elbow_idler.stl"/></geometry><material name="bought"><color rgba="0.45 0.45 0.47 1"/></material></visual>
    <visual><geometry><mesh filename="../meshes/left_forearm_yoke.stl"/></geometry><material name="al7075"><color rgba="0.72 0.74 0.77 1"/></material></visual>
    <visual><origin xyz="0 0 -0.125" rpy="0 0 0"/><geometry><cylinder radius="0.0285" length="0.0514"/></geometry><material name="RS00"><color rgba="0.56 0.36 0.82 1"/></material></visual>
    <collision><origin xyz="0 0 -0.08"/><geometry><box size="0.07 0.07 0.17"/></geometry></collision>
  </link>
  <link name="left_wrist_link">
    <inertial><origin xyz="9.43313e-07 -0.00588037 -0.0547627"/><mass value="0.11874"/><inertia ixx="5.4791e-05" ixy="2.86963e-09" ixz="-1.915e-09" iyy="4.74876e-05" iyz="2.62703e-06" izz="3.88619e-05"/></inertial>
    <visual><geometry><mesh filename="../meshes/left_wrist_cradle.stl"/></geometry><material name="al7075"><color rgba="0.72 0.74 0.77 1"/></material></visual>
    <visual><geometry><mesh filename="../meshes/left_wrist_cradle_side_l.stl"/></geometry><material name="al7075"><color rgba="0.72 0.74 0.77 1"/></material></visual>
    <visual><geometry><mesh filename="../meshes/left_wrist_cradle_side_r.stl"/></geometry><material name="al7075"><color rgba="0.72 0.74 0.77 1"/></material></visual>
    <visual><geometry><mesh filename="../meshes/left_wrist_cradle_back.stl"/></geometry><material name="al7075"><color rgba="0.72 0.74 0.77 1"/></material></visual>
    <visual><geometry><mesh filename="../meshes/left_wrist_idler_pin.stl"/></geometry><material name="bought"><color rgba="0.45 0.45 0.47 1"/></material></visual>
    <visual><origin xyz="0 -0.0121 -0.0515" rpy="0 0 0"/><geometry><box size="0.0248 0.0358 0.0453"/></geometry><material name="STS3250"><color rgba="0.88 0.66 0.0 1"/></material></visual>
    <collision><origin xyz="0 -0.012 -0.052"/><geometry><box size="0.035 0.05 0.05"/></geometry></collision>
  </link>
  <link name="left_palm_link">
    <inertial><origin xyz="-0.00180875 -0.0015828 -0.0818449"/><mass value="0.44391"/><inertia ixx="0.00129828" ixy="-7.64507e-05" ixz="7.20087e-05" iyy="0.00125449" iyz="-3.38599e-05" izz="0.000651149"/></inertial>
    <visual><geometry><mesh filename="../meshes/left_hand_arm_horn.stl"/></geometry><material name="al7075"><color rgba="0.72 0.74 0.77 1"/></material></visual>
    <visual><geometry><mesh filename="../meshes/left_hand_arm_idler.stl"/></geometry><material name="al7075"><color rgba="0.72 0.74 0.77 1"/></material></visual>
    <visual><geometry><mesh filename="../meshes/left_hand_mount.stl"/></geometry><material name="al7075"><color rgba="0.72 0.74 0.77 1"/></material></visual>
    <visual><geometry><mesh filename="../meshes/left_hand.stl"/></geometry><material name="bought"><color rgba="0.45 0.45 0.47 1"/></material></visual>
    <collision><origin xyz="0.005 0 -0.101"/><geometry><box size="0.05 0.11 0.16"/></geometry></collision>
  </link>
  <link name="right_shoulder_pitch_link">
    <inertial><origin xyz="0.00165018 -0.037703 -0.0207198"/><mass value="0.67707"/><inertia ixx="0.000628004" ixy="-2.46695e-06" ixz="6.97985e-06" iyy="0.000529114" iyz="-0.000111369" izz="0.000664778"/></inertial>
    <visual><geometry><mesh filename="../meshes/right_shoulder_hub.stl"/></geometry><material name="al7075"><color rgba="0.72 0.74 0.77 1"/></material></visual>
    <visual><geometry><mesh filename="../meshes/right_shoulder_flange.stl"/></geometry><material name="al7075"><color rgba="0.72 0.74 0.77 1"/></material></visual>
    <visual><geometry><mesh filename="../meshes/right_shoulder_roll_ring.stl"/></geometry><material name="al7075"><color rgba="0.72 0.74 0.77 1"/></material></visual>
    <visual><geometry><mesh filename="../meshes/right_shoulder_roll_idler_stub.stl"/></geometry><material name="al7075"><color rgba="0.72 0.74 0.77 1"/></material></visual>
    <visual><origin xyz="0 -0.048 -0.025" rpy="0 1.5708 0"/><geometry><cylinder radius="0.0285" length="0.0606"/></geometry><material name="RS10P"><color rgba="0.18 0.66 0.70 1"/></material></visual>
  </link>
  <link name="right_shoulder_roll_link">
    <inertial><origin xyz="0.00390892 0.000116495 -0.065583"/><mass value="0.7665"/><inertia ixx="0.00129027" ixy="-3.13497e-06" ixz="-2.98699e-05" iyy="0.0014479" iyz="-2.79074e-06" izz="0.000747046"/></inertial>
    <visual><geometry><mesh filename="../meshes/right_shoulder_roll_hub.stl"/></geometry><material name="al7075"><color rgba="0.72 0.74 0.77 1"/></material></visual>
    <visual><geometry><mesh filename="../meshes/right_shoulder_roll_front.stl"/></geometry><material name="al7075"><color rgba="0.72 0.74 0.77 1"/></material></visual>
    <visual><geometry><mesh filename="../meshes/right_shoulder_roll_front_clip.stl"/></geometry><material name="tpu"><color rgba="0.17 0.18 0.20 1"/></material></visual>
    <visual><geometry><mesh filename="../meshes/right_shoulder_roll_top.stl"/></geometry><material name="al7075"><color rgba="0.72 0.74 0.77 1"/></material></visual>
    <visual><geometry><mesh filename="../meshes/right_shoulder_roll_idler.stl"/></geometry><material name="bought"><color rgba="0.45 0.45 0.47 1"/></material></visual>
    <visual><geometry><mesh filename="../meshes/right_shoulder_roll_yoke.stl"/></geometry><material name="al7075"><color rgba="0.72 0.74 0.77 1"/></material></visual>
    <visual><geometry><mesh filename="../meshes/right_shoulder_yaw_ring.stl"/></geometry><material name="al7075"><color rgba="0.72 0.74 0.77 1"/></material></visual>
    <visual><origin xyz="0 0 -0.08" rpy="0 0 0"/><geometry><cylinder radius="0.0285" length="0.0606"/></geometry><material name="RS10P"><color rgba="0.18 0.66 0.70 1"/></material></visual>
  </link>
  <link name="right_upper_arm_link">
    <inertial><origin xyz="-0.00259556 0.0009845 -0.0979229"/><mass value="0.73331"/><inertia ixx="0.00122068" ixy="-4.43318e-06" ixz="7.18369e-05" iyy="0.00116744" iyz="5.59564e-05" izz="0.000541878"/></inertial>
    <visual><geometry><mesh filename="../meshes/right_upper_arm_hub.stl"/></geometry><material name="al7075"><color rgba="0.72 0.74 0.77 1"/></material></visual>
    <visual><geometry><mesh filename="../meshes/right_upper_arm_ring.stl"/></geometry><material name="al7075"><color rgba="0.72 0.74 0.77 1"/></material></visual>
    <visual><geometry><mesh filename="../meshes/right_upper_arm_strap.stl"/></geometry><material name="al7075"><color rgba="0.72 0.74 0.77 1"/></material></visual>
    <visual><geometry><mesh filename="../meshes/right_elbow_idler_stub.stl"/></geometry><material name="al7075"><color rgba="0.72 0.74 0.77 1"/></material></visual>
    <visual><origin xyz="0 0.005 -0.115" rpy="1.5708 0 0"/><geometry><cylinder radius="0.0285" length="0.0606"/></geometry><material name="RS10P"><color rgba="0.18 0.66 0.70 1"/></material></visual>
    <collision><origin xyz="0 0 -0.06"/><geometry><box size="0.08 0.08 0.14"/></geometry></collision>
  </link>
  <link name="right_forearm_link">
    <inertial><origin xyz="-0.00424567 0.000860389 -0.0872511"/><mass value="0.55312"/><inertia ixx="0.00173463" ixy="1.65669e-05" ixz="7.45645e-05" iyy="0.00158852" iyz="-5.43628e-05" izz="0.00044875"/></inertial>
    <visual><geometry><mesh filename="../meshes/right_forearm_hub.stl"/></geometry><material name="al7075"><color rgba="0.72 0.74 0.77 1"/></material></visual>
    <visual><geometry><mesh filename="../meshes/right_forearm_frame.stl"/></geometry><material name="al7075"><color rgba="0.72 0.74 0.77 1"/></material></visual>
    <visual><geometry><mesh filename="../meshes/right_wrist_bracket.stl"/></geometry><material name="al7075"><color rgba="0.72 0.74 0.77 1"/></material></visual>
    <visual><geometry><mesh filename="../meshes/right_elbow_idler.stl"/></geometry><material name="bought"><color rgba="0.45 0.45 0.47 1"/></material></visual>
    <visual><geometry><mesh filename="../meshes/right_forearm_yoke.stl"/></geometry><material name="al7075"><color rgba="0.72 0.74 0.77 1"/></material></visual>
    <visual><origin xyz="0 0 -0.125" rpy="0 0 0"/><geometry><cylinder radius="0.0285" length="0.0514"/></geometry><material name="RS00"><color rgba="0.56 0.36 0.82 1"/></material></visual>
    <collision><origin xyz="0 0 -0.08"/><geometry><box size="0.07 0.07 0.17"/></geometry></collision>
  </link>
  <link name="right_wrist_link">
    <inertial><origin xyz="9.43313e-07 0.00588037 -0.0547627"/><mass value="0.11874"/><inertia ixx="5.4791e-05" ixy="-2.86963e-09" ixz="-1.915e-09" iyy="4.74876e-05" iyz="-2.62703e-06" izz="3.88619e-05"/></inertial>
    <visual><geometry><mesh filename="../meshes/right_wrist_cradle.stl"/></geometry><material name="al7075"><color rgba="0.72 0.74 0.77 1"/></material></visual>
    <visual><geometry><mesh filename="../meshes/right_wrist_cradle_side_l.stl"/></geometry><material name="al7075"><color rgba="0.72 0.74 0.77 1"/></material></visual>
    <visual><geometry><mesh filename="../meshes/right_wrist_cradle_side_r.stl"/></geometry><material name="al7075"><color rgba="0.72 0.74 0.77 1"/></material></visual>
    <visual><geometry><mesh filename="../meshes/right_wrist_cradle_back.stl"/></geometry><material name="al7075"><color rgba="0.72 0.74 0.77 1"/></material></visual>
    <visual><geometry><mesh filename="../meshes/right_wrist_idler_pin.stl"/></geometry><material name="bought"><color rgba="0.45 0.45 0.47 1"/></material></visual>
    <visual><origin xyz="0 0.0121 -0.0515" rpy="0 0 0"/><geometry><box size="0.0248 0.0358 0.0453"/></geometry><material name="STS3250"><color rgba="0.88 0.66 0.0 1"/></material></visual>
    <collision><origin xyz="0 0.012 -0.052"/><geometry><box size="0.035 0.05 0.05"/></geometry></collision>
  </link>
  <link name="right_palm_link">
    <inertial><origin xyz="-0.00192237 0.00156631 -0.0812256"/><mass value="0.44391"/><inertia ixx="0.00128883" ixy="7.36804e-05" ixz="7.00195e-05" iyy="0.00124165" iyz="3.73972e-05" izz="0.000645961"/></inertial>
    <visual><geometry><mesh filename="../meshes/right_hand_arm_horn.stl"/></geometry><material name="al7075"><color rgba="0.72 0.74 0.77 1"/></material></visual>
    <visual><geometry><mesh filename="../meshes/right_hand_arm_idler.stl"/></geometry><material name="al7075"><color rgba="0.72 0.74 0.77 1"/></material></visual>
    <visual><geometry><mesh filename="../meshes/right_hand_mount.stl"/></geometry><material name="al7075"><color rgba="0.72 0.74 0.77 1"/></material></visual>
    <visual><geometry><mesh filename="../meshes/right_hand.stl"/></geometry><material name="bought"><color rgba="0.45 0.45 0.47 1"/></material></visual>
    <collision><origin xyz="0.005 0 -0.101"/><geometry><box size="0.05 0.11 0.16"/></geometry></collision>
  </link>
  <link name="column_link">
    <inertial><origin xyz="-0.0192905 -2.79424e-07 -0.131737"/><mass value="6.92239"/><inertia ixx="0.20838" ixy="-1.72039e-06" ixz="0.014998" iyy="0.216667" iyz="4.21448e-07" izz="0.0192518"/></inertial>
    <visual><geometry><mesh filename="../meshes/column_head_plate.stl"/></geometry><material name="al7075"><color rgba="0.72 0.74 0.77 1"/></material></visual>
    <visual><geometry><mesh filename="../meshes/column_head_cheek_l.stl"/></geometry><material name="al6061"><color rgba="0.72 0.74 0.77 1"/></material></visual>
    <visual><geometry><mesh filename="../meshes/column_head_cheek_r.stl"/></geometry><material name="al6061"><color rgba="0.72 0.74 0.77 1"/></material></visual>
    <visual><geometry><mesh filename="../meshes/column_head_waist_ring.stl"/></geometry><material name="al7075"><color rgba="0.72 0.74 0.77 1"/></material></visual>
    <visual><geometry><mesh filename="../meshes/column_head_waist_cage.stl"/></geometry><material name="al7075"><color rgba="0.72 0.74 0.77 1"/></material></visual>
    <visual><geometry><mesh filename="../meshes/column_head_waist_bearing.stl"/></geometry><material name="bought"><color rgba="0.45 0.45 0.47 1"/></material></visual>
    <visual><geometry><mesh filename="../meshes/column_head_shroud.stl"/></geometry><material name="petg"><color rgba="0.17 0.18 0.20 1"/></material></visual>
    <visual><geometry><mesh filename="../meshes/desk_column_inner.stl"/></geometry><material name="bought"><color rgba="0.45 0.45 0.47 1"/></material></visual>
    <visual><origin xyz="0 0 0.04155" rpy="0 0 0"/><geometry><cylinder radius="0.05" length="0.0441"/></geometry><material name="RS03"><color rgba="0.23 0.49 0.85 1"/></material></visual>
    <visual><origin xyz="0 0 0.01325" rpy="0 0 0"/><geometry><cylinder radius="0.039" length="0.0125"/></geometry><material name="RS03"><color rgba="0.23 0.49 0.85 1"/></material></visual>
    <collision><origin xyz="0 0 0.03"/><geometry><box size="0.15 0.15 0.08"/></geometry></collision>
  </link>
  <link name="wheel_front_left_link">
    <inertial><origin xyz="-0.00210986 0 0"/><mass value="0.7557"/><inertia ixx="0.00217797" ixy="0" ixz="0" iyy="0.00117171" iyz="0" izz="0.00117171"/></inertial>
    <visual><geometry><mesh filename="../meshes/pod_hub_45.stl"/></geometry><material name="al7075"><color rgba="0.72 0.74 0.77 1"/></material></visual>
    <visual><geometry><mesh filename="../meshes/pod_axle_45.stl"/></geometry><material name="steel"><color rgba="0.45 0.45 0.47 1"/></material></visual>
    <visual><geometry><mesh filename="../meshes/pod_wheel_45.stl"/></geometry><material name="bought"><color rgba="0.45 0.45 0.47 1"/></material></visual>
  </link>
  <link name="wheel_rear_left_link">
    <inertial><origin xyz="-0.00210986 0 0"/><mass value="0.7557"/><inertia ixx="0.00217797" ixy="0" ixz="0" iyy="0.00117171" iyz="0" izz="0.00117171"/></inertial>
    <visual><geometry><mesh filename="../meshes/pod_hub_135.stl"/></geometry><material name="al7075"><color rgba="0.72 0.74 0.77 1"/></material></visual>
    <visual><geometry><mesh filename="../meshes/pod_axle_135.stl"/></geometry><material name="steel"><color rgba="0.45 0.45 0.47 1"/></material></visual>
    <visual><geometry><mesh filename="../meshes/pod_wheel_135.stl"/></geometry><material name="bought"><color rgba="0.45 0.45 0.47 1"/></material></visual>
  </link>
  <link name="wheel_rear_right_link">
    <inertial><origin xyz="-0.00210986 0 0"/><mass value="0.7557"/><inertia ixx="0.00217797" ixy="0" ixz="0" iyy="0.00117171" iyz="0" izz="0.00117171"/></inertial>
    <visual><geometry><mesh filename="../meshes/pod_hub_225.stl"/></geometry><material name="al7075"><color rgba="0.72 0.74 0.77 1"/></material></visual>
    <visual><geometry><mesh filename="../meshes/pod_axle_225.stl"/></geometry><material name="steel"><color rgba="0.45 0.45 0.47 1"/></material></visual>
    <visual><geometry><mesh filename="../meshes/pod_wheel_225.stl"/></geometry><material name="bought"><color rgba="0.45 0.45 0.47 1"/></material></visual>
  </link>
  <link name="wheel_front_right_link">
    <inertial><origin xyz="-0.00210986 0 0"/><mass value="0.7557"/><inertia ixx="0.00217797" ixy="0" ixz="0" iyy="0.00117171" iyz="0" izz="0.00117171"/></inertial>
    <visual><geometry><mesh filename="../meshes/pod_hub_315.stl"/></geometry><material name="al7075"><color rgba="0.72 0.74 0.77 1"/></material></visual>
    <visual><geometry><mesh filename="../meshes/pod_axle_315.stl"/></geometry><material name="steel"><color rgba="0.45 0.45 0.47 1"/></material></visual>
    <visual><geometry><mesh filename="../meshes/pod_wheel_315.stl"/></geometry><material name="bought"><color rgba="0.45 0.45 0.47 1"/></material></visual>
  </link>
  <joint name="neck_yaw" type="revolute">
    <parent link="torso_link"/><child link="neck_link"/>
    <origin xyz="0 0 0.41"/><axis xyz="0 0 1"/>
    <limit lower="-1.0472" upper="1.0472" effort="4.9" velocity="7.85398"/>
  </joint>
  <joint name="neck_pitch" type="revolute">
    <parent link="neck_link"/><child link="head_link"/>
    <origin xyz="0 0 0.035"/><axis xyz="0 1 0"/>
    <limit lower="-0.349066" upper="0.698132" effort="4.9" velocity="7.85398"/>
  </joint>
  <joint name="left_shoulder_pitch" type="revolute">
    <parent link="torso_link"/><child link="left_shoulder_pitch_link"/>
    <origin xyz="0 0.11 0.35"/><axis xyz="0 -1 0"/>
    <limit lower="-1.0472" upper="3.14159" effort="60" velocity="20.4204"/>
  </joint>
  <joint name="left_shoulder_roll" type="revolute">
    <parent link="left_shoulder_pitch_link"/><child link="left_shoulder_roll_link"/>
    <origin xyz="0 0.048 -0.025"/><axis xyz="1 0 0"/>
    <limit lower="-0.349066" upper="2.0944" effort="42" velocity="13.09"/>
  </joint>
  <joint name="left_shoulder_yaw" type="revolute">
    <parent link="left_shoulder_roll_link"/><child link="left_upper_arm_link"/>
    <origin xyz="0 0 -0.085"/><axis xyz="0 0 -1"/>
    <limit lower="-2.61799" upper="2.61799" effort="42" velocity="13.09"/>
  </joint>
  <joint name="left_elbow" type="revolute">
    <parent link="left_upper_arm_link"/><child link="left_forearm_link"/>
    <origin xyz="0 0 -0.115"/><axis xyz="0 -1 0"/>
    <limit lower="0" upper="2.35619" effort="42" velocity="13.09"/>
  </joint>
  <joint name="left_wrist_yaw" type="revolute">
    <parent link="left_forearm_link"/><child link="left_wrist_link"/>
    <origin xyz="0 0 -0.125"/><axis xyz="0 0 -1"/>
    <limit lower="-1.5708" upper="1.5708" effort="14" velocity="32.9867"/>
  </joint>
  <joint name="left_wrist_pitch" type="revolute">
    <parent link="left_wrist_link"/><child link="left_palm_link"/>
    <origin xyz="0 0 -0.063"/><axis xyz="0 -1 0"/>
    <limit lower="-1.0472" upper="1.0472" effort="4.9" velocity="7.85398"/>
  </joint>
  <joint name="right_shoulder_pitch" type="revolute">
    <parent link="torso_link"/><child link="right_shoulder_pitch_link"/>
    <origin xyz="0 -0.11 0.35"/><axis xyz="0 -1 0"/>
    <limit lower="-1.0472" upper="3.14159" effort="60" velocity="20.4204"/>
  </joint>
  <joint name="right_shoulder_roll" type="revolute">
    <parent link="right_shoulder_pitch_link"/><child link="right_shoulder_roll_link"/>
    <origin xyz="0 -0.048 -0.025"/><axis xyz="-1 0 0"/>
    <limit lower="-0.349066" upper="2.0944" effort="42" velocity="13.09"/>
  </joint>
  <joint name="right_shoulder_yaw" type="revolute">
    <parent link="right_shoulder_roll_link"/><child link="right_upper_arm_link"/>
    <origin xyz="0 0 -0.085"/><axis xyz="0 0 1"/>
    <limit lower="-2.61799" upper="2.61799" effort="42" velocity="13.09"/>
  </joint>
  <joint name="right_elbow" type="revolute">
    <parent link="right_upper_arm_link"/><child link="right_forearm_link"/>
    <origin xyz="0 0 -0.115"/><axis xyz="0 -1 0"/>
    <limit lower="0" upper="2.35619" effort="42" velocity="13.09"/>
  </joint>
  <joint name="right_wrist_yaw" type="revolute">
    <parent link="right_forearm_link"/><child link="right_wrist_link"/>
    <origin xyz="0 0 -0.125"/><axis xyz="0 0 1"/>
    <limit lower="-1.5708" upper="1.5708" effort="14" velocity="32.9867"/>
  </joint>
  <joint name="right_wrist_pitch" type="revolute">
    <parent link="right_wrist_link"/><child link="right_palm_link"/>
    <origin xyz="0 0 -0.063"/><axis xyz="0 -1 0"/>
    <limit lower="-1.0472" upper="1.0472" effort="4.9" velocity="7.85398"/>
  </joint>
  <joint name="column_lift" type="prismatic">
    <parent link="lite_base"/><child link="column_link"/>
    <origin xyz="0 0 0.614"/><axis xyz="0 0 1"/>
    <limit lower="0" upper="0.45" effort="800" velocity="0.038"/>
  </joint>
  <joint name="waist_yaw" type="revolute">
    <parent link="column_link"/><child link="torso_link"/>
    <origin xyz="0 0 0.0443"/><axis xyz="0 0 1"/>
    <limit lower="-2.61799" upper="2.61799" effort="60" velocity="20.4204"/>
  </joint>
  <joint name="wheel_front_left" type="continuous">
    <parent link="lite_base"/><child link="wheel_front_left_link"/>
    <origin xyz="0.164756 0.164756 0.076" rpy="0 0 0.785398"/><axis xyz="1 0 0"/>
    <limit effort="14" velocity="32.9867"/>
  </joint>
  <joint name="wheel_rear_left" type="continuous">
    <parent link="lite_base"/><child link="wheel_rear_left_link"/>
    <origin xyz="-0.164756 0.164756 0.076" rpy="0 0 2.35619"/><axis xyz="1 0 0"/>
    <limit effort="14" velocity="32.9867"/>
  </joint>
  <joint name="wheel_rear_right" type="continuous">
    <parent link="lite_base"/><child link="wheel_rear_right_link"/>
    <origin xyz="-0.164756 -0.164756 0.076" rpy="0 0 3.92699"/><axis xyz="1 0 0"/>
    <limit effort="14" velocity="32.9867"/>
  </joint>
  <joint name="wheel_front_right" type="continuous">
    <parent link="lite_base"/><child link="wheel_front_right_link"/>
    <origin xyz="0.164756 -0.164756 0.076" rpy="0 0 5.49779"/><axis xyz="1 0 0"/>
    <limit effort="14" velocity="32.9867"/>
  </joint>
</robot>
