kranthie/marvin-bot/cad/covers.py

"""Clip-on body shells: an optional add-on over the bare structure.

The robot is designed to look finished without them (graphite printed shells, aluminium
plates, the actuators' own housings). The shells give it a finished body: a smooth light
torso tapering to the waist, a dark hip girdle, long leg shells, arm sleeves, toe caps and a
light neck sleeve under the head, with the joints left visible between them. They add
some fall protection.

Each shell is a 1.0 mm printed skin following its link's parts and motors at a 4 mm gap: the
hull of everything on the link, grown outward (rounded), kept only where it cannot reach the
next link, and split where it must come off for service. It is slotted where it hugs a motor
housing (`vents`, for the motor's cooling) and cut back round each joint's harness service
loop (`loop_rooms`). Shells clip onto the parts under them
(clip and boss details come with the fastener pass), so every one comes off without tools,
and none carries load. `python -m cad.covers --check` moves every joint through its range and
fails if a shell touches a part of another link.

They stay out of the physics model by default: tools/build_urdf.py writes them, with their
mass, only into description/urdf/marvin_bot_covers.urdf.
"""

from __future__ import annotations

import sys
from pathlib import Path

import manifold3d as mf
import numpy as np
import yaml

from . import arm, head, leg, torso
from .lib import Part, box, cyl, hull, union

ROOT = Path(__file__).resolve().parent.parent
GAP, SKIN = 4.0, 1.0


def _sphere_dirs() -> list[np.ndarray]:
    """42 directions spread over the sphere (an icosahedron, subdivided once): offsetting a
    hull along them rounds its edges."""
    t = (1 + 5**0.5) / 2
    v = [(-1, t, 0), (1, t, 0), (-1, -t, 0), (1, -t, 0), (0, -1, t), (0, 1, t)]
    v += [(0, -1, -t), (0, 1, -t), (t, 0, -1), (t, 0, 1), (-t, 0, -1), (-t, 0, 1)]
    pts = [np.array(p, float) / np.linalg.norm(p) for p in v]
    edge = min(np.linalg.norm(pts[0] - q) for q in pts[1:])
    mids = []
    for i, a in enumerate(pts):
        for b in pts[i + 1 :]:
            if np.linalg.norm(a - b) < edge * 1.01:
                m = (a + b) / 2
                mids.append(m / np.linalg.norm(m))
    return pts + mids


_DIRS = _sphere_dirs()
BIG = 1000.0


def motors_on(link: str):
    """The motor housings carried by `link`, as solids (mm, link frame)."""
    sys.path.insert(0, str(ROOT / "tools"))
    import build_urdf

    return [motor_solid(m) for m in build_urdf.motor_placements() if m["link"] == link]


def motor_solid(m: dict):
    """A placed motor's housing (tools/build_urdf.py motor_primitives) as one solid, mm."""
    sys.path.insert(0, str(ROOT / "tools"))
    import build_urdf

    solids = []
    for p in build_urdf.motor_primitives(m):
        c = [x * 1000 for x in p["centre"]]
        if p["kind"] == "box":
            solids.append(box([x * 1000 for x in p["size"]], c))
        else:
            ax = "xyz"[int(np.argmax(np.abs(p["axis"])))]
            solids.append(cyl(p["d"] * 1000, p["length"] * 1000, ax, c))
    return union(*solids)


def offset_hull(solids, r: float):
    """Hull of `solids` grown by about r in every direction."""
    h = hull(*solids)
    return hull(*[h.translate(list(r * d)) for d in _DIRS])


def _ngon(n: int, phase: float, squash: float) -> np.ndarray:
    """A unit n-gon (x forward, y left), its corners pushed out towards the unit square by
    `squash` < 1 so it hugs a box-shaped section."""
    a = np.radians(phase + 360.0 * np.arange(n) / n)
    x, y = np.cos(a), np.sin(a)
    pts = np.column_stack([np.sign(x) * np.abs(x) ** squash, np.sign(y) * np.abs(y) ** squash])
    return pts[np.argsort(np.arctan2(pts[:, 1], pts[:, 0]), kind="stable")]


def _inside(poly: np.ndarray, p) -> bool:
    for i in range(len(poly)):
        a, b = poly[i], poly[(i + 1) % len(poly)]
        if (b[0] - a[0]) * (p[1] - a[1]) - (b[1] - a[1]) * (p[0] - a[0]) < -1e-9:
            return False
    return True


def faceted(solids, gap: float, levels: int = 9, n: int = 8, twist: float = 22.5, neck=None):
    """The torso's faceted body: squashed n-gons at `levels` heights, alternate ones turned by
    `twist` (the diamonds), each sized, symmetric about y = 0, to hold everything within 14 % of
    the height either side of it plus `gap`, and slightly fuller at mid-height; the hull of
    them all. `neck` = height of a small n-gon the shoulders rise to round the neck."""
    h = union(*solids)
    lo, hi = h.bounding_box()[2], h.bounding_box()[5]
    z0, z1 = lo - gap, hi + gap
    span = z1 - z0

    def held(a, b):
        sl = h ^ box((BIG, BIG, b - a), (0, 0, (a + b) / 2))
        bb = sl.bounding_box()
        return bb[0] - gap, max(abs(bb[1]), abs(bb[4])) + gap, bb[3] + gap

    def section(shape, x0, w, x1, grow):
        c, a, b = np.array([(x0 + x1) / 2, 0.0]), (x1 - x0) / 2, w
        k = 1.0
        while not all(
            _inside(c + shape * [a * k, b * k], q) for q in [(x0, -w), (x0, w), (x1, -w), (x1, w)]
        ):
            k *= 1.01
        return c + shape * [a * k * grow, b * k * grow]

    pts = []
    for i, f in enumerate(np.linspace(0, 1, levels)):
        x0, w, x1 = held(lo + max(0.0, f - 0.14) * span, lo + min(1.0, f + 0.14) * span)
        poly = section(_ngon(n, twist * (i % 2), 0.75), x0, w, x1, 1.0 + 0.03 * np.sin(np.pi * f))
        pts += [[p[0], p[1], z0 + f * span] for p in poly]
    if neck is not None:
        x0, w, x1 = held(hi - 0.02 * span, hi)
        poly = section(_ngon(n, twist, 0.75), x0, w, x1, 0.45)
        pts += [[p[0], p[1], neck + gap] for p in poly]
    return mf.Manifold.hull_points(np.array(pts))


def side_keep(body, half_w: float, shoulder_z: float, top_c: float = 28.0, edge_c: float = 22.0):
    """The region a torso shell keeps sideways: |y| <= half_w, its side walls' top edge
    bevelled in by `top_c` and their front and back edges chamfered by up to `edge_c`, growing
    from 110 mm below the shoulder axis to the top."""
    b = body.bounding_box()
    x0, x1, zt = b[0] - 1, b[3] + 1, b[5] + 1

    def layer(z, w, c):
        return [(x1, w - c, z), (x1 - c, w, z), (x0 + c, w, z), (x0, w - c, z)] + [
            (x, -y, z)
            for x, y, _ in [(x0, w - c, z), (x0 + c, w, z), (x1 - c, w, z), (x1, w - c, z)]
        ]

    pts = layer(-BIG, half_w, 0.0) + layer(shoulder_z - 110, half_w, 0.0)
    pts += layer(zt - top_c, half_w, edge_c) + layer(zt, half_w - top_c, edge_c)
    return mf.Manifold.hull_points(np.array(pts))


def front_bevel(body, at: float, slope: float, z0: float, inset: float = 0.0):
    """`body` with its two front side corners bevelled: kept where x + |y| <= `at` at height
    `z0`, `slope` mm less per mm higher, so the bevel deepens towards the shoulders; `inset`
    moves the planes in by that much (the skin's inner face)."""
    for sy in (1, -1):
        n = np.array([1.0, sy, slope])
        k = np.linalg.norm(n)
        body = body.trim_by_plane((-n / k).tolist(), -(at + slope * z0) / k + inset)
    return body


def wrap(solids, keep, cut=(), extra: float = 0.0):
    """A cover skin around `solids`, kept inside the `keep` region, minus the `cut` regions;
    `extra` mm more gap gives a fuller, rounder shape over boxy parts."""
    g = GAP + extra
    skin = offset_hull(solids, g + SKIN) - offset_hull(solids, g)
    skin = skin ^ keep
    for c in cut:
        skin = skin - c
    return skin


def half(axis: str, sign: int, at: float = 0.0, lo=None, hi=None):
    """The half-space beyond `at` along `axis` (sign +1: coordinate > at; -1: coordinate < at),
    optionally cut to lo < z < hi."""
    i = "xyz".index(axis)
    centre = [0.0, 0.0, 0.0]
    centre[i] = at + sign * BIG / 2
    region = box((BIG, BIG, BIG), centre)
    if lo is not None or hi is not None:
        lo = -BIG if lo is None else lo
        hi = BIG if hi is None else hi
        region = region ^ box((BIG, BIG, hi - lo), (0, 0, (lo + hi) / 2))
    return region


def parts() -> list[Part]:
    by_link: dict[str, list] = {}
    for p in leg.parts() + torso.parts() + arm.parts() + head.parts():
        by_link.setdefault(p.link, []).append(p.solid)

    skel = yaml.safe_load((ROOT / "description" / "skeleton.yaml").read_text())
    # equipment still drawn as estimate boxes (computer, battery, electronics) also gets covered
    for b in skel["bodies"]:
        if b["budget"] in ("compute", "battery", "keep_alive", "electronics"):
            by_link.setdefault(b["link"], []).append(
                box([x * 1000 for x in b["size"]], [x * 1000 for x in b["xyz"]])
            )

    def on(link):
        return by_link.get(link, []) + motors_on(link)

    out: list[Part] = []

    def add(name, link, solid):
        out.append(Part(name, link, "petg", solid, "cover"))  # white PETG

    j = {k: [x * 1000 for x in v["xyz"]] for k, v in skel["joints"].items()}
    acts = yaml.safe_load((ROOT / "description" / "actuators.yaml").read_text())

    def env(model):
        d, _, t = acts[model]["envelope_mm"]
        return d, t

    d04, t04 = env("RS04")
    models = {
        m["name"].replace("{side}", "left"): m["model"]
        for m in yaml.safe_load((ROOT / "description" / "robot.yaml").read_text())["motors"]
    }
    _, t_roll = env(models["left_shoulder_roll"])
    _, t_yaw = env(models["left_shoulder_yaw"])
    d_elbow, _ = env(models["left_elbow"])
    d00, t00 = env("RS00")

    # --- torso: a faceted shell from the waist to the shoulders, in a front half and a back half
    # (the back half comes off for the battery). It stops short of the shoulder flanges, leaves
    # a round opening for the neck sleeve, and its bottom edge clears the hip girdle.
    # the shell covers the inner part of the shoulder pitch motors: broad shoulders over a
    # narrower chest and waist; the motors' outer ends pass through the side walls
    tor = on("torso_link")
    sh_y = j["left_shoulder_pitch"][1] - 12  # inside the shoulder pitch output flange
    sh = j["left_shoulder_pitch"]
    neck_z = j["neck_yaw"][2]
    body = (
        box((BIG, BIG, BIG), (0, 0, 0))
        - half("z", -1, 26.0)
        - (cyl(108, BIG, "y", (sh[0], 0, sh[2])) - box((BIG, 2 * 110, BIG)))  # shoulder motors
        - cyl(100, 200, "z", (0, 0, neck_z))  # the neck opening
    )
    # faceted: alternate sections turned half a step make diamond facets, the shoulders rise to
    # the neck, and the side walls short of the shoulder flanges are chamfered at the shoulders
    outer_b = faceted(tor, GAP + SKIN, neck=neck_z + 4)
    inner_b = faceted(tor, GAP, neck=neck_z + 4)
    # the front corners bevelled deeper towards the shoulders: the shoulder roll bracket swings
    # past them with the arm forward and rolled in (cad/covers.py --check)
    bev = (147.0, 0.35, sh[2])
    skin = front_bevel(outer_b ^ side_keep(outer_b, sh_y, sh[2]), *bev) - front_bevel(
        inner_b ^ side_keep(outer_b, sh_y - SKIN, sh[2]), *bev, inset=SKIN
    )
    # each half in four pieces (left and right, chest and waist): a whole half is too big to
    # print; the seams run down the middle and round the body under the chest
    seam_z = 200.0
    for name, s_ in (("front", 1), ("back", -1)):
        part = skin ^ body ^ half("x", s_, -20)
        for side, sy in (("l", 1), ("r", -1)):
            q = part ^ half("y", sy, 0)
            add(f"torso_cover_{name}_{side}", "torso_link", q ^ half("z", 1, seam_z))
            add(f"torso_cover_{name}_{side}_waist", "torso_link", q ^ half("z", -1, seam_z))

    # --- neck sleeve (light, flexible print): from inside the torso shell's neck opening up
    # into the head, turning with neck yaw; the head pitches over it
    nz = j["neck_pitch"][2]
    bot = -22.0  # just above the torso bridge; flaring towards the collar

    # oval at the top: wide side to side for the head frame's plates, narrow front to back so
    # the chin clears it looking down
    def oval(w, d, z):
        return cyl(w, 2, "z").scale([d / w, 1.0, 1.0]).translate([0, 0, z])

    # its top 5 mm up inside the head's open underside (cad/head.py: its rim 29 mm above the
    # pitch axis), so no gap shows between them
    top = nz + head.SIDE[0][0] + head.HEAD_RISE + 5.0
    sleeve = hull(cyl(92, 2, "z", (0, 0, bot)), oval(84, 60, top)) - hull(
        cyl(88, 2, "z", (0, 0, bot - 2)), oval(80, 56, top + 2)
    )
    add("neck_cover", "neck_link", sleeve)

    # --- hip girdle (dark): round the pelvis frame and the waist motor, between the hips
    # (the hip pitch motors swing round the roll axes on either side of it)
    pel = [m_ for m_ in on("pelvis") if abs((m_.bounding_box()[1] + m_.bounding_box()[4]) / 2) < 50]
    waist_top = j["waist_yaw"][2] + 18.0  # below the torso shell's bottom edge
    centre = half("y", 1, -28) ^ half("y", -1, 28)
    # not under the front of the gussets: the thighs swing to the centre line there; in two
    # pieces, front and back, each inside the printer's 250 mm
    girdle = wrap(
        pel,
        (centre ^ half("z", -1, waist_top) ^ half("z", 1, -75))
        - (half("x", 1, -62) ^ half("z", -1, -10)),
    )
    add("pelvis_cover_back", "pelvis", girdle ^ half("x", -1, -60))
    add("pelvis_cover_front", "pelvis", girdle ^ half("x", 1, -60))

    # --- thigh shell: all round the thigh from its hip yaw ring (the yaw motor is the thigh's)
    # to the knee, except a strip at the back of the inner side (harness); over the knee motor
    # only in front
    knee_z = j["left_knee"][2]
    thigh = on("left_thigh_link")
    upper = half("z", -1, leg.YAW_RING_FRONT - 1) ^ half("z", 1, knee_z + d04 / 2 + 10)
    kneecap = half("z", 1, knee_z - 10, None, knee_z + d04 / 2 + 12) ^ half("x", 1, 40)
    add(
        "left_thigh_cover",
        "left_thigh_link",
        wrap(thigh, (upper + kneecap) - (half("x", -1, -25) ^ half("y", -1, -10))),
    )

    # --- shin shell: front and sides, from below the knee to above the ankle; open at the back
    # where the cranks and push rods move
    ankle_z = j["left_ankle_pitch"][2]
    shin = on("left_shin_link")
    add(
        "left_shin_cover",
        "left_shin_link",
        wrap(shin, half("x", 1, 0, ankle_z + 55, -d04 / 2 - 12)),
    )

    # (no shell over the hip roll motors behind the hips: they are left bare)
    # --- upper thigh: round the hip pitch yoke down to its floor on the yaw hub, between the
    # pitch motor (which the yoke turns round) and the thigh's yaw ring, where the thigh shell
    # starts
    yaw = j["left_hip_yaw"]
    add(
        "left_upper_thigh_cover",
        "left_hip_pitch_link",
        wrap(
            on("left_hip_pitch_link"),
            half("z", -1, -d04 / 2 - 8)
            ^ half("z", 1, yaw[2] + leg.YAW_RING_FRONT + 1)
            ^ half("x", 1, -38)  # the hip roll motor and carrier are behind it as the hip extends
            ^ half("y", 1, -30),  # and the pelvis inboard of it when the hip flexes
        ),
    )
    # --- shoulder cap: over the top of the shoulder roll motor. The roll link's parts swing
    # round the roll axis from straight down to 30° above horizontal, so the cap keeps above a
    # plane through that axis at 40°, and behind the roll output face
    ro = j["left_shoulder_roll"]
    up = box((BIG, BIG, BIG), (0, 0, BIG / 2)).rotate([45, 0, 0]).translate([0, ro[1], ro[2]])
    add(
        "left_shoulder_cover",
        "left_shoulder_pitch_link",
        wrap(
            on("left_shoulder_pitch_link"),
            up ^ half("x", -1, t_roll / 2 - 4) ^ half("x", 1, -40) ^ half("y", 1, 14),
        ),
    )

    # --- arm sleeves: the upper arm from the yaw output to above the elbow motor, the forearm
    # from below the elbow motor to the wrist output
    el = j["left_elbow"]
    # the yaw motor's centre in the upper arm's frame (skeleton.yaml motor_mounts)
    yaw_mount = skel.get("motor_mounts", {}).get("left_shoulder_yaw", {}).get("xyz")
    um_z = (yaw_mount[2] * 1000 - j["left_shoulder_yaw"][2]) if yaw_mount else 0.0
    band = half("z", -1, um_z - t_yaw / 2 - 8) ^ half("z", 1, el[2] + d_elbow / 2 + 6)
    # and down the back of the elbow motor: the forearm swings forward, never back
    elbow_back = half("z", -1, um_z - t_yaw / 2 - 8) ^ half("z", 1, el[2]) ^ half("x", -1, -24)
    add(
        "left_upper_arm_cover",
        "left_upper_arm_link",
        wrap(on("left_upper_arm_link"), band + elbow_back),
    )
    wr = j["left_wrist_yaw"]
    add(
        "left_forearm_cover",
        "left_forearm_link",
        wrap(
            on("left_forearm_link"),
            # its top no higher than below an RS06 (Ø85): a smaller elbow motor would let it
            # reach up into the shoulder roll link with the arm forward and the elbow bent
            half("z", -1, -max(d_elbow, 85.0) / 2 - 26) ^ half("z", 1, wr[2] - t00 / 2 + 2),
        ),
    )

    # --- toe cap: over the front of the foot, above the sole
    foot = on("left_foot_link")
    add("left_toe_cover", "left_foot_link", wrap(foot, half("x", 1, 55) ^ half("z", 1, -54)))

    # vents where a shell hugs a motor housing, and room for the harness's service loops
    made_parts = leg.parts() + torso.parts() + arm.parts() + head.parts()
    rooms = loop_rooms(skel, {p.name: p for p in made_parts})
    for k, p in enumerate(out):
        solid = p.solid - vents(p.link)
        for link, room in rooms:
            if link == p.link:
                solid = solid - room
        out[k] = Part(p.name, p.link, p.material, solid, p.process)
    return out


# a grille over a motor: slot width and spacing, its half-angle and how far out it cuts
VENT_W, VENT_PITCH, VENT_ARC, VENT_REACH = 4.0, 9.0, 30.0, 16.0


def vents(link: str):
    """A grille in a limb shell over each of `link`'s RobStride housings, on its front (a
    RobStride's rated torque assumes its housing can shed heat): parallel slots along the
    housing, VENT_PITCH apart over +-VENT_ARC degrees about the forward direction, each cut
    right through the shell wherever it passes within VENT_REACH of the housing, so every slot
    is a whole, straight line. Housings along x (pointing forward), the legs' shells (the thigh
    and shin keep clean faces) and the torso, pelvis and head get none."""
    sys.path.insert(0, str(ROOT / "tools"))
    import build_urdf

    cuts = []
    if not link.startswith(("left_", "right_")) or "thigh" in link or "shin" in link:
        return box((0.01, 0.01, 0.01), (BIG, BIG, BIG))
    for m in build_urdf.motor_placements():
        if m["link"] != link or not (m.get("shape") or {}).get("cap_d"):
            continue
        ax = np.asarray(m["axis"], float)
        if abs(ax[0]) > 0.5:
            continue
        d, t = m["envelope"][0] * 1000, m["envelope"][2] * 1000
        r0, r1 = d / 2 + 1, d / 2 + VENT_REACH
        step = np.degrees(VENT_PITCH / ((r0 + r1) / 2))
        slot = box((r1 - r0, VENT_W, 0.6 * t), ((r0 + r1) / 2, 0, 0))
        angles = np.arange(-VENT_ARC, VENT_ARC + 0.1, step)
        grille = union(*[slot.rotate([0, 0, float(a)]) for a in angles - angles.mean()])
        if abs(ax[1]) > 0.5:
            grille = grille.rotate([90, 0, 0])  # about x: local x stays forward
        cuts.append(grille.translate([x * 1000 for x in m["xyz"]]))
    return union(*cuts) if cuts else box((0.01, 0.01, 0.01), (BIG, BIG, BIG))


LOOP_ARC = 20.0  # degrees of swing room past each clip
LOOP_R = 9.0  # the half-width of a service loop's room: a 12 mm bundle and its swing


def loop_rooms(skel: dict, parts: dict) -> list[tuple[str, object]]:
    """Room for each joint's harness service loop, cut from the shells of the joint's two links:
    a band round the joint's axis, LOOP_R either side of the loop radially and along the axis,
    over the arc the loop runs between the clips it is tied to (tools/build_harness.py's CLIPS;
    a plate's clip hole where cad/ records it, else the clip part's centre), plus LOOP_ARC either
    side for its swing. Of the two arcs it takes the shorter, or the rear one when they are near
    equal (as at the knee, clipped above and below the axis), so it never notches a front face.
    [(link, solid in that link's frame)]; left side and centre (the right side is mirrored)."""
    sys.path.insert(0, str(ROOT / "tools"))
    import build_harness

    joints = skel["joints"]
    origin = {"pelvis": np.zeros(3)}
    pending = dict(joints)
    while pending:
        for k, v in list(pending.items()):
            if v["parent"] in origin:
                origin[v["child"]] = origin[v["parent"]] + np.array(v["xyz"]) * 1000
                del pending[k]
    out = []
    for jn, pair in build_harness.CLIPS.items():
        j = joints[jn]
        ax = np.asarray(j["axis"], float)
        ax = ax / np.linalg.norm(ax)
        jo = origin[j["child"]]
        # the ring's local frame (axis z) in world terms, as the rotations below place it
        if abs(ax[0]) > 0.5:
            rot, to_local = [0, 90, 0], lambda w: np.array([-w[2], w[1], w[0]])
        elif abs(ax[1]) > 0.5:
            rot, to_local = [90, 0, 0], lambda w: np.array([w[0], w[2], -w[1]])
        else:
            rot, to_local = [0, 0, 0], lambda w: np.asarray(w, float)
        alongs, radii, angles = [], [], []
        for name in pair:
            p = parts[name]
            if "clip" in p.extra:
                c = np.asarray(p.extra["clip"], float)
            else:
                b = np.array(p.solid.bounding_box())
                c = (b[:3] + b[3:]) / 2
            v = origin[p.link] + c - jo
            a = float(v @ ax)
            q = to_local(v - a * ax)
            alongs.append(a)
            radii.append(float(np.hypot(q[0], q[1])))
            angles.append(np.degrees(np.arctan2(q[1], q[0])))
        along, r = float(np.mean(alongs)), float(np.mean(radii))
        a0, a1 = angles
        span = (a1 - a0) % 360.0
        back = to_local(np.array([-1.0, 0.0, 0.0]) - (-ax[0]) * ax)
        if abs(span - 180.0) < 20.0 and np.hypot(back[0], back[1]) > 0.5:
            mid_a = a0 + span / 2
            rear = np.degrees(np.arctan2(back[1], back[0]))
            if np.cos(np.radians(mid_a - rear)) < 0:
                a0, span = a1, 360.0 - span
        elif span > 180.0:
            a0, span = a1, 360.0 - span
        ts = np.radians(np.linspace(a0 - LOOP_ARC, a0 + span + LOOP_ARC, 48))
        big = 4 * (r + LOOP_R)
        wedge = (
            mf.CrossSection([[(0.0, 0.0)] + [(big * np.cos(t), big * np.sin(t)) for t in ts]])
            .extrude(4 * LOOP_R)
            .translate([0, 0, -2 * LOOP_R])
        )
        ring = cyl(2 * (r + LOOP_R), 2 * LOOP_R, "z") - cyl(
            2 * max(r - LOOP_R, 1.0), 4 * LOOP_R, "z"
        )
        world = (ring ^ wedge).rotate(rot).translate(list(jo + along * ax))
        for link in (j["parent"], j["child"]):
            out.append((link, world.translate(list(-origin[link]))))
    return out


def all_parts() -> list[Part]:
    ps = parts()
    return ps + [p.mirrored() for p in ps if p.name.startswith("left_")]


# ------------------------------------------------------------------------- clearance check

SIDE_GROUPS = ("leg", "arm")  # shells on one limb are not checked against the other limbs


def _group(link: str) -> str:
    if link.startswith(("left_", "right_")):
        side, rest = link.split("_", 1)
        limb = (
            "arm"
            if rest.startswith(("shoulder", "upper_arm", "forearm", "wrist", "palm"))
            else "leg"
        )
        return f"{side}_{limb}"
    return "pelvis" if link == "pelvis" else "upper"


def _checked(a: str, b: str) -> bool:
    """Pairs that must never touch: within a limb, a limb and the body it hangs from (legs from
    the pelvis, arms from the upper body), the pelvis and the upper body. A hand against a hip
    or a leg against the other leg is the controller's business, as in check_packaging.py."""
    ga, gb = _group(a), _group(b)
    if ga == gb or {ga, gb} == {"pelvis", "upper"}:
        return True
    hangs = {"leg": "pelvis", "arm": "upper"}
    return any(
        x.endswith(("leg", "arm")) and hangs[x.split("_")[1]] == y for x, y in ((ga, gb), (gb, ga))
    )


def poses(joints: dict, ranges: dict, coupled: list | None = None) -> list[tuple[str, dict]]:
    """Each joint at both ends and half of each end of its range (the others at zero), each
    point of a coupled limit and the midpoints between them, and some combined poses."""
    coupled = coupled or []
    out = [("zero", {})]
    for name in joints:
        lo, hi = ranges[name]
        for q in (lo, lo / 2, hi / 2, hi):
            if q and not any(c["joint"] == name and q < 0 for c in coupled):
                out.append((f"{name} {q:+.0f}", {name: q}))
    for c in coupled:
        pts = c["min"]
        mids = [[(a[0] + b[0]) / 2, (a[1] + b[1]) / 2] for a, b in zip(pts, pts[1:], strict=False)]
        for by, q in pts + mids:
            if q:
                out.append(
                    (f"{c['joint']} {q:+.0f} at {c['by']} {by:+.0f}", {c["by"]: by, c["joint"]: q})
                )
    for side in ("left", "right"):
        out += [
            (
                f"{side} deep squat",
                {f"{side}_hip_pitch": 70, f"{side}_knee": 125, f"{side}_ankle_pitch": 40},
            ),
            (f"{side} knee up", {f"{side}_hip_pitch": 110, f"{side}_knee": 110}),
            (
                f"{side} step back",
                {f"{side}_hip_pitch": -30, f"{side}_knee": 60, f"{side}_ankle_pitch": -30},
            ),
            (
                f"{side} arm forward, elbow bent",
                {f"{side}_shoulder_pitch": 90, f"{side}_elbow": 135},
            ),
            (f"{side} arm up", {f"{side}_shoulder_pitch": 180, f"{side}_shoulder_roll": 10}),
            (
                f"{side} arm out, yawed",
                {f"{side}_shoulder_roll": 90, f"{side}_shoulder_yaw": 90, f"{side}_elbow": 90},
            ),
            (
                f"{side} hand to chest",
                {f"{side}_shoulder_pitch": 60, f"{side}_shoulder_yaw": -90, f"{side}_elbow": 120},
            ),
        ]
        for ap in (-40, 40):  # the ankle's corners, where the linkage is most stretched
            for ar in (-20, 20):
                out.append(
                    (
                        f"{side} ankle {ap:+d}/{ar:+d}",
                        {f"{side}_ankle_pitch": ap, f"{side}_ankle_roll": ar},
                    )
                )
    out += [
        ("look down, turned", {"neck_pitch": 40, "neck_yaw": 60}),
        ("look up, turned", {"neck_pitch": -20, "neck_yaw": -60}),
        ("waist turned, arms down", {"waist_yaw": 90}),
    ]
    return out


def _rot(axis, q: float) -> np.ndarray:
    a = np.asarray(axis, float)
    a = a / np.linalg.norm(a)
    k = np.array([[0, -a[2], a[1]], [a[2], 0, -a[0]], [-a[1], a[0], 0]])
    return np.eye(3) + np.sin(q) * k + (1 - np.cos(q)) * k @ k


def check(min_cm3: float = 0.5, parts_too: bool = True) -> list[str]:
    """Shell-to-part contacts (overlap above min_cm3) over the poses, worst per pair; with
    `parts_too`, also part-to-part contacts between links beyond the overlap they already
    have at rest (where parts bolt to the next link's motor)."""
    sys.path.insert(0, str(ROOT / "tools"))
    import build_urdf as bu

    robot = yaml.safe_load((ROOT / "description" / "robot.yaml").read_text())
    skel = yaml.safe_load((ROOT / "description" / "skeleton.yaml").read_text())
    joints = bu.mirrored(skel["joints"], key_is_name=True)
    ranges = {j["name"]: j["range"] for j in bu.expand(robot["joints"])}
    coupled = bu.expand(robot.get("coupled_limits", []))
    body: dict[str, list] = {}
    for p in leg.all_parts() + torso.parts() + arm.all_parts() + head.parts():
        if "ankle_rod" in p.name or "ankle_crank" in p.name:
            continue  # drawn at the neutral pose only; they move with the ankle
        body.setdefault(p.link, []).append(p.solid)
    for m in bu.motor_placements():
        body.setdefault(m["link"], []).append(motor_solid(m))
    for b in bu.mirrored(skel["bodies"], key_is_name=False):
        if b["budget"] in ("compute", "battery", "keep_alive", "electronics"):
            body[b["link"]].append(box([x * 1000 for x in b["size"]], [x * 1000 for x in b["xyz"]]))
    shells: dict[str, list] = {}
    for p in all_parts():
        shells.setdefault(p.link, []).append(p.solid)
    body_u = {k: hull_free_union(v) for k, v in body.items()}
    shell_u = {k: hull_free_union(v) for k, v in shells.items()}
    worst: dict[tuple, tuple] = {}
    rest: dict[tuple, float] = {}
    for label, q in poses(joints, ranges, coupled):
        world = {"pelvis": (np.eye(3), np.zeros(3))}
        pending = dict(joints)
        while pending:
            for name, jt in list(pending.items()):
                if jt["parent"] in world:
                    r, t = world[jt["parent"]]
                    rj = r @ _rot(jt["axis"], np.radians(q.get(name, 0.0)))
                    world[jt["child"]] = (rj, t + r @ (np.array(jt["xyz"]) * 1000))
                    del pending[name]

        def placed(m, link, world=world):
            r, t = world[link]
            return m.transform(np.hstack([r, t[:, None]]).tolist())

        cache = {}
        for side in ("left", "right"):
            pq = np.radians(q.get(f"{side}_ankle_pitch", 0.0))
            rq = np.radians(q.get(f"{side}_ankle_roll", 0.0))
            for name, solid in ankle_linkage_solids(side, pq, rq):
                lw = placed(solid, f"{side}_shin_link")
                lb = np.array(lw.bounding_box())
                for b in (
                    f"{side}_shin_link",
                    f"{side}_foot_link",
                    f"{side}_thigh_link",
                    f"{side}_ankle_link",
                ):
                    if b not in body_u:
                        continue
                    other = placed(body_u[b], b)
                    ob = np.array(other.bounding_box())
                    if np.any(lb[3:] < ob[:3]) or np.any(ob[3:] < lb[:3]):
                        continue
                    v = (lw ^ other).volume() / 1000
                    key = (f"{side}_{name}", b, "part")
                    if label == "zero":
                        rest[key] = v
                    v -= rest.get(key, 0.0)
                    if v > min_cm3 and v > worst.get(key, (0, ""))[0]:
                        worst[key] = (v, label)
        if parts_too:
            placed_b = {k: placed(v, k) for k, v in body_u.items()}
            for a in body_u:
                ba = np.array(placed_b[a].bounding_box())
                for b in body_u:
                    if b <= a or not _checked(a, b):
                        continue
                    ob = np.array(placed_b[b].bounding_box())
                    if np.any(ba[3:] < ob[:3]) or np.any(ob[3:] < ba[:3]):
                        continue
                    v = (placed_b[a] ^ placed_b[b]).volume() / 1000
                    if label == "zero":
                        rest[(a, b)] = v
                    v -= rest.get((a, b), 0.0)
                    if v > min_cm3 and v > worst.get((a, b, "part"), (0, ""))[0]:
                        worst[(a, b, "part")] = (v, label)
        for a, sh in shell_u.items():
            sa = placed(sh, a)
            ba = np.array(sa.bounding_box())
            for b in world:
                if b == a:
                    continue
                if not _checked(a, b):
                    continue
                others = [x for x in (body_u.get(b), shell_u.get(b)) if x is not None]
                for kind, other in zip(("part", "shell"), others, strict=False):
                    key = (b, kind)
                    if key not in cache:
                        cache[key] = placed(other, b)
                    ob = np.array(cache[key].bounding_box())
                    if np.any(ba[3:] < ob[:3]) or np.any(ob[3:] < ba[:3]):
                        continue
                    v = (sa ^ cache[key]).volume() / 1000
                    if v > min_cm3 and v > worst.get((a, b), (0, ""))[0]:
                        worst[(a, b)] = (v, label)
    return [
        f"{'part' if len(k) == 3 else 'shell'} on {k[0]:24} x {k[1]:24} {v:6.1f} cm³ at {lbl}"
        for k, (v, lbl) in worst.items()
    ]


def ankle_linkage_solids(side: str, pitch: float, roll: float):
    """The two cranks and push rods of one ankle at a joint pose (radians), solved by
    tools/ankle_linkage.py, as solids in the shin frame (mm): [(name, solid)]."""
    sys.path.insert(0, str(ROOT / "tools"))
    import ankle_linkage as al

    skel = yaml.safe_load((ROOT / "description" / "skeleton.yaml").read_text())
    lk = al.Linkage(skel["ankle_linkage"]["geometry"])
    az = skel["joints"]["left_ankle_pitch"]["xyz"][2] * 1000  # ankle axis in the shin frame
    sgn = 1 if side == "left" else -1
    out = []
    for i, name in enumerate(("a", "b")):
        th = lk.crank(i, pitch, roll, lk.theta0)
        if th is None:
            continue
        m = lk.motor[i] * 1000
        tip = lk.tip(i, th) * 1000
        foot = lk.foot_point(i, pitch, roll) * 1000
        pts = [np.array([p_[0], sgn * p_[1], p_[2] + az]) for p_ in (m, tip, foot)]
        crank = hull(cyl(36, 6, "y", pts[0]), cyl(18, 6, "y", pts[1]))
        d = pts[2] - pts[1]
        rod = hull(*[box((8, 8, 8), pts[1] + d * f) for f in (0.08, 0.92)])  # clear of the ends
        out += [(f"crank_{name}", crank), (f"rod_{name}", rod)]
    return out


def hull_free_union(solids):
    from .lib import union

    return union(*solids)


if __name__ == "__main__":
    import argparse

    ap = argparse.ArgumentParser(description="clearance check of the clip-on shells")
    ap.add_argument("--check", action="store_true")
    ap.parse_args()
    hits = check()
    for h in hits:
        print(h)
    print(f"{len(hits)} shell contacts")
    sys.exit(1 if hits else 0)
