kranthie/marvin-bot/cad/build.py

"""Build the code-CAD parts: meshes, mass properties and a manufacturability check.

Writes:
  description/meshes/<part>.stl   each part in its link's frame (m), for the URDF's visuals
  description/cad_model.yaml      per part: link, material, process, mass budget item, mass,
                                  centre of mass and inertia (link frame, SI), size (mm)
  description/cad_model_lite.yaml the same for the parts only Lite has: its wheeled base
                                  (cad/lite_base.py) and column head (cad/lite_column.py)

tools/build_urdf.py takes the CAD parts' masses and inertias in place of skeleton.yaml's
estimates for the budget items they cover (leg structure, feet, pelvis, torso), and shows their
meshes.

Checks that machined parts fit the desktop mill (MILL_MM: its usable area with the tool changer
fitted, which takes a strip off one side of the bed, so either of two areas, and the stock
thickness) and printed parts fit the printer (PRINT_MM); parts that don't are listed to be
split. Parts marked "service" (flat plates cut by an online laser or water-jet service) are not
size-checked.

Usage:
  python -m cad.build            # write meshes and cad_model.yaml, print the part table
  python -m cad.build --check    # exit 1 if cad_model.yaml is out of date (CI)

Needs: pip install -e ".[cad]"
"""

import argparse
import difflib
import sys
from pathlib import Path

import numpy as np
import trimesh
import yaml

from . import arm, covers, electrical, head, leg, lite_base, lite_column, torso

ROOT = Path(__file__).resolve().parent.parent
MESHES = ROOT / "description" / "meshes"
MODEL = ROOT / "description" / "cad_model.yaml"
MODEL_LITE = ROOT / "description" / "cad_model_lite.yaml"
# usable X, Y and stock thickness (mm) with the tool changer fitted, beside or behind the bed
MILL_MM = ((190.0, 210.0, 60.0), (240.0, 160.0, 60.0))
PRINT_MM = (250.0, 250.0, 250.0)
BUDGET = {
    "elec_": "electronics",  # first: electronics names also name their bay
    "foot": "feet",
    "pelvis": "pelvis",
    "torso": "torso",
    "shoulder": "arm_structure",
    "upper_arm": "arm_structure",
    "forearm": "arm_structure",
    "wrist": "arm_structure",
    "elbow": "arm_structure",
    "hand_mount": "arm_structure",
    "hand_arm": "arm_structure",
    "hand": "hands",
    "neck": "head",
    "head": "head",
}  # name keyword -> budget item; else legs


def budget_item(p) -> str:
    if p.link == "column_link":
        return "lite_column"
    if p.link == "lite_base" or p.link.startswith("wheel_"):
        return "lite_base"
    if p.process == "cover":
        return "covers"  # add-on, outside the mass budget and the default URDF
    return next((v for k, v in BUDGET.items() if k in p.name), "leg_structure")


def fits(size: np.ndarray, limit) -> bool:
    """Whether a part fits a box (or any of several boxes), in any orientation."""
    if isinstance(limit[0], tuple):
        return any(fits(size, one) for one in limit)
    return all(
        a <= b for a, b in zip(sorted(size, reverse=True), sorted(limit, reverse=True), strict=True)
    )


def r6(v, step: float) -> list[float]:
    """6 significant figures, with anything below `step` dropped: the round-off left in the
    near-zero terms (products of inertia, centred coordinates) differs between CPUs, and would
    make the --check fail on some CI runners"""
    return [float(f"{round(x / step) * step:.6g}") + 0.0 for x in np.ravel(v)]


def table(parts, meshes: dict, too_big: list) -> dict:
    model = {}
    for p in parts:
        mass, com, inertia = p.mass_properties()
        size = p.bounds()
        fit = p.extra.get("fit_mm", size)  # a part drawn turned is checked in its own frame
        limit = (
            MILL_MM if p.process == "cnc" else PRINT_MM if p.process in ("print", "cover") else None
        )
        if limit and not fits(fit, limit):
            too_big.append((p.name, p.process, fit))
        model[p.name] = dict(
            link=p.link,
            material=p.material,
            process=p.process,
            budget=budget_item(p),
            mass=round(float(mass), 5),
            com=r6(com, 1e-7),
            inertia=r6(inertia[[0, 1, 2, 0, 0, 1], [0, 1, 2, 1, 2, 2]], 1e-10),
            size_mm=[round(float(x), 1) for x in size],
        )
        v, f = p.mesh()
        meshes[p.name] = trimesh.Trimesh(v / 1000, f)
    return model


HEADER = (
    "# Generated by cad/build.py from the code-CAD parts in cad/. Do not edit.\n"
    "# Per part: mass (kg), centre of mass and inertia about it (ixx iyy izz ixy ixz iyz,\n"
    "# link frame, SI), size (mm), and the mass budget item it covers.\n"
)


def dump(model: dict) -> str:
    return HEADER + yaml.safe_dump(model, sort_keys=False, width=100, default_flow_style=None)


def build() -> tuple[str, str, dict, list]:
    parts = (
        leg.all_parts()
        + torso.parts()
        + arm.all_parts()
        + head.parts()
        + electrical.parts()
        + covers.all_parts()
    )
    meshes, too_big = {}, []
    text = dump(table(parts, meshes, too_big))
    lite = dump(table(lite_base.link_parts() + lite_column.parts(), meshes, too_big))
    return text, lite, meshes, too_big


def main() -> int:
    ap = argparse.ArgumentParser(description=__doc__.splitlines()[0])
    ap.add_argument("--check", action="store_true")
    args = ap.parse_args()
    text, lite, meshes, too_big = build()
    if args.check:
        for path, t in ((MODEL, text), (MODEL_LITE, lite)):
            if not path.exists() or path.read_text() != t:
                print(f"description/{path.name} is out of date: run python -m cad.build")
                old = path.read_text().splitlines() if path.exists() else []
                diff = difflib.unified_diff(old, t.splitlines(), "committed", "built", n=1)
                print("\n".join(list(diff)[:40]))
                return 1
        if too_big:
            print(f"parts too big for the mill or printer: {[n for n, _, _ in too_big]}")
            return 1
        print(
            "cad_model.yaml and cad_model_lite.yaml up to date; every part fits the mill or printer"
        )
        return 0
    MESHES.mkdir(parents=True, exist_ok=True)
    for old in MESHES.glob("*.stl"):
        old.unlink()
    for name, m in meshes.items():
        m.export(MESHES / f"{name}.stl")
    MODEL.write_text(text)
    MODEL_LITE.write_text(lite)
    model = yaml.safe_load(text) | yaml.safe_load(lite)
    by_item: dict[str, float] = {}
    print(f"{'part':28} {'process':7} {'material':8} {'mass g':>7} {'size mm':>18}")
    for name, p in model.items():
        by_item[p["budget"]] = by_item.get(p["budget"], 0.0) + p["mass"]
        s = p["size_mm"]
        size = f"{s[0]:5.0f} x{s[1]:4.0f} x{s[2]:4.0f}"
        print(f"{name:28} {p['process']:7} {p['material']:8} {p['mass'] * 1000:7.1f} {size}")
    print(
        "\nmass by budget item (both legs): "
        + ", ".join(f"{k} {v:.3f} kg" for k, v in by_item.items())
    )
    if too_big:
        print(
            "\ntoo big for the desktop mill or printer (split, or order from a machining service):"
        )
        for name, process, size in too_big:
            print(f"  {name:28} {process:5} {size[0]:.0f} x {size[1]:.0f} x {size[2]:.0f} mm")
    print(
        f"\nwrote {len(meshes)} meshes to {MESHES.relative_to(ROOT)} and {MODEL.relative_to(ROOT)}"
    )
    return 0


if __name__ == "__main__":
    sys.exit(main())
