kranthie/marvin-bot/sim/isaaclab/marvin_bot/robot_cfg.py

# Portions adapted from Isaac Lab (https://github.com/isaac-sim/IsaacLab), Copyright (c) 2022-2026,
# The Isaac Lab Project Developers, BSD-3-Clause (LICENSES/BSD-3-Clause-IsaacLab.txt). Modified for
# Marvin Bot; the rest Apache-2.0.
# SPDX-License-Identifier: Apache-2.0 AND BSD-3-Clause
"""Isaac Lab articulation config for Marvin Bot.

Isaac Lab 3.0 API. Everything joint-related comes from the description files: joint order and
default stance from description/robot.yaml, motor torque and speed from actuators.yaml, the
ankle linkage ratios from skeleton.yaml (as tools/build_urdf.py does for the URDF).
sim/isaaclab/convert_urdf.py turns description/urdf/marvin_bot.urdf into the USD loaded here.

Actuators are DC motor models: torque saturates at the motor's peak and falls linearly to zero
at its no-load speed. Each command reaches its motor 0-10 ms late (a random lag per episode),
for the inference time and the CAN round trip on the real robot. The two ankle joints, driven
by a pair of motors through a linkage, are modelled in joint space with the pair's combined
torque times the linkage ratio.

Gains, armature and friction are placeholders until the phase 2 bench test fits them. They
follow comparable open humanoids of this size (kp 100-150 on the 120 N·m hip and knee joints,
~40 on the ankles). sim/mujoco/check_standing.py uses stiffer gains because it holds a pose
with no balance controller.
"""

import math
from pathlib import Path

import isaaclab.sim as sim_utils
import torch
import yaml
from isaaclab.actuators import DCMotor, DCMotorCfg, ImplicitActuator, ImplicitActuatorCfg
from isaaclab.assets import ArticulationCfg
from isaaclab.utils import DelayBuffer, configclass
from isaaclab_newton.sim.schemas import NewtonArticulationCfg
from isaaclab_physx.sim.schemas import PhysxArticulationCfg, PhysxRigidBodyCfg

ROOT = Path(__file__).resolve().parents[3]
DESC = ROOT / "description"
URDF_PATH = DESC / "urdf" / "marvin_bot.urdf"
# USD converted from the URDF by convert_urdf.py (git-ignored); loading it needs no Isaac Sim
USD_DIR = Path(__file__).resolve().parents[1] / "usd"
USD_PATH = USD_DIR / "marvin_bot" / "marvin_bot" / "marvin_bot.usda"

_robot = yaml.safe_load((DESC / "robot.yaml").read_text())
_acts = yaml.safe_load((DESC / "actuators.yaml").read_text())
_linkage = yaml.safe_load((DESC / "skeleton.yaml").read_text())["ankle_linkage"]
SIDES = ("left", "right")


def _expand(name: str) -> list[str]:
    return [name.replace("{side}", s) for s in SIDES] if "{side}" in name else [name]


# Joint order of every policy and of the robot, on every physics backend (PhysX and Newton order
# joints differently by default): robot.yaml's order, left before right.
JOINT_ORDER = tuple(n for j in _robot["joints"] for n in _expand(j["name"]))
STANCE_DEG = _robot["stance"]
STANCE_PELVIS_Z = _robot["stance_pelvis_height"]

LEG_JOINTS = [
    ".*_hip_pitch",
    ".*_hip_roll",
    ".*_hip_yaw",
    ".*_knee",
    ".*_ankle_pitch",
    ".*_ankle_roll",
]
ARM_JOINTS = [
    ".*_shoulder_pitch",
    ".*_shoulder_roll",
    ".*_shoulder_yaw",
    ".*_elbow",
    ".*_wrist_yaw",
    ".*_wrist_pitch",
]
FEET = ".*_foot_link"

# IMU on the pelvis, as the MuJoCo model's site
IMU_BODY = "pelvis"
IMU_OFFSET = (0.0, 0.0, 0.06)

# (kp N·m/rad, kd N·m·s/rad, armature kg·m², friction N·m) per joint pattern. Placeholders.
GAINS = {
    ".*_hip_pitch": (150.0, 5.0, 0.03, 0.3),
    ".*_hip_roll": (150.0, 5.0, 0.03, 0.3),
    ".*_hip_yaw": (100.0, 3.3, 0.02, 0.2),
    ".*_knee": (150.0, 5.0, 0.03, 0.3),
    ".*_ankle_pitch": (40.0, 2.0, 0.02, 0.2),
    ".*_ankle_roll": (40.0, 2.0, 0.02, 0.2),
    "waist_yaw": (150.0, 5.0, 0.02, 0.2),
    ".*_shoulder_pitch": (40.0, 2.0, 0.02, 0.2),
    # RS10P (25:1): armature from RobStride's specification sheet, 0.00625 kg·m² at the output
    ".*_shoulder_roll": (40.0, 2.0, 0.00625, 0.2),
    ".*_shoulder_yaw": (30.0, 1.5, 0.00625, 0.1),
    ".*_elbow": (30.0, 1.5, 0.00625, 0.1),
    ".*_wrist_yaw": (15.0, 0.8, 0.005, 0.05),
    "neck_.*": (10.0, 0.5, 0.002, 0.02),
    ".*_wrist_pitch": (10.0, 0.5, 0.002, 0.02),
}


def joint_limits() -> dict[str, tuple[float, float]]:
    """(peak torque N·m, no-load speed rad/s) per joint, as in the URDF."""
    out = {}
    for m in _robot["motors"]:
        a = _acts[m["model"]]
        speed = a["no_load_speed_rpm"] * 2 * math.pi / 60
        for side in SIDES if "{side}" in m["name"] else (None,):
            drives = [d.replace("{side}", side) if side else d for d in m["drives"]]
            if len(drives) == 1:
                out[drives[0]] = (a["peak_torque"], speed)
            else:  # two motors through the ankle linkage
                for d in drives:
                    r = _linkage["pitch_ratio"] if d.endswith("pitch") else _linkage["roll_ratio"]
                    out[d] = (2 * a["peak_torque"] * r, speed / r)
    return out


def joint_rated() -> dict[str, float]:
    """Continuous (rated) torque per joint, N·m: the motor's, or for the linkage ankle the
    pair's times the linkage ratio, as joint_limits() does for peak torque."""
    out = {}
    for m in _robot["motors"]:
        a = _acts[m["model"]]
        for side in SIDES if "{side}" in m["name"] else (None,):
            drives = [d.replace("{side}", side) if side else d for d in m["drives"]]
            for d in drives:
                if len(drives) == 1:
                    out[d] = a["rated_torque"]
                else:
                    r = _linkage["pitch_ratio"] if d.endswith("pitch") else _linkage["roll_ratio"]
                    out[d] = 2 * a["rated_torque"] * r
    return out


class DelayedDCMotor(DCMotor):
    """DC motor model whose position target arrives a random number of physics steps late, as
    Isaac Lab's DelayedPDActuator does for its ideal PD motor."""

    def __init__(self, cfg, *args, **kwargs):
        super().__init__(cfg, *args, **kwargs)
        self._delays = [
            DelayBuffer(cfg.max_delay, self._num_envs, device=self._device) for _ in range(3)
        ]

    def reset(self, env_ids):
        super().reset(env_ids)
        if env_ids is None:
            env_ids = slice(None)
        n = len(range(self._num_envs)[env_ids]) if isinstance(env_ids, slice) else len(env_ids)
        lags = torch.randint(
            self.cfg.min_delay, self.cfg.max_delay + 1, (n,), dtype=torch.int, device=self._device
        )
        for buf in self._delays:
            buf.set_time_lag(lags, env_ids)
            buf.reset(env_ids)

    def compute(self, control_action, joint_pos, joint_vel):
        pos, vel, eff = self._delays
        control_action.joint_positions = pos.compute(control_action.joint_positions)
        control_action.joint_velocities = vel.compute(control_action.joint_velocities)
        control_action.joint_efforts = eff.compute(control_action.joint_efforts)
        return super().compute(control_action, joint_pos, joint_vel)


@configclass
class DelayedDCMotorCfg(DCMotorCfg):
    class_type: type = DelayedDCMotor
    min_delay: int = 0  # physics steps
    max_delay: int = 2  # 10 ms at the 5 ms physics step


def _actuators(order=JOINT_ORDER) -> dict[str, DelayedDCMotorCfg]:
    import re

    limits = joint_limits()
    out = {}
    for pattern, (kp, kd, armature, friction) in GAINS.items():
        joints = [j for j in order if re.fullmatch(pattern, j)]
        if not joints:  # a variant without these joints
            continue
        torques = {limits[j] for j in joints}
        if len(torques) != 1:
            raise ValueError(f"{pattern}: joints with different motors {torques}")
        torque, speed = torques.pop()
        out[pattern.replace(".*", "").strip("_") or pattern] = DelayedDCMotorCfg(
            joint_names_expr=[pattern],
            saturation_effort=torque,
            actuator_effort_limit=torque,
            actuator_velocity_limit=speed,
            joint_effort_limit=torque,
            joint_velocity_limit=speed,
            stiffness=kp,
            damping=kd,
            armature=armature,
            friction=friction,
        )
    return out


def _stance() -> dict[str, float]:
    out = {}
    for j in JOINT_ORDER:
        key = j.split("_", 1)[1] if j.startswith(SIDES) else j
        if key in STANCE_DEG:
            out[j] = math.radians(STANCE_DEG[key])
    return out


MARVIN_BOT_CFG = ArticulationCfg(
    spawn=sim_utils.UsdFileCfg(
        usd_path=str(USD_PATH),
        activate_contact_sensors=True,
        rigid_props=PhysxRigidBodyCfg(max_depenetration_velocity=1.0),
        articulation_props=[
            # self-collision on: with it off, policies in earlier experiments learned to pass their
            # legs through each other when turning
            PhysxArticulationCfg(
                enabled_self_collisions=True,
                solver_position_iteration_count=8,
                solver_velocity_iteration_count=4,
            ),
            NewtonArticulationCfg(self_collision_enabled=True),
        ],
    ),
    init_state=ArticulationCfg.InitialStateCfg(
        pos=(0.0, 0.0, STANCE_PELVIS_Z + 0.01),
        joint_pos=_stance(),  # every other joint at 0
        joint_vel={".*": 0.0},
    ),
    joint_ordering=JOINT_ORDER,
    soft_joint_pos_limit_factor=0.95,
    actuators=_actuators(),
)


# --- Lite (robot.yaml variants.lite): the upper body on a column on a wheeled base. For training
# its base is fixed to the world (convert_urdf.py --variant lite): the wheels are left passive,
# and sim/mujoco/check_lite.py covers the base on its rollers. check_robot.py --variant lite
# checks it.
_lite = _robot["variants"]["lite"]
URDF_LITE_PATH = DESC / "urdf" / "marvin_bot_lite.urdf"
USD_LITE_PATH = USD_DIR / "marvin_bot_lite" / "marvin_bot_lite" / "marvin_bot_lite.usda"
_LITE_KEEP = ("waist_yaw", "neck_", "left_shoulder", "right_shoulder", "left_elbow", "right_elbow")
_LITE_KEEP += ("left_wrist", "right_wrist")
LITE_ARM_JOINTS = tuple(j for j in JOINT_ORDER if j.startswith(_LITE_KEEP))
LITE_JOINT_ORDER = ("column_lift", *LITE_ARM_JOINTS) + tuple(
    j["name"] for j in _lite["joints"] if j["name"].startswith("wheel_")
)


class Spindle(ImplicitActuator):
    """A self-locking spindle at its rated speed: an implicit position drive whose target moves
    toward the command at no more than `speed` (m/s). The drive's own velocity limit does not
    bind on every backend, and without this the stiff drive moves the column many times faster
    than its motor can (0.8 m/s against the DL6's 0.038)."""

    def __init__(self, cfg, *args, **kwargs):
        super().__init__(cfg, *args, **kwargs)
        self._pos = None

    def reset(self, env_ids):
        super().reset(env_ids)
        if self._pos is not None:
            self._pos[env_ids if env_ids is not None else slice(None)] = float("nan")

    def compute(self, control_action, joint_pos, joint_vel):
        if self._pos is None:
            self._pos = joint_pos.clone()
        self._pos = torch.where(torch.isnan(self._pos), joint_pos, self._pos)
        step = self.cfg.speed * self.cfg.dt
        self._pos = self._pos + torch.clamp(control_action.joint_positions - self._pos, -step, step)
        control_action.joint_positions = self._pos.clone()
        return super().compute(control_action, joint_pos, joint_vel)


@configclass
class SpindleCfg(ImplicitActuatorCfg):
    class_type: type = Spindle
    speed: float = 0.038  # m/s
    dt: float = 1 / 120  # s: the physics step it runs at (the reach task's)


def _lite_actuators() -> dict:
    col = _acts["DL6"]
    wheel = _acts["RS00"]
    out = _actuators(LITE_ARM_JOINTS)
    # the column: a stiff, self-locking spindle at the DL6's force and speed (the gains of
    # sim/mujoco/check_lite.py: under 1 mm of sag under the upper body)
    out["column"] = SpindleCfg(
        joint_names_expr=["column_lift"],
        speed=col["speed"],
        effort_limit_sim=col["peak_force"],
        velocity_limit_sim=col["speed"],
        stiffness=2.0e5,
        damping=4.0e3,
    )
    out["wheels"] = ImplicitActuatorCfg(
        joint_names_expr=["wheel_.*"],
        effort_limit_sim=wheel["peak_torque"],
        velocity_limit_sim=wheel["no_load_speed_rpm"] * 2 * math.pi / 60,
        stiffness=0.0,
        damping=0.5,
    )
    return out


def _lite_stance() -> dict[str, float]:
    out = {j: v for j, v in _stance().items() if j in LITE_ARM_JOINTS}
    out["column_lift"] = _lite["stance"]["column_lift"]
    return out


MARVIN_LITE_CFG = ArticulationCfg(
    spawn=sim_utils.UsdFileCfg(
        usd_path=str(USD_LITE_PATH),
        activate_contact_sensors=False,
        articulation_props=[
            PhysxArticulationCfg(
                enabled_self_collisions=True,
                solver_position_iteration_count=8,
                solver_velocity_iteration_count=4,
            ),
            NewtonArticulationCfg(self_collision_enabled=True),
        ],
    ),
    init_state=ArticulationCfg.InitialStateCfg(
        pos=(0.0, 0.0, 0.0), joint_pos=_lite_stance(), joint_vel={".*": 0.0}
    ),
    joint_ordering=LITE_JOINT_ORDER,
    soft_joint_pos_limit_factor=0.95,
    actuators=_lite_actuators(),
)
