kranthie/marvin-bot/tools/build_urdf.py

"""Build the robot's URDF from the description YAML files.

Reads description/robot.yaml (joints, ranges, motors), actuators.yaml (torque, speed, mass,
size), mass_budget.yaml (non-motor masses) and skeleton.yaml (frames, where masses sit,
collision boxes), mirrors the left side to the right, and writes
description/urdf/marvin_bot.urdf.

Model:
- each link's inertia combines its structure boxes (skeleton.yaml "bodies") and the motor
  housings mounted on it, as solid cylinders along the joint axis;
- joint effort and velocity limits are the motor's peak torque and no-load speed; the two
  ankle joints, driven by a pair of motors through a linkage, get the pair's combined torque
  times the linkage ratios in skeleton.yaml;
- the code-CAD parts (description/cad_model.yaml, from cad/build.py) replace skeleton.yaml's
  estimate boxes for the budget items they cover, with their computed masses and inertias and
  their meshes as visuals;
- collision geometry is the skeleton's boxes; visuals are the remaining estimate boxes (except
  the fasteners and limb harness, spread through their links), the CAD meshes and the motor
  housings;
- the clip-on covers (cad/covers.py, an optional add-on) go only into a second URDF,
  marvin_bot_covers.urdf, with their masses; the default model is the bare robot;
- Lite (robot.yaml variants.lite) keeps Max's links from the waist joint up and adds its base,
  column and wheel links (skeleton.yaml variants.lite) with their CAD parts
  (cad_model_lite.yaml): marvin_bot_lite.urdf and marvin_bot_lite_covers.urdf. Its base is the
  floating root; the omni wheels' rollers are not in the URDF (the simulations add them).

Usage:
  python tools/build_urdf.py           # write the URDF and print the mass summary
  python tools/build_urdf.py --check   # exit 1 if either URDF is out of date (used by CI)
"""

import argparse
import math
import sys
import xml.etree.ElementTree as ET
from pathlib import Path

import yaml

ROOT = Path(__file__).resolve().parent.parent
DESC = ROOT / "description"
URDF_OUT = DESC / "urdf" / "marvin_bot.urdf"
URDF_COVERS = DESC / "urdf" / "marvin_bot_covers.urdf"  # with the clip-on covers
URDF_LITE = DESC / "urdf" / "marvin_bot_lite.urdf"
URDF_LITE_COVERS = DESC / "urdf" / "marvin_bot_lite_covers.urdf"
CAD_MODEL = DESC / "cad_model.yaml"  # written by cad/build.py
CAD_MODEL_LITE = DESC / "cad_model_lite.yaml"
SIDES = ("left", "right")
DEFAULT_ENVELOPE_MM = [80, 80, 50]  # for actuators without a measured envelope yet
MOTOR_COLOURS = {
    "RS04": "0.85 0.33 0.31 1",
    "RS03": "0.23 0.49 0.85 1",
    "RS06": "0.23 0.65 0.33 1",
    "RS10P": "0.18 0.66 0.70 1",
    "RS00": "0.56 0.36 0.82 1",
    "STS3250": "0.88 0.66 0.0 1",
}
BODY_COLOUR = "0.19 0.20 0.23 1"
# budget items spread through their links (a box per link for the mass and inertia), not drawn
NOT_DRAWN = {"fasteners", "limb_harness"}
CAD_COLOURS = {  # machined aluminium, printed shells and soles, bought hardware
    "cnc": "0.72 0.74 0.77 1",
    "service": "0.72 0.74 0.77 1",
    "print": "0.17 0.18 0.20 1",
    "bought": "0.45 0.45 0.47 1",
    "cover": "0.88 0.89 0.91 1",
}
TOL = 1e-6


# ---------------------------------------------------------------------------------- helpers


def mirror_name(name: str) -> str:
    return "right_" + name[len("left_") :] if name.startswith("left_") else name


def mirror_xyz(v: list[float]) -> list[float]:
    return [v[0], -v[1], v[2]]


def mirror_axis(a: list[float]) -> list[float]:
    """Pitch axes (y) stay; roll (x) and yaw (z) axes flip, so ranges keep their meaning."""
    return [-a[0], a[1], -a[2]]


def fmt(v) -> str:
    return " ".join(f"{x:.6g}" for x in v)


def mat_add(a, b):
    return [[a[i][j] + b[i][j] for j in range(3)] for i in range(3)]


def scale(a, s):
    return [[a[i][j] * s for j in range(3)] for i in range(3)]


def eye():
    return [[1.0 if i == j else 0.0 for j in range(3)] for i in range(3)]


def outer(u, v):
    return [[u[i] * v[j] for j in range(3)] for i in range(3)]


def box_inertia(m: float, size: list[float]):
    x, y, z = size
    return [
        [m * (y * y + z * z) / 12, 0, 0],
        [0, m * (x * x + z * z) / 12, 0],
        [0, 0, m * (x * x + y * y) / 12],
    ]


def cylinder_inertia(m: float, diameter: float, height: float, axis: list[float]):
    r = diameter / 2
    i_axis = m * r * r / 2
    i_perp = m * (3 * r * r + height * height) / 12
    n = math.sqrt(sum(a * a for a in axis))
    a = [x / n for x in axis]
    return mat_add(scale(eye(), i_perp), scale(outer(a, a), i_axis - i_perp))


def combine(parts):
    """Mass, centre of mass and inertia about it of (mass, com, inertia-about-own-com) parts."""
    m = sum(p[0] for p in parts)
    com = [sum(p[0] * p[1][k] for p in parts) / m for k in range(3)]
    inertia = [[0.0] * 3 for _ in range(3)]
    for pm, pc, pi in parts:
        d = [pc[k] - com[k] for k in range(3)]
        dd = sum(x * x for x in d)
        inertia = mat_add(
            inertia, mat_add(pi, scale(mat_add(scale(eye(), dd), scale(outer(d, d), -1)), pm))
        )
    return m, com, inertia


# ------------------------------------------------------------------------------ the model


def expand(entries: list[dict]) -> list[dict]:
    """robot.yaml entries with "{side}" become a left and a right copy."""
    out = []
    for e in entries:
        sides = SIDES if any("{side}" in str(v) for v in e.values()) else (None,)
        for side in sides:

            def sub(v, side=side):
                if isinstance(v, str):
                    return v.replace("{side}", side) if side else v
                if isinstance(v, list):
                    return [sub(x) for x in v]
                return v

            out.append({k: sub(v) for k, v in e.items()})
    return out


def mirrored(items: dict | list, key_is_name: bool):
    """Add right-side copies of left-side skeleton entries."""
    if key_is_name:
        out = dict(items)
        for name, e in items.items():
            if name.startswith("left_"):
                r = dict(e)
                for k in ("parent", "child", "link"):
                    if k in r:
                        r[k] = mirror_name(r[k])
                r["xyz"] = mirror_xyz(e["xyz"])
                if "axis" in r:
                    r["axis"] = mirror_axis(e["axis"])
                out[mirror_name(name)] = r
        return out
    out = list(items)
    for e in items:
        if e["link"].startswith("left_"):
            out.append({**e, "link": mirror_name(e["link"]), "xyz": mirror_xyz(e["xyz"])})
    return out


def motor_placements(variant: str | None = None) -> list[dict]:
    """Every motor housing: name, model, the link carrying it, centre and axis in that link's
    frame, envelope (diameter, -, thickness in m), and the joints it drives.

    A housing sits on the parent link of the (first) joint it drives, centred on the joint origin
    along the joint axis, unless skeleton.yaml's motor_mounts moves it (``xyz``, and ``axis``
    if it is not the joint axis; the ankle motors default to a y axis)."""
    robot = yaml.safe_load((DESC / "robot.yaml").read_text())
    acts = yaml.safe_load((DESC / "actuators.yaml").read_text())
    skel = yaml.safe_load((DESC / "skeleton.yaml").read_text())
    joints = mirrored(skel["joints"], key_is_name=True)
    mounts = mirrored(skel["motor_mounts"], key_is_name=True)
    motors = expand(robot["motors"])
    if variant:
        joints = variant_joints(robot, skel, variant)
        mounts |= skel["variants"][variant].get("motor_mounts", {})
        motors = [m for m in motors if all(d in joints for d in m["drives"])]
    out = []
    for m in motors:
        a = acts[m["model"]]
        env = [x / 1000 for x in (a.get("envelope_mm") or DEFAULT_ENVELOPE_MM)]
        j = joints[m["drives"][0]]
        mount = mounts.get(m["name"])
        if mount:
            link, xyz = mount["link"], mount["xyz"]
            axis = mount.get("axis", j["axis"] if len(m["drives"]) == 1 else [0, 1, 0])
        else:
            link, xyz, axis = j["parent"], j["xyz"], j["axis"]
        right = m["name"].startswith("right_")
        out.append(
            dict(
                name=m["name"],
                model=m["model"],
                link=link,
                xyz=xyz,
                axis=axis,
                envelope=env,
                drives=m["drives"],
                output=mirror_xyz(m["output"]) if right else m.get("output", axis),
                length=(mirror_xyz(m["length"]) if right else m["length"])
                if "length" in m
                else None,
                shape=a.get("shape"),
            )
        )
    return out


def variant_joints(robot: dict, skel: dict, variant: str) -> dict:
    """A variant's joints (skeleton.yaml form): Max's from its keep_from joint's child down,
    then the variant's own, which replace any of the same name."""
    joints = mirrored(skel["joints"], key_is_name=True)
    v = robot["variants"][variant]
    keep = {joints[v["keep_from"]]["child"]}
    grew = True
    while grew:
        grew = False
        for j in joints.values():
            if j["parent"] in keep and j["child"] not in keep:
                keep.add(j["child"])
                grew = True
    out = {n: j for n, j in joints.items() if j["parent"] in keep}
    out |= skel["variants"][variant]["joints"]
    return out


def motor_primitives(m: dict) -> list[dict]:
    """The housing of a placed motor as simple solids in its link's frame (m): for a RobStride,
    the body cylinder (output face on the output side) and the smaller driver cap behind it;
    for a servo, its case box, offset from the shaft. Each: kind "cylinder" (centre, axis, d,
    length) or "box" (centre, size along x, y, z)."""
    env, xyz = m["envelope"], [float(v) for v in m["xyz"]]
    o = [float(v) for v in m["output"]]
    sh = m.get("shape") or {}
    if "box" in sh:
        ln = [float(v) for v in m["length"]]
        lo, hi = sh["axial"][0] / 1000, sh["axial"][1] / 1000
        along = (lo + hi) / 2
        off = sh["shaft_offset"] / 1000
        centre = [xyz[i] + o[i] * along + ln[i] * off for i in range(3)]
        width = [1.0 - abs(o[i]) - abs(ln[i]) for i in range(3)]
        size = [
            abs(o[i]) * (hi - lo)
            + abs(ln[i]) * sh["box"][0] / 1000
            + width[i] * sh["box"][1] / 1000
            for i in range(3)
        ]
        return [dict(kind="box", centre=centre, size=size)]
    t = env[2]
    if not sh or not sh.get("cap_d"):
        return [dict(kind="cylinder", centre=xyz, axis=o, d=env[0], length=t)]
    cap = sh["cap_len"] / 1000
    body = t - cap
    return [
        dict(
            kind="cylinder",
            centre=[xyz[i] + o[i] * (t / 2 - body / 2) for i in range(3)],
            axis=o,
            d=sh["body_d"] / 1000,
            length=body,
        ),
        dict(
            kind="cylinder",
            centre=[xyz[i] - o[i] * (t / 2 - cap / 2) for i in range(3)],
            axis=o,
            d=sh["cap_d"] / 1000,
            length=cap,
        ),
    ]


def build(covers: bool = False, variant: str | None = None) -> tuple[str, dict]:
    robot = yaml.safe_load((DESC / "robot.yaml").read_text())
    acts = yaml.safe_load((DESC / "actuators.yaml").read_text())
    budget = yaml.safe_load((DESC / "mass_budget.yaml").read_text())["items"]
    skel = yaml.safe_load((DESC / "skeleton.yaml").read_text())

    ranges = {j["name"]: j["range"] for j in expand(robot["joints"])}
    kinds: dict[str, str] = {}
    joints = mirrored(skel["joints"], key_is_name=True)
    cad = yaml.safe_load(CAD_MODEL.read_text()) if CAD_MODEL.exists() else {}
    if not covers:
        cad = {k: v for k, v in cad.items() if v["budget"] != "covers"}
    cad_items = {p["budget"] for p in cad.values()}
    bodies = [
        b for b in mirrored(skel["bodies"], key_is_name=False) if b["budget"] not in cad_items
    ]
    collisions = mirrored(skel["collisions"], key_is_name=False)
    root = "pelvis"
    errors = []
    if variant:
        v = robot["variants"][variant]
        joints = variant_joints(robot, skel, variant)
        kept = {j["child"] for j in joints.values()} | {j["parent"] for j in joints.values()}
        root = next(iter(kept - {j["child"] for j in joints.values()}))
        for e in v["joints"]:
            kinds[e["name"]] = e["type"]
            if "range" in e:
                ranges[e["name"]] = e["range"]
        ranges = {n: r for n, r in ranges.items() if n in joints}
        drop = set(v.get("drop_budget", []))
        bodies = [b for b in bodies if b["link"] in kept and b["budget"] not in drop]
        collisions = [c for c in collisions if c["link"] in kept]
        collisions += skel["variants"][variant].get("collisions", [])
        cad = {k: c for k, c in cad.items() if c["link"] in kept}
        lite = yaml.safe_load(CAD_MODEL_LITE.read_text()) if CAD_MODEL_LITE.exists() else {}
        cad |= {k: c for k, c in lite.items() if covers or c["process"] != "cover"}

    # skeleton lengths must match robot.yaml (Max; a variant keeps Max's arms)
    dims = robot["dimensions"]
    z = {n: -j["xyz"][2] for n, j in mirrored(skel["joints"], key_is_name=True).items()}
    checks = {
        "thigh": z["left_hip_roll"] + z["left_hip_yaw"] + z["left_knee"],
        "shin": z["left_ankle_pitch"],
        "upper_arm": z["left_shoulder_yaw"] + z["left_elbow"],
        "forearm": z["left_wrist_yaw"] + z["left_wrist_pitch"],
        "shoulder_height": dims["hip_axis_height"] - z["waist_yaw"] - z["left_shoulder_pitch"],
    }
    for k, v in checks.items():
        if abs(v - dims[k]) > 1e-6:
            errors.append(f"skeleton gives {k} = {v:.3f} m, robot.yaml says {dims[k]:.3f} m")
    if set(joints) != set(ranges) | {n for n, k in kinds.items() if k == "continuous"}:
        errors.append(f"joints differ: {sorted(set(joints) ^ set(ranges))}")

    # every budget item fully placed (Max; a variant drops some and adds its CAD)
    placed: dict[str, float] = {}
    for b in [*bodies, *cad.values()]:
        placed[b["budget"]] = placed.get(b["budget"], 0.0) + b["mass"]
    for k, v in budget.items() if not variant else ():
        if abs(placed.get(k, 0.0) - v["mass"]) > 5e-4:  # half a gram: budgets are rounded
            errors.append(
                f"budget {k}: {v['mass']} kg, skeleton places {placed.get(k, 0.0):.3f} kg"
            )

    links: dict[str, list] = {root: []}
    for j in joints.values():
        links.setdefault(j["parent"], [])
        links.setdefault(j["child"], [])
    visuals: dict[str, list[str]] = {n: [] for n in links}
    for b in bodies:
        links[b["link"]].append((b["mass"], b["xyz"], box_inertia(b["mass"], b["size"])))
        if b["budget"] in NOT_DRAWN:
            continue
        visuals[b["link"]].append(
            f'<visual><origin xyz="{fmt(b["xyz"])}"/><geometry><box size="{fmt(b["size"])}"/>'
            f'</geometry><material name="body"><color rgba="{BODY_COLOUR}"/></material></visual>'
        )

    for name, c in cad.items():
        i = c["inertia"]  # ixx iyy izz ixy ixz iyz
        inertia = [[i[0], i[3], i[4]], [i[3], i[1], i[5]], [i[4], i[5], i[2]]]
        links[c["link"]].append((c["mass"], c["com"], inertia))
        visuals[c["link"]].append(
            f'<visual><geometry><mesh filename="../meshes/{name}.stl"/></geometry>'
            f'<material name="{c["material"]}"><color rgba="{CAD_COLOURS[c["process"]]}"/>'
            "</material></visual>"
        )

    # motors: mass on the parent link of the (first) joint they drive
    effort: dict[str, float] = {}
    velocity: dict[str, float] = {}
    pairs: dict[tuple, list] = {}
    for m in motor_placements(variant):
        a = acts[m["model"]]
        env, link, xyz, axis = m["envelope"], m["link"], m["xyz"], m["axis"]
        mass = a["mass"]
        links[link].append((mass, xyz, cylinder_inertia(mass, env[0], env[2], axis)))
        for p in motor_primitives(m):
            if p["kind"] == "box":
                geom = f'<box size="{fmt(p["size"])}"/>'
                rpy = "0 0 0"
            else:
                ax = p["axis"]
                rpy = (
                    "1.5708 0 0"
                    if abs(ax[1]) > 0.5
                    else ("0 1.5708 0" if abs(ax[0]) > 0.5 else "0 0 0")
                )
                geom = f'<cylinder radius="{p["d"] / 2:.6g}" length="{p["length"]:.6g}"/>'
            visuals[link].append(
                f'<visual><origin xyz="{fmt(p["centre"])}" rpy="{rpy}"/><geometry>{geom}</geometry>'
                f'<material name="{m["model"]}"><color rgba="{MOTOR_COLOURS[m["model"]]}"/>'
                "</material></visual>"
            )
        speed = a["no_load_speed_rpm"] * 2 * math.pi / 60
        if len(m["drives"]) == 1:
            effort[m["drives"][0]] = a["peak_torque"]
            velocity[m["drives"][0]] = speed
        else:
            pairs.setdefault(tuple(m["drives"]), []).append((a["peak_torque"], speed))
    for m in robot["variants"][variant]["motors"] if variant else ():
        a = acts[m["model"]]
        (j,) = m["drives"]
        if a.get("kind") == "linear":
            effort[j], velocity[j] = a["peak_force"], a["speed"]
        else:
            effort[j], velocity[j] = a["peak_torque"], a["no_load_speed_rpm"] * 2 * math.pi / 60
    ratios = skel["ankle_linkage"]
    for (pitch, roll), ms in pairs.items():
        torque = sum(t for t, _ in ms)
        speed = min(s for _, s in ms)
        effort[pitch] = torque * ratios["pitch_ratio"]
        effort[roll] = torque * ratios["roll_ratio"]
        velocity[pitch] = speed / ratios["pitch_ratio"]
        velocity[roll] = speed / ratios["roll_ratio"]

    if errors:
        for e in errors:
            print(f"ERROR: {e}")
        sys.exit(1)

    # write
    name = robot["robot"]["name"] + (f"_{variant}" if variant else "")
    out = [f'<robot name="{name}">']
    summary = {}
    for name, parts in links.items():
        if not parts:
            parts = [(0.01, [0.0, 0.0, 0.0], box_inertia(0.01, [0.02, 0.02, 0.02]))]
        m, com, i = combine(parts)
        summary[name] = m
        out.append(f'  <link name="{name}">')
        out.append(
            f'    <inertial><origin xyz="{fmt(com)}"/><mass value="{m:.6g}"/>'
            f'<inertia ixx="{i[0][0]:.6g}" ixy="{i[0][1]:.6g}" ixz="{i[0][2]:.6g}" '
            f'iyy="{i[1][1]:.6g}" iyz="{i[1][2]:.6g}" izz="{i[2][2]:.6g}"/></inertial>'
        )
        out += [f"    {v}" for v in visuals[name]]
        for c in collisions:
            if c["link"] == name:
                out.append(
                    f'    <collision><origin xyz="{fmt(c["xyz"])}"/><geometry>'
                    f'<box size="{fmt(c["size"])}"/></geometry></collision>'
                )
        out.append("  </link>")
    for name, j in joints.items():
        kind = kinds.get(name, "revolute")
        rpy = f' rpy="{fmt(j["rpy"])}"' if "rpy" in j else ""
        if kind == "continuous":
            limit = f'<limit effort="{effort[name]:.6g}" velocity="{velocity[name]:.6g}"/>'
        else:
            lo, hi = ranges[name] if kind == "prismatic" else map(math.radians, ranges[name])
            limit = (
                f'<limit lower="{lo:.6g}" upper="{hi:.6g}" effort="{effort[name]:.6g}" '
                f'velocity="{velocity[name]:.6g}"/>'
            )
        out += [
            f'  <joint name="{name}" type="{kind}">',
            f'    <parent link="{j["parent"]}"/><child link="{j["child"]}"/>',
            f'    <origin xyz="{fmt(j["xyz"])}"{rpy}/><axis xyz="{fmt(j["axis"])}"/>',
            f"    {limit}",
            "  </joint>",
        ]
    out.append("</robot>")
    header = (
        "<?xml version='1.0' encoding='utf-8'?>\n"
        "<!-- Generated by tools/build_urdf.py from description/*.yaml. Do not edit. -->\n"
    )
    ET.fromstring("\n".join(out))  # well-formed
    return header + "\n".join(out) + "\n", summary


def main() -> int:
    ap = argparse.ArgumentParser(description=__doc__.splitlines()[0])
    ap.add_argument("--check", action="store_true", help="fail if the URDF is out of date")
    args = ap.parse_args()
    outputs = [
        (URDF_OUT, *build()),
        (URDF_COVERS, *build(covers=True)),
        (URDF_LITE, *build(variant="lite")),
        (URDF_LITE_COVERS, *build(covers=True, variant="lite")),
    ]
    if args.check:
        for path, text, _ in outputs:
            if not path.exists() or path.read_text() != text:
                print(f"{path.relative_to(ROOT)} is out of date: run python tools/build_urdf.py")
                return 1
        print("URDFs up to date")
        return 0
    URDF_OUT.parent.mkdir(parents=True, exist_ok=True)
    for path, text, summary in outputs:
        path.write_text(text)
        print(
            f"wrote {path.relative_to(ROOT)}: {len(summary)} links, {sum(summary.values()):.2f} kg"
        )
    return 0


if __name__ == "__main__":
    sys.exit(main())
