kranthie/marvin-bot/(commit log)

2026-10-26 Project skeleton, licences and acknowledgements
    Apache-2.0 for software and docs, CERN-OHL-S-2.0 for hardware designs.
    README with goals and design summary, contribution rules (single source
    of truth, no vendor CAD, credit sources), and acknowledgements.
2026-10-26 Plan, requirements, roadmap and safety rules
    Staged build (simulation, actuator bench, one leg, lower body, upper
    body, perception) with a pass check per phase, the requirements that
    gate the design, the open items to verify before ordering, and the
    first version of the safety rules.
2026-10-26 Concept v0.1: joints, actuators, CAN map, mass budget and decisions
    description/robot.yaml is the single source of truth: 25 powered joints,
    Robstride RS04/RS03/RS06/RS00 plus serial-bus servos for neck and
    grippers, two-motor ankles, and six motor CAN buses plus a battery bus.
    actuators.yaml takes figures from RobStride's manuals; mass_budget.yaml
    holds the non-motor estimates (37.5 kg total against a 35 kg target).
    The decision log records the reasons and alternatives, and the concept
    drawing is generated by tools/sketch_concept.py.
    [robot.yaml]
2026-10-26 Preliminary bill of materials
    bom/bom.csv lists every part with quantity, price and its basis, the
    phase it is bought in and its status; tools/bom_summary.py prints totals
    by phase and group (about $12.3k at US reseller prices, before a direct
    actuator quote).
    [bom.csv]
2026-10-26 CI: lint, description consistency and BOM checks
    tools/check_description.py checks that every joint is driven by one
    motor or a linkage pair, that motor models and buses exist, that CAN
    load stays within limits, that the mass is under the hard limit, and
    that the BOM lists the motors robot.yaml uses. CI runs it with ruff and
    the BOM summary.
2026-10-26 Format the concept sketch tool and make its SVG reproducible
    Fixed SVG element ids and no timestamp, so re-rendering gives an
    identical file.
    [sketch_concept.py]
2026-10-26 Correct reference links, licences and the RS06 rationale
    Asimov 1 moved to menloresearch/asimov-1. Roboto Origin's licences are
    per module (CERN-OHL-W hardware, BSD-3 training, GPL-3 onboard code).
    The RS06 decision now cites the reference robots' actual arm torques.
2026-10-26 Concept v0.2: shorter legs, RS06 ankles, ranges checked against references
    Compared with Asimov 1 and Roboto Origin: hip axis to sole 0.69 -> 0.65 m
    (height 1.215 m), two RS06 per ankle instead of RS03 (-1.1 kg), hip yaw
    stays RS03, hip extension and ankle plantarflexion ranges adjusted. Mass
    estimate 36.2 kg. BOM, plan, concept and README updated; the sketch now
    takes leg heights and the ankle motor from robot.yaml. Phase 0 done.
    [bom.csv, robot.yaml]
2026-10-26 Phase 1: URDF from the description files and a MuJoCo standing check
    description/skeleton.yaml places the link frames, structure masses and
    collision boxes; tools/build_urdf.py combines it with robot.yaml,
    actuators.yaml and mass_budget.yaml into description/urdf/marvin_bot.urdf
    (36.2 kg, ankle limits from the two-motor linkage), checking that the
    skeleton matches the robot.yaml lengths and places every budget item.
    sim/mujoco/check_standing.py holds a crouch and a straight pose: both stay
    up, worst holding torque is the knee at 40% of the RS04 rating. CI now
    checks the URDF is current and runs both poses.
    [marvin_bot.urdf]
2026-10-26 Model: add a wrist bracket so the gripper connects to the forearm
    Moves 50 g of the arm structure from each forearm to its wrist link; the
    mass budget and standing check are unchanged.
    [marvin_bot.urdf]
2026-10-26 Static step-up check; ankle dorsiflexion 40° for 17-20 cm stairs
    sim/mujoco/check_step_up.py (ported from an earlier prototype, with sideways
    weight shift on one foot and a rising rear heel) shows 35° of ankle
    dorsiflexion cannot climb 17 cm at any leg length; 38° climbs 20 cm at
    0.62-0.69 m hip height. Ankle pitch range is now -40/+40°, hip height
    stays 0.65 m. CI runs the 18 cm case.
    [marvin_bot.urdf, robot.yaml]
2026-10-26 Ankle linkage design tool; ankles back to RS03
    tools/ankle_linkage.py solves the two-crank, two-rod ankle over the full
    pitch and roll range and searches its geometry. Best: 45 mm cranks,
    ~188 mm rods 45 mm behind and 25 mm beside the ankle axis, ratios 1.02
    pitch / 0.56 roll. With RS06 the ankle would give only 11 N·m of
    continuous roll against ~14 needed on one foot, so the ankles return to
    RS03 (mass estimate 37.3 kg). URDF limits use the computed ratios; CI
    checks they match the geometry.
    [bom.csv, marvin_bot.urdf, robot.yaml]
2026-10-26 Isaac Lab package, robot check and policy cross-check
    sim/isaaclab/marvin_bot: articulation config built from the description
    files (DC motor models, ankle linkage ratios, robot.yaml joint order and
    default stance), MarvinBot-Velocity-Flat and -Rough tasks ported from
    an earlier prototype and scaled (household stairs to 20 cm, 8 cm clearance,
    0.35 m fall height), converter, robot check and policy export. The robot
    check passes on Newton and PhysX (mass, limits, kinematics within
    0.24 mm of MuJoCo, stance holds). sim/mujoco/check_symmetry.py checks the
    training mirror rule exactly; check_policy.py runs exported policies in
    MuJoCo. robot.yaml gains the default stance.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
    [robot.yaml]
2026-10-26 Phase 2 prep: Robstride CAN driver and bench scripts
    robot/drivers/robstride.py implements the motors' private protocol from
    RobStride's official manuals (operation control, feedback, enable/stop,
    zero, parameter read/write; per-model scaling for RS00/RS03/RS04/RS06),
    with unit tests for the frame encoding run in CI. bench/ adds the phase 2
    procedure and a bench script (scan, latency, step, thermal), untested
    until the actuators arrive.
2026-10-26 Ankle layout from real actuator envelopes; vendor CAD fetch script
    tools/fetch_vendor_cad.py downloads RobStride's STEP models, pinned to a
    commit, into the git-ignored cad/vendor/. Their envelopes (RS03 is
    100 mm across, not 106) replace the reseller figures. The two ankle
    RS03 now sit side by side 64 mm apart and 125 mm below the knee with
    cranks on their outer faces; the linkage search gives 65 mm cranks and
    rods +-55 mm aside (ratios 0.86 pitch / 0.83 roll, 31/26 N·m rated at
    the worst pose, rod force under 1.3 kN). Foot 110 mm wide. All checks
    pass.
    [marvin_bot.urdf, robot.yaml]
2026-10-26 Packaging check; thigh layout, knee 125° and motor positions fixed
    tools/check_packaging.py places every motor at its STEP-model size and
    every collision box on its link and checks overlaps across the joint
    ranges and in combined poses (errors within a limb, warnings between
    limbs). Fixes: hip roll RS04 behind the hip pitch RS04; hip yaw joint
    40 mm higher on the thigh (roll-yaw 60 mm, yaw-knee 155 mm); knee range
    0-125°; shoulder pitch RS03 pulled into the torso; shoulder roll -5°;
    neck yaw servo lowered. Step-up, standing and symmetry checks pass;
    CI runs the packaging check.
    [marvin_bot.urdf, robot.yaml]
2026-10-26 Leg code-CAD first pass; CAD masses and meshes in the URDF
    cad/leg.py draws the legs around the motors at their STEP-model sizes
    (hip flange and yoke plates, two-plate hip roll bracket, thigh flange,
    side plate and printed shell, shin knee flange, central ankle-motor web
    and bearing fork, ankle cross, cranks and rods, foot base, posts, lugs
    and TPU sole), pocketed. cad/build.py writes meshes (git-ignored) and
    description/cad_model.yaml (mass, CoM, inertia per part) and checks every
    part fits the desktop mill or printer; the foot base plates go to a
    cutting service. build_urdf.py uses the CAD parts in place of the leg
    and foot estimates: 1.72 kg structure + 0.46 kg foot per leg, robot at
    37.9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
    [marvin_bot.urdf]
2026-10-26 Clearance reward pays only swinging feet; first policy passes MuJoCo
    The Spot-style clearance term weighted the height error by foot speed, so
    a planted foot earned the full reward and the flat v2 policy learned to
    stand and shuffle. Each foot's term is now weighted by tanh of its speed.
    Flat action scale 0.25 -> 0.5. The rough v2 policy passes the MuJoCo
    flat-ground cross-check (walk 0.44 m/s, turn, stop, symmetric gait) but
    does not climb stairs yet; results in sim/isaaclab/README.md.
2026-10-26 BOM: Seeed Studio actuator prices and bulk tiers
    Every Robstride model in the BOM is stocked by Seeed Studio at RobStride's
    list price with ~5% off at 10+ of one model: actuators ~$5,800 at
    single prices (was ~$6,250 at US resellers). Plan: bench units singly,
    then the remaining 11 RS03 together after the bench test for the 10+
    price. Adds RobStride's USB-to-CAN debug adapter; camera at the Orbbec
    store price. Total ~$11,800.
    [bom.csv]
2026-10-26 Heat model: RMS torque check in MuJoCo, sustained-torque penalty in training
    sim/mujoco/check_policy.py now reports each segment's RMS torque against
    every joint's continuous rating (steady-state heating) and fails above
    100%. The rough v2 policy walks with its knees at 60-64% of rated.
    Training gains a penalty on leg joints whose ~1 s running average of
    (torque/rated)^2 exceeds 0.8, aimed at the knee load on slow stairs.
    [robot_cfg.py]
2026-10-26 Strength check of the leg CAD; landing case fails one-sided parts
    cad/strength.py cuts each load-carrying part at stations along its load
    path, uses the real CAD cross section, and checks bending plus axial
    stress against yield for a landing load (3 x body weight with fore-aft
    and side components) and each joint's peak torque. Peak torques pass;
    the landing case fails the foot base, hip yoke and hip roll plates and
    the shin knee flange, all hung on one side of a motor. Second pass will
    add the far-side supports the concept called for.
2026-10-26 Flat walking policy v3 passes the MuJoCo cross-check to 0.8 m/s
    With the clearance fix and action scale 0.5 the flat policy steps: in
    MuJoCo it walks 0.49 m/s for 0.5, 0.80 for 0.8, turns, walks and turns,
    and stops, with a symmetric gait and every joint within its continuous
    rating (ankle pitch hottest at 73%).
2026-10-26 Stairs training v4: progress reward, stair-heavy terrain
    Rough v3 climbs 5 cm stairs in MuJoCo but stops at 10 cm: its terrain
    curriculum plateaued because waiting at a stair bottom was safe and the
    sharp tracking reward paid nothing for a slow climb. v4 adds a linear
    progress reward along the command, widens rough-ground tracking to 0.25,
    puts stairs (4-20 cm) on 55% of tiles, and trains 6000 iterations.
2026-10-26 Leg second pass with far-side supports; mass limit 40 kg; stairs note
    The second-pass leg (far-side bearings at the knee and hip roll, a
    channel-flanged hip block, a ribbed foot) passes cad/strength.py with a
    worst safety factor of 2.4, now run in CI. The robot is 39.55 kg; the
    computer and battery stay as they are, so the hard limit is raised to
    40 kg (target still 35 kg). docs/design/stairs.md documents the stair
    climbing status and open issues: knee heat on slow stairs (115% of the
    RS04's rating in the static check), the stair policy stopping at the
    first step, mass, the knee options, and how they get settled.
    [marvin_bot.urdf, robot.yaml]
2026-10-26 Pelvis and torso CAD, first pass
    cad/torso.py draws a pocketed box-frame pelvis (hip pitch RS04s on the
    side plates, waist RS03 on top, electronics inside) and a torso of waist
    flange, base plate, service-cut uprights carrying the shoulder RS03s, a
    neck bridge and a printed chest shell open at the back for the battery.
    0.86 + 1.46 kg against 1.0 + 1.8 kg estimated; robot 39.06 kg, stance
    knee on a slow 18 cm step at 112% of rated. The pelvis frame is in the
    strength check (SF 37). All checks pass.
    [marvin_bot.urdf]
2026-10-26 Stairs policy v5 climbs 10-20 cm stairs; knee heat 73-75% on stairs
    Rough v5 (capped progress reward, stair-heavy terrain, heat penalty,
    6000 iterations) climbs 10, 15, 18 and 20 cm stairs up and down in the
    MuJoCo cross-check and still walks, turns and stops on flat ground. On
    stairs the knees average 73-75% of their continuous rating (RMS), well
    under the static worst case of 112%, so the knee stays an RS04 pending
    the bench test. Stairs note, results, roadmap and decisions updated.
2026-10-26 Arm, head and clip-on cover CAD; generated wiring harness
    - cad/arm.py: two-plate shoulder brackets (7 mm, SF >= 2.4 in a new hand-load case),
    aluminium motor rings, printed upper-arm and forearm shells, gripper palm and jaw
    - cad/head.py: neck bracket, head frame, egg shell, visor with an optics slot, depth camera
    - cad/covers.py: optional clip-on covers (offset skins of each link's parts), written only
    into marvin_bot_covers.urdf; the default URDF stays the bare robot
    - tools/build_harness.py: per-limb harness routes, service loops, gauges and fuses from the
    CAN map; checked in CI
    - mass 39.20 kg bare, 39.76 kg with covers
    [marvin_bot.urdf, marvin_bot_covers.urdf]
2026-10-26 Assembly, wiring and covers design note; roadmap and decisions
2026-10-26 Staggered ankle motors for a slim shin; ring-and-strap plates
    - The two ankle RS03 sit one above the other on the shin's centre line between two side
    plates (one under the knee, one behind the ankle): shin ~95 mm wide instead of ~132,
    ankle torque 32 / 25 N·m continuous (pitch / roll), ratios 0.99 / 0.67
    - tools/ankle_linkage.py: a position per motor; search over staggered layouts
    - Plates reduced to rings on the motors' bolt circles joined by straps (thigh, hip,
    pelvis, torso A-frame uprights, shoulder); all pass cad/strength.py (worst SF 2.2)
    - Robot 38.71 kg (was 39.20); 39.30 kg with covers
    [marvin_bot.urdf, marvin_bot_covers.urdf]
2026-10-26 Helmet head and full body shells, with a shell clearance check
    - cad/head.py: helmet (hull of crown and chin ellipsoids) with a full-face visor and an
    optics slot; head frame clear of the neck bracket through the pitch range
    - cad/covers.py: full shell set as an add-on (torso lofted from rounded sections in eight
    printable pieces with closed sides and shoulder openings, neck sleeve, hip girdle, thigh,
    shin, hip, shoulder, arm sleeves, toe caps), 1.6 mm, 1.10 kg
    - python -m cad.covers --check sweeps every joint range plus combined poses and fails on
    any shell contact; in CI
    - 38.70 kg bare, 39.80 kg with shells
    [marvin_bot.urdf, marvin_bot_covers.urdf]
2026-10-26 More human proportions: shallower torso, helmet head with eye-level camera, longer neck
    - Computer stands on edge: torso frame 155 mm deep (was 190); the shell no longer flares
    - Helmet head 142 mm wide, 170 mm tall; camera at eye height, half way up the face
    - Neck 20 mm longer; torso shell shoulders slope into a collar round a flared neck sleeve;
    upper-arm shell runs down the back of the elbow
    - 1.29 m tall, 38.66 kg bare, 39.77 kg with shells; every shell clears through all joint
    ranges
    [marvin_bot.urdf, marvin_bot_covers.urdf, robot.yaml]
2026-10-26 Torso shell follows the frame: ~13 mm off it, broad shoulders over a slimmer waist
    The shell was the convex hull of the whole torso, so the shoulder motors held its sides out
    all the way down (up to 44 mm of air). It now follows the frame slice by slice, blending
    where the width changes. 39.76 kg with shells; every shell clears all joint ranges.
    [marvin_bot_covers.urdf]
2026-10-26 Narrower shoulders: arms 158 mm off the centre line (was 188)
    - Shoulder pitch motors 30 mm deeper in the torso (centres ±80 mm, joints ±110 mm);
    shoulders 416 mm across (was 476)
    - Side frames in two plates: a lower A-frame outside the battery, an upper plate on the
    shoulder motor above the battery and computer, joined by spacers; narrower bays for the
    electronics and keep-alive battery; battery 4.5 mm lower
    - Shoulder roll range 0-120° (below 0° the forearm now meets the hip motor)
    - 38.80 kg bare, 39.88 kg with shells; packaging, strength and shell checks pass
    [marvin_bot.urdf, marvin_bot_covers.urdf, robot.yaml]
2026-10-26 Head profile like a helmet seen from the side; glute and upper-thigh shells
    - Head deeper than wide (160 x 142 mm), forward of the neck; visor leaning back 18°;
    underside rising from chin to neck; camera behind a flush tinted window
    - Glute shells over the hip roll motors (rounded) and upper-thigh shells over the hip yaw
    motors; shells 1.4 mm; 38.81 kg bare, 39.93 kg with shells; all shells clear
    [marvin_bot.urdf, marvin_bot_covers.urdf, robot.yaml]
2026-10-26 Roll-first hip: hip roll motors fixed in the pelvis
    - Hip is roll -> pitch -> yaw: roll RS04s on a new pelvis back plate behind the hips; roll
    brackets (U round the roll motor, far-side bearing, outboard bar) carry the pitch RS04s
    at the hip joints; thighs hang from the pitch motors in U-yokes with inner bearings
    - Pelvis: back plate, top plate under the waist motor, two gussets, clear of the swinging
    pitch motors; torso 25 mm ahead of the hips (restores 10-20 cm static step-up)
    - Ranges: knee 0-130° (was 125°), hip pitch -30-120° (was -40°)
    - cad.covers --check also sweeps the real CAD parts against each other; fixes for the
    roll bracket bar, pelvis gussets and the upper-arm she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
    [marvin_bot.urdf, marvin_bot_covers.urdf, robot.yaml]
2026-10-26 Box thigh top round the hip pitch motor; roll bracket bars over the roll motors
    - Thigh top is a closed box (outer and inner walls, front and back walls, yaw motor under
    its floor) instead of a U of two plates; outer wall 6 mm (was 8), SF 5.6
    - Roll bracket bars run over the roll motors; pelvis back plate full width only below the
    roll axes with a narrow spine above, clear of the bars at 45° roll
    - No shells over the hip roll motors
    - 38.78 kg bare, 39.74 kg with shells; part and shell sweep, packaging, stairs pass
    [marvin_bot.urdf, marvin_bot_covers.urdf]
2026-10-26 Real actuator outlines and mounts; servos the right way up; computer mount
    - actuators.yaml: body, rear driver cap and hole circles from RobStride's drawings and STEP
    models; robot.yaml: each motor's output direction (and servo case direction)
    - build_urdf: stepped motor outlines (body + cap, servo boxes) in visuals, packaging and sweep
    - cad/mounts.py: rear rings on the real stator holes with cap clearance, posts to the outer
    plates (now light spiders where they carry no bolts), output flanges with the output hole
    circle and a running relief; every leg, pelvis, torso and arm mount reworked
    - Neck bracket, head frame, neck sleeve and gripper rebuilt round the servos' real axis
    - Comput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
    [marvin_bot.urdf, marvin_bot_covers.urdf, robot.yaml]
2026-10-26 Electronics bay, battery cradle and limb-root bulkheads
    Lay out the bought electronics at typical outlines in the torso and pelvis
    (cad/electrical.py), with the battery slide-out cradle, printed guides and
    latch, and a power and signal bulkhead per limb. The harness names each
    limb's bulkhead and the clip pair for every service loop, and the leg chain
    follows the roll-first order. Printed parts are strength-checked and the
    ankle linkage is in the part sweep. BOM: compact 12 V servo DC-DC, limb
    connectors. 39.13 kg bare, 39.96 kg with shells.
    [bom.csv, marvin_bot.urdf, marvin_bot_covers.urdf]
2026-10-26 Part exports and build BOM
    cad/export.py writes an STL per made part and a DXF outline per flat part
    (outputs/, git-ignored), and the generated build lists bom/build_parts.csv
    (mirror pairs counted once, process, material, stock, mass, size) and
    bom/build_fasteners.csv (actuator bolts from the hole circles). CI checks
    the lists are current.
    [build_fasteners.csv, build_parts.csv]
2026-10-26 cad.build --check: show the first differences
2026-10-26 Round CAD mass properties to absolute steps so the check is CPU-independent
    [marvin_bot.urdf, marvin_bot_covers.urdf]
2026-10-26 Isaac Lab results: rough v6 final (15 cm stairs pass; 18-20 cm fall)
2026-10-27 Walking rewards: pelvis height and stand pose; rough v7 climbs 5-20 cm stairs upright
    Rough v6 stood with its knees at 95 degrees and climbed in a crouch. Adds a pelvis-height
    penalty (below stance height above the lower foot) and a stand-pose penalty, doubles the
    rough heat penalty, and puts steep 14-20 cm stairs on every curriculum row. The MuJoCo
    policy check now prints pelvis height and knee bend per segment.
2026-10-27 Knee 15° stance and level feet in swing; flat v6 and rough v8 pass, 5-20 cm stairs
    The default stance straightens (knee 25 -> 15 deg, pelvis 0.645 m). A swing foot-level
    term stops the toe-down swing (up to 30 deg, now 11-16 deg). The MuJoCo check prints foot
    pitch in swing and at touchdown, and measures the stair climb from the walking height.
    USD reconverted (it was 0.35 kg light).
    [robot.yaml]
2026-10-27 Walking policies without the side-to-side waddle; motion-tracking pipeline
    Pelvis-roll and step-width terms, hip and ankle roll held, less air-time
    reward, 2 cm pelvis allowance, and random command and sensor delays
    (DelayedDCMotor). Flat v7 and rough v9 roll 4-6 deg instead of 20-22 and
    pass every MuJoCo check. check_policy reports head and pelvis sway, roll
    and step width. sim/motion adds Marvin Bot to ProtoMotions and retargets
    human motion with its PyRoki retargeter.
2026-10-27 Docs: current renders and policy clips; motion pipeline fixes
    - README: current size and mass, render of the robot bare and with covers, clips of
    flat v7 walking and rough v9 on 15 cm stairs, sim/motion in the layout.
    - Isaac Lab README: posture, anti-sway and delay terms in the task description,
    clips, and a blank line that split the results table removed.
    - Roadmap: stair policies, retrain, waddle fix and electronics bay ticked; stair
    robustness and motion tracking open.
    - Motion pipeline: the first tracker passed ProtoMotions' height-only test but
    shuffled on the spot. Arms now collide with the ground only in the tracking
    model (the gripper boxes overlap the thighs at rest), ret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
2026-10-27 Roadmap: skills to train before the build, hand options
    Lists the skills beyond walking that can be trained in simulation now
    (getting up, expressive clips, a general tracker for teleoperation,
    squat-and-reach, stairs from depth, carrying and sitting, kicking,
    manipulation rehearsal with GR00T-Mimic and Cosmos), with the papers
    behind each, and the gripper and hand options in order of cost.
2026-10-27 Four-finger hands on a wrist pitch joint; mass limit includes the shells
    Replaces the 1-DOF grippers with the two bought 8-servo hand kits. The
    gripper STS3250 becomes a wrist pitch joint (+-60 deg) in a printed cradle
    under the wrist RS00, with a printed U and plate carrying the hand
    (modelled as its envelope, 0.40 kg each). The forearm is 0.188 m to the
    wrist axis, a person's at this height. 27 body DOF.
    The hard limit now applies to the robot with hands and body shells and is
    41 kg (39.86 kg bare, 40.68 kg with shells). Harness, BOM (hands, 5 V
    converters, a serial adapter per hand), strength and sweep checks, Isaac
    Lab gains and the motion scripts follow. Also includes the retargeting
    c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
    [bom.csv, build_parts.csv, marvin_bot.urdf, marvin_bot_covers.urdf, robot.yaml]
2026-10-27 Real AmazingHand meshes on the wrists; docs and credits audit
    The hands are now the AmazingHand (Pollen Robotics) meshes, derived from
    its CC-BY-4.0 CAD and MuJoCo models by tools/build_hand_mesh.py and kept
    under their own licence in description/third_party/amazing_hand/ with
    attribution. Real left and right hands; the mount plate takes the hand's
    6 x M3 on a 42 mm circle. README render updated.
    Docs: README goals (6-DOF arms, hand payload), 40 kg mass in the safety
    notes, payload requirement note, third-party licence rules in
    CONTRIBUTING.md, and credits for the CAD libraries, the Orin model, the
    hand servos, the body-proportion source and Kimodo's licences.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
    [bom.csv, build_parts.csv, marvin_bot.urdf, marvin_bot_covers.urdf]
2026-10-27 Public-release prep: warning, code of conduct, security policy, render tool
    README: a work-in-progress and safety warning at the top, a Built on
    section crediting the main open projects, and links to the new
    CODE_OF_CONDUCT.md (Contributor Covenant 2.1) and SECURITY.md (private
    reporting of safety issues). tools/render_robot.py regenerates the README
    robot picture. The walking and stair animations are re-rendered with the
    hands (flat v7 and rough v9 still pass their MuJoCo checks);
    check_policy.py reads policies exported before the wrist pitch joint.
    Asimov 1 and Roboto Origin are credited by project and repository.
    [render_robot.py]
2026-10-27 README accuracy pass; animations with the palms towards the thighs
    Goals now match the roadmap and requirements (push and fall recovery,
    skills learned by motion tracking, GR00T manipulation, covers as an
    optional add-on rather than structure, the current BOM cost); the design
    table gives the current mass, the hand servos and the serial buses; the
    layout and checks list the third-party meshes and the render tool.
    check_policy.py --wrist-yaw holds the wrists at an angle; the walking and
    stair clips are re-rendered with the palms turned in (both still pass).
2026-10-27 Licensing and attribution fixes from the compliance review
    - Isaac Lab (BSD-3-Clause): its notice in the five sim/isaaclab files
    adapted from it, LICENSES/BSD-3-Clause-IsaacLab.txt, and an
    acknowledgement saying what was adapted.
    - BONES-SEED: the retargeting render is removed (its licence grants
    rights only to academic institutions and companies under $1M revenue);
    the required credit and an eligibility notice are added.
    - AmazingHand meshes: both upstream licences (CC-BY-4.0 design files,
    Apache-2.0 MuJoCo models) stated, with a LICENSE in the folder.
    - README licence table by path, a NOTICE file with the CERN-OHL-S
    source location, and a copyright line; package metadata update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
    [bom.csv]
2026-10-27 Reproducibility and documentation fixes from the repo review
    Reproducibility: tools/check_all.sh runs every CI check (CI now calls
    it); Isaac Lab pinned to the commit used, with GPU, timing, the rough
    export command, where logs land, the mesh prerequisite and how flat v7 /
    rough v9 were trained; the motion pipeline gets an explicit folder
    layout, pinned ProtoMotions and PyRoki commits and a command that picks
    the eight clips; check_policy.py --render writes the README WebP clips
    directly; MuJoCo checks say to run cad.build when meshes are missing;
    mujoco>=3.7 (3.3-3.6 fail), ruff and fast_simplification pinned,
    imageio in the sim extra; AmazingHand source commit pinned.
    Docs: README badges,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
    [robot.yaml]
2026-10-28 Motion tracking on 100STYLE; tracker experiment with the anchor-position reward
    The trackers now learn from 100STYLE (CC-BY-4.0) instead of ProtoMotions'
    BONES-SEED samples, whose licence excludes most users. convert_100style.py
    turns its BVH files into the retargeter's SOMA-convention keypoints
    (retarget_marvin_bot.py --converted). Compared with Kimodo and CMU on the
    same eight motions, 100STYLE tracked best (5 of 8 clips upright after
    1,400 epochs; 87-101% of the reference's distance walking and turning).
    setup_protomotions.py also writes the tracker experiment from upstream's
    BeyondMimic config, with the global anchor-position reward and fell-behind
    termination it leaves out, the referen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
2026-10-28 Motion tracking on Kimodo motions; trackers step instead of hopping
    Kimodo (NVIDIA's text-to-motion model) replaces 100STYLE as the motion
    source. generate_kimodo.py gives each locomotion clip and in-place skill
    a root path, so the pace is set rather than worded, and keeps the best
    of several samples; the clips go through ProtoMotions' own Kimodo route.
    Fixes found on the way:
    - fix_sole_height.py puts the stance (flatter) foot on the floor; the
    clip's lowest corner was a toe tipped at push-off, so the walks
    floated 3-5 cm.
    - The tracker penalizes each foot whose contact differs from the
    reference's (-2.0): without it, it hopped on both feet.
    - The motion pipeline's pose turns the pal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
2026-10-28 Motion tracker follows the arms: key-body rewards, body-error termination
    The tracker's body rewards averaged the error over all 28 bodies, so an
    arm left at the side while the reference raised it cost little (hands
    40-75 cm off in the arm skills). They now score BeyondMimic's 14 key
    bodies, and an episode ends when any body is 25 cm from the reference's,
    as in ProtoMotions' deployed G1 tracker. At epoch 1,400 the hands are
    8-20 cm off in the same skills.
    check_tracking.py reports hand and foot errors alongside the all-body
    average, which hid the arms. Training uses 16,384 robots, which keeps
    the GPU busy (95%, against 58% with 4,096).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
2026-10-28 Wider shoulder yaw, hip roll, hip yaw and waist yaw ranges
    Motion tracking showed the narrow ranges limiting skills (the two-hand
    wave and reach held the shoulder yaw on its 90 deg stop; sidesteps hit
    the -20 deg hip roll). Four ranges widen with no part, mass or cost
    change: shoulder yaw +-150 (was +-90), hip roll -30 (was -20), hip yaw
    +-90 (was +-45), waist yaw +-150 (was +-90). The clearance checks pass;
    the new contacts are between limbs and avoided by control. URDFs and
    harness service loops regenerated. Shoulder roll below 0 needs a
    pitch-dependent limit and is not changed here.
    [marvin_bot.urdf, marvin_bot_covers.urdf, robot.yaml]
2026-10-28 Honest mass budget; stronger thigh plate, thinner shin and pelvis plates
    The mass budget now carries the weighed computer (0.877 kg, was a 1.5 kg
    estimate) and the fasteners (0.4 kg) and limb harness (0.5 kg) the CAD
    leaves out: 40.74 kg with shells, under the 41 kg limit.
    The thigh plate, weak against a sideways fall onto the knee (finite
    elements: SF 0.5 at an estimated 1 x body weight), is now 9 mm stock
    pocketed to a 2 mm floor (lighten(..., floor=)): SF 2.3 in the new side
    case in cad/strength.py, +61 g a side. The shin side plates go 6 -> 4 mm
    and the pelvis back plate 8 -> 6 mm (SF 2.1 each). The torso base, which
    a hand catch twists, needs FEA and is recorded as open.
    Co-Authored-B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
    [build_parts.csv, marvin_bot.urdf, marvin_bot_covers.urdf]
2026-10-29 Retargeted arms kept out of the body; tracking model arms collide
    Upstream's retargeter leaves its self-collision cost off, and the
    retargeted arms passed through the body: hands 4-10 cm into the thighs
    in most walking frames, the palms 9 cm through each other in the clap.
    retarget_marvin_bot.py now patches the upstream script on load to turn
    the cost on (weight 10, 2 cm margin) for an arm's lower links against
    the trunk, the legs and the other arm only, which leaves no frame with
    an arm more than 1 cm into the body. In the tracking model the arms now
    collide with the body and each other, not only the ground.
    A tracker trained on the 25 Kimodo clips retargeted this way matches
    the previous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
2026-10-29 Fastener and harness mass boxes not drawn; README robot picture updated
    The fastener and limb-harness budget items added with the honest mass
    budget are boxes spread over each link (for mass and inertia), and the
    URDF builder drew them like the computer and battery boxes: a grey box
    over the chest and dark boxes over the pelvis and legs. They are now
    left out of the visuals (NOT_DRAWN in tools/build_urdf.py); masses and
    inertias are unchanged (39.91 kg bare, 40.74 kg with shells).
    docs/media/robot.webp is re-rendered with the current plates.
    [marvin_bot.urdf, marvin_bot_covers.urdf]
2026-10-29 Light head shell and neck behind a dark visor; camera window noted
    The helmet shell and neck sleeve are now light like the body shells,
    and the dark visor is the face ahead of a plane from the back of the
    crown down to the chin (28 deg from vertical, 20 mm further back at eye
    height), so the light shell behind it reads as jaw and neck. Same shell,
    mass and window; README render updated.
    Found while checking it: the camera window, a 20 mm band in the skin
    16-52 mm ahead of the camera, passes only about a third of the depth
    view. Recorded in decisions and the roadmap's open questions.
    [build_parts.csv, marvin_bot.urdf, marvin_bot_covers.urdf]
2026-10-29 Depth camera level with the face in a light printed frame
    The camera window behind the curved face let through about a third of
    the depth camera's view. The camera now sits with its front level with
    the face's front on the centre line, in a light printed frame like a
    pair of spectacles across the black visor, so nothing is ahead of its
    lenses (a ray cast clears 100% of the 90 x 65 deg view). The frame is
    only the part outside the helmet (22 g); the camera slides in from the
    front and screws to a new arm on the head frame by its tripod thread.
    The head is 17 g heavier (0.452 kg); the robot 40.75 kg with shells.
    The camera's outline, lens positions and tripod thread are measured
    from Orbbec's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
    [build_parts.csv, marvin_bot.urdf, marvin_bot_covers.urdf]
2026-10-29 Longer torso and legs (1.44 m), battery high for a V-shaped torso; 42 kg limit
    At 1.29 m the hands hung almost to the knees. The torso is 100 mm
    longer, the shoulder roll joint 25 mm closer under the shoulder pitch
    joint, and the legs 50 mm longer (thigh above the hip yaw motor, so the
    thigh plate still fits the mill; shin with the ankle motors kept at the
    ankle). Fingertips reach 0.556 m (a person's 0.542 m), hips 0.48 of the
    height. The battery sits high on a shelf under the shoulder motors and
    the lower frames lean in to the computer's width, so the torso narrows
    to 160 mm at the waist (was 188). Shin straps 44 mm (SF 2.3); chest
    shell in two prints, torso cover seams at 200 mm.
    40.41 kg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
    [build_parts.csv, marvin_bot.urdf, marvin_bot_covers.urdf, robot.yaml]
2026-10-29 Retarget scales follow the robot's size; skill clip renderer
    retarget_marvin_bot.py's leg, torso and arm scales were constants for
    the 1.29 m body. They are now worked out from description/robot.yaml
    and skeleton.yaml (the same values as before for the old sizes), so the
    1.44 m body gets leg 0.75, shoulder height 0.955, arm 0.746.
    sim/motion/render_tracking.py renders a trained tracker against its
    reference (a translucent blue ghost) as one animated WebP per clip, for
    the docs: an export step in the ProtoMotions environment and a render
    step in this repo's.
2026-10-29 Shoe-shaped foot plate with a slight V toe
    The foot plate and sole were rectangles. They now follow a shoe's outline: full-width heel with rounded corners, widest at the ball, and a toe narrowing in a slight V to a rounded point set towards the inside; the toe cap follows. A 20 mm rib down the middle of the toe keeps a toe-first landing at SF 3.3. Feet -67 g; simulation keeps its rectangular contact box.
    [build_parts.csv, marvin_bot.urdf, marvin_bot_covers.urdf]
2026-10-29 cad/leg.py: wrap the foot docstring line
2026-10-29 README walking clips replayed on the 1.44 m model
    The flat and stair policies, trained on the 1.29 m body, still pass check_policy.py on the current model (walk, turn, stop; 15 cm stairs), with the knees bent about 40 degrees while walking. The clips are re-rendered with the new body until the policies are retrained.
2026-10-29 RobStride driver: host CAN ID in identifier bits 15-8
    Enable, stop, set-zero and parameter frames put the host ID at bits 23-16 (host_id << 8 passed as data area 2, which arbitration_id shifts by 8 again). RobStride's frame layout, and other open drivers, put it at bits 15-8: (type << 24) | (host << 8) | motor. The test that asserted the old layout now checks the corrected one. The bus class stays untested on hardware.
    [robstride.py]
2026-10-29 Docs follow the 1.44 m model
    CITATION and pyproject still said 1.29 m; requirements R1 and R2 (height, 42 kg limit), the README's mass with shells (41.3 kg), the stair note (knee 47 N·m, 118% of rated, 20 cm now statically possible, 0.70 m hip height), the assembly note (battery high on its shelf, keep-alive pack low, harness lengths, 0.95 kg shells), the concept's proportions, the bench thermal torque and the Isaac Lab heat note now match the current model. The roadmap's retrain item names the 1.44 m body.
2026-10-29 Comments: battery guides on the shelf; reflowed docstrings
2026-10-29 robot.yaml: stance pelvis height in the comment (0.694 m)
    [robot.yaml]
2026-10-29 Skills page: all 25 tracked skills on the 1.44 m model, with the reference as a ghost
    One motion-tracking policy (4,800 epochs, Newton) follows every Kimodo clip upright. The README
    shows walking, clapping and kicking in place of the walking and stair clips (still in
    sim/isaaclab/README.md); docs/skills.md shows all 25 with joint and hand errors.
2026-10-29 Refer only to open-source projects: drop Unitree and Booster references
    Removes the commercial benchmark and style references from the acknowledgements, decisions,
    roadmap and assembly notes; G1 stays only where it names a task or tool in an open-source
    repository we adapt. K-Scale credited as inspiration only, with its actual licences (MIT
    software, CERN-OHL-S-2.0 hardware).
2026-10-29 Shoulder roll below 0° with the arm forward (coupled limit)
    Shoulder roll goes to -10° with the arm 45-75° forward and -20° at 90-135°, and stays at 0° with
    the arm hanging, so the clap, reach and squat references can bring the hands to the middle.
    coupled_limits in robot.yaml; cad.covers --check and check_packaging.py check every point of it.
    -30° was checked and needs the shoulder rebuilt. check_robot.py runs the delayed DC motors in
    Isaac Lab's Python actuator path, as the tasks do.
    [marvin_bot.urdf, marvin_bot_covers.urdf, robot.yaml]
2026-10-29 Motion: check clips against their prompts; head motion; tracker scores head and joints
    check_clips.py scores each Kimodo clip and its robot reference: TMR text match, Kimodo's
    quality metrics, a geometric test per skill, and side-by-side review renders.
    add_head_motion.py gives the references the human's neck yaw and pitch (the retargeter held the
    neck at rest). The tracker scores the head and adds a joint-angle term. render_tracking.py
    --plot draws the tracking error under each clip.
2026-10-29 check_clips.py: draw the head and fingers on the human stick figure
2026-10-29 Kimodo: keep the sample that passes the skill checks; regenerate five weak clips
    generate_kimodo.py keeps the sample with the fewest failed check_clips.py skill checks. Sharper
    prompts for the wave, arm raise and march, and no root path for the idle and the dance sway
    (a path pinned at the start held their hips still): all 25 clips pass.
2026-10-29 BOM: full cost to replicate (~$17.5k), sourcing table, spreadsheet generator
    Owned items (AGX Orin developer kit, hand kits) now carry current prices;
    the developer kit is $3,499 since NVIDIA's July 2026 rise. Corrections:
    STS3250 at ~$97, online machining for the 12 oversize parts, missing tools,
    NVMe and USB hub, CAN adapters for all 7 buses (dual-channel per leg).
    bom/sourcing.csv lists dated sources; tools/build_bom_xlsx.py builds
    outputs/bom.xlsx from the CSVs. Cost sentences in the docs updated.
    [bom.csv, sourcing.csv]
2026-10-29 BOM: one workbook (bom/bom.xlsx) as the source of truth, maintained by tools/bom_book.py
    The workbook replaces bom.csv, sourcing.csv and the CAD's build_parts.csv and
    build_fasteners.csv. Each line has a to buy / ordered / owned status dropdown;
    the Summary totals owned, ordered and still to buy per group and phase with
    formulas. tools/bom_book.py tidies the workbook after hand edits, edits lines
    from the command line (set, add, source, remove) and checks it in CI.
    cad.export updates the two CAD sheets in place and keeps builders' status
    columns. openpyxl is now a core dependency.
    [bom.csv, bom.xlsx, build_fasteners.csv, build_parts.csv, sourcing.csv]
2026-10-29 BOM workbook: store formula results so totals show in any viewer; tools in tools/bom/
    The workbook saved by openpyxl held formulas without cached results, so
    previews and viewers that do not recalculate showed empty totals.
    tools/bom/book.py now writes each formula's value next to it (line totals,
    group totals, the Summary), and --check fails if the stored values are stale.
    The BOM tools move to tools/bom/ (book.py, summary.py).
    [bom.xlsx]
2026-10-29 BOM: one line per item with a spares column, no purchase phases
    Each item now has one line with its full quantity and spares (RS03: 11 + 1
    spare), sorted by item, so a model's count reads off one row. The phase
    column and the Summary's per-phase table are gone; docs/plan.md says what
    each phase needs. tools/bom/summary.py prints each motor model's quantity.
    [bom.xlsx]
2026-10-29 BOM workbook ships with every status empty, as a template for builders
    No line, made part or bolt is marked owned or ordered; an empty status
    counts as to buy, and the Summary's to-buy column is the total less owned
    and ordered. Docs no longer quote what this build owns.
    [bom.xlsx]
2026-10-29 CAN bus load: worst-case extended frame is 160 bits, not 150
    A 29-bit-ID frame with 8 data bytes is 131 bits plus up to 29 stuff bits. Every bus stays at or
    below 48% (was 45%), under the 60% limit.
    [robot.yaml]
2026-10-30 Documentation website: 3-D home page, docs from the repository's Markdown, interactive guide (#4)
    Adds site/, an Astro Starlight site published to GitHub Pages by .github/workflows/pages.yml:
    - Home page: the robot in 3-D, full screen (generated from the URDF, cad_model.yaml and the
    code-CAD meshes by site/scripts/build_model.py on every deploy), with views for the finished
    robot, the bare frame and X-rays of the motors and electronics.
    - Docs: README, docs/, the sim and bom/bench READMEs, CONTRIBUTING, ACKNOWLEDGMENTS, SECURITY,
    the code of conduct and LICENSES/README, copied in at build time by site/scripts/sync-docs.mjs
    (links rewritten, GitHub alerts turned into asides, edit lin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
2026-10-30 Docs site: interactive guide as native Starlight pages; smooth 3-D meshes (#7)
    The guide's 23 playgrounds, map, glossary and sources page are now MDX pages in
    the Starlight layout (sidebar, search, page navigation, light and dark themes)
    instead of standalone HTML. Prose is Markdown with Starlight asides; each
    playground's controls, plots and script stay as plain HTML and JavaScript in
    site/src/guide/<page>/, styled through site/src/styles/guide.css. The old
    public/guide/*.html addresses redirect to the new pages.
    The 3-D viewers looked faceted because they used flat shading on meshes cut to
    a quarter of their triangles. They now share site/src/scripts/marvin-render.js:
    crease-angle smooth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
2026-10-30 Guide scripts: fix the three CodeQL warnings
    - 18-wbc-vla: build the verdict with DOM nodes instead of innerHTML from the option's text
    - 21-bom-costs: write the currency symbol in directly rather than replacing the first '$'
    - 16-rl-walking: drop a replace('e','e') that did nothing
2026-10-30 Tracker v5: head scored, joint-angle term on legs, waist and neck only
    The joint-angle term over every joint made the arm clips worse: the retargeted
    shoulder angles are ill-defined (arms raise twists shoulder yaw by 175 deg for no
    change in the hand), so the arms are left to their body positions. Head turning
    93 to 41 deg/s RMS over the 25 clips, feet 5.4 to 4.8 cm, hands 6.6 to 6.8 cm.
    New clips on the skills page (hands and feet errors), walk, squat and bow in the
    README.
2026-10-30 Docs site: true colours, exact code-CAD meshes, aligned titles (#8)
    - The 3-D viewers read the URDF colours as linear values, which lifted every
    dark colour towards grey; they are sRGB, as written. Neutral tone mapping
    replaces the filmic curve that greyed and desaturated the whole model.
    - build_model.py simplified every mesh by the same ratio, which broke small
    parts such as the chest shell's vent slots (272 triangles). The code-CAD
    meshes are now kept exact; only the dense hand meshes are simplified.
    - Pages with a playground widened only the content's container, so the title
    sat out of line with the text (by about 150 px on the 3-D page). Both
    containers now widen together.
    -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
2026-10-30 Docs site: social preview card; finish colours and palms-in pose (#9)
    * Docs site: social preview card for links to the site and repository
    site/public/social-card.png (1280×640) is rendered from the current 3-D model
    by site/scripts/social-card.html, using the site's own viewer, so it can be
    regenerated when the design changes. Every page now points to it in og:image
    tags; the same file is meant for the repository's Social preview setting.
    * Docs site: finish colours and palms-in pose for the 3-D model
    The viewers drew every part in its URDF colour, which codes each motor model
    by colour. They now use the finish palette of tools/r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
2026-10-30 Docs site: 1200×630 link-preview image, shorter description, site name (#10)
    Most link previews expect a 1.91:1 image, so the website's og:image is now
    public/og-image.png (1200×630); public/social-card.png stays 1280×640 for
    GitHub's Social preview setting. Both come from scripts/social-card.html,
    which now renders at either size. The home page's description is cut to 154
    characters so search results don't truncate it, and it names the site
    (og:site_name) for Discord and other cards.
2026-10-30 Motion tracker: MuJoCo replay, the sim-to-sim check
    sim/motion/replay_mujoco.py runs the tracker, exported to ONNX by ProtoMotions'
    deployment tool, in MuJoCo on the training MJCF, with the motors as the walking
    check models them (torque-speed line, armature, friction) and sensor noise.
    Tracker v5: every clip upright at half and full noise; joints 11.0 deg, hands
    6.7 cm, feet 4.5 cm against 11.2, 6.8 and 4.8 in Newton. render_tracking.py
    export --mujoco draws the replay as a translucent orange robot.
    The tracker reads the torso's world position, which the robot will have only
    from odometry; noted in the roadmap and the motion README.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
2026-10-30 Finite-element check of every load-carrying part (cad/fea.py)
    Each link's metal parts (and the printed shells that carry load between them)
    meshed as one bonded solid with fTetWild, quadratic tetrahedra in scikit-fem,
    solved with PARDISO. Held at the motor or bearing face that carries the link,
    loaded through a rigid coupling at the next link's interfaces, with the
    strength check's load cases. The part generators record each motor ring,
    flange, bearing bore and stub as an interface (Part.extra['ifaces']).
    Checked against beam bending and thin-strip torsion (tests/test_fea.py).
    Result: much of the leg, pelvis and shoulder structure is below SF 2, through
    torsion of thin plates and the motor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
    [arm.py, fea.py, head.py, leg.py, mounts.py, torso.py]
2026-10-30 CAD: machined parts in build123d, redesigned against the finite-element check (work in progress)
    Every machined part is now a flat build123d plate (cad/b3d.py): 2D outlines with inside
    corners rounded for a 6 mm cutter, isogrid pockets, STEP export (cad/export.py), meshed for
    mass properties, FEA and the clearance check. Motors stand on pillar rings (a pillar round each
    stator bolt) instead of a ring and three posts. The mill check uses the tool-changer envelopes.
    Redesigns: the hip pitch motor is flipped (output inward) so its stator sits on a web over the
    roll axis (hip roll yoke SF 0.2 -> 2.1-2.8); hip pitch box, thigh, shin, ankle and foot pass;
    new pelvis frame (back plate, torsion box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
    [robot.yaml]
2026-10-30 CAD: lighten with 7075, isogrid pockets, bolt pads and printed parts; pelvis passes
    Strength-limited plates go to 7075 (hip roll web and front plate, thigh plate and ribs, shin
    plates and bridge, the pelvis, torso base, bridge and shoulder plates, shoulder brackets, foot
    base); parts with margin are thinner; plates under a motor keep only a pad round each stator
    bolt; the hip roll strip, battery shelf and neck bracket are printed PA-CF. The shin bridge moves
    out and grows (SF 1.2 -> 6.7); the pelvis gets fillets and solid zones at the waist (worst SF 3.1).
    Mass budget synced to the CAD: 41.59 kg bare, 42.52 kg with shells (0.52 kg over the limit).
    Still open: shoulder pitch bracket SF 2.0-2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
    [marvin_bot.urdf, marvin_bot_covers.urdf]
2026-10-31 CAD: RS03/RS06 on front rings, crossed-roller bearings, zero pins; aluminium load path
    RobStride's drawings show the RS03 and RS06 are tapped only in ears at their
    output end; the CAD bolted all 15 of them through their rear faces. Each now
    hangs from a ring on its ears (cad/mounts.py: front_ring, hub, cage), the
    ankle motors bolt straight to the shin plates, and the hip yaw motor moves
    onto the thigh.
    - RA6008 crossed-roller bearings at the hip yaw, the waist and in a carrier
    on each hip roll RS04's front face; the hip roll yoke's rear bearing set
    is gone
    - stop pins in arc grooves (hard stops) and zero holes at nine joints
    - the printed arm, neck, head-frame, wrist, hand-mount, batter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
    [bom.xlsx, marvin_bot.urdf, marvin_bot_covers.urdf, robot.yaml]
2026-10-31 CAD: lightened to 41.95 kg with covers, every metal part at SF 2.3 or better
    - the pelvis box and rear gussets out (10 mm back plate instead), plates at
    SF 4 and up thinned or pocketed, the printed shells under the covers gone
    - covers 1.0 mm, head shell 1.8 mm, TPU soles 3 mm
    - cad/mounts.py: output_windows; thin rings pocketed only inside their screw
    circle; cad/fea.py checks cage strips through FEA-only bonded solids
    - 41.16 kg bare, 41.95 kg with covers: tools/check_all.sh passes
    [bom.xlsx, marvin_bot.urdf, marvin_bot_covers.urdf]
2026-10-31 Wiring paths for the front-ring layout; harness measured from the motors' caps
    - tools/build_harness.py: run lengths from each RobStride's driver cap (its
    cable exit), and each service loop tied to a named plate either side
    (CLIPS, checked against description/cad_model.yaml)
    - the pelvis power board and servo DC-DC back on the pelvis top plate (it
    dropped 9 mm with the waist motor)
    - BOM: grommets for the motor cable holes; ties, P-clips and spiral wrap for
    the loops
    - docs/design/assembly_wiring.md: the paths through the new frame, joint by
    joint
    [bom.xlsx, marvin_bot.urdf, marvin_bot_covers.urdf]
2026-10-31 Harness clip points, faceted torso shell, shells refined to the new frame; docs synced
    - Harness clips in the parts: push-in mount holes on solid pads (clip_spot), printed
    TPU edge clips for thick plates (cad/clips.py), a P-clip at the shoulder flange;
    CLIPS checked against cad_model.yaml.
    - Torso shell faceted (alternating octagon sections, hulled), shoulder chamfers and a
    front bevel that clears the shoulder roll bracket; flat-shaded in renders.
    - Grilles over the arm motors; room for each harness loop over the arc between its
    clip holes, on the rear arc at the knee (it had notched the thigh shell).
    - 41.17 kg bare, 41.99 kg with shells; cad.covers --check finds no contacts.
    - READ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
    [bom.xlsx, marvin_bot.urdf, marvin_bot_covers.urdf]
2026-11-01 Decisions: human-form frame study (RP1-style legs, windowed plates), findings not applied
    Records the study's actuator mix and torque checks, the FEA and joint sizing,
    the motion sweep, and why it is not applied (heavier, and the RS04s at hip and
    knee stand outside a human-proportioned body). Credits RP1 and Anny.
2026-11-02 RS10P at shoulder roll, shoulder yaw and elbow (-1.5 kg)
    The six arm motors from the shoulder roll down are RobStride RS10P (42 N·m
    peak, 14 rated, 9.5 held, 25:1, 0.46 kg) in place of the RS03 and RS06:
    39.64 kg bare, 40.47 kg with shells. cad/arm.py takes each arm motor from
    robot.yaml; the yaw and elbow motors sit 5 mm along their axes so their
    rings stay where the RS06's were; the yaw motor also bolts up by its rear
    face, so its cage strips go. Every arm part checks at SF 2.7 or better and
    cad.covers --check finds no contacts. Loads, speed limits and mounting are
    in docs/decisions.md (2026-11-02).
    [bom.xlsx, marvin_bot.urdf, marvin_bot_covers.urdf, robot.yaml]
2026-11-02 Head: a rounded box with a dark visor band, from the study's exterior
    cad/head.py draws the study's approved head (156 x 203 x 121 mm) from its plan,
    side and front outlines, edges rounded 12 mm, split into crown, chin, cheeks,
    rear cap and a dark visor band; the depth camera sits in the band at eye height,
    flush with the face. The neck sleeve reaches up inside the head. No cover
    contacts; 40.53 kg with shells. docs/decisions.md 2026-11-02.
    [bom.xlsx, marvin_bot.urdf, marvin_bot_covers.urdf]
2026-11-03 Head frame checks, RS10P gains, flat v9 walking, stairs kept on rough v9, site refreshed
    - head: camera 4 mm proud (100% clear view), camera arm bridged to the frame, head drop FEA
    - Isaac and MuJoCo gains use the RS10P's 0.00625 kg·m² armature
    - flat v9 retrained on the 1.41 m, 39.70 kg model and passing; rough v11 climbed worse than v9,
    which passes all 25 stair runs on the current model; README clips re-rendered
    - site: RS10P, 1.41 m, 40.5 kg, ≈$17.7k throughout; guide pages and widgets updated
    [bom.xlsx, marvin_bot.urdf, marvin_bot_covers.urdf]
2026-11-03 Tracker v6 on the RS10P, new-head model; skill clips re-rendered
    - all 25 clips upright in Newton and MuJoCo; hands 5.6 cm (v5: 6.7), joints 9.3 deg in MuJoCo
    - docs/skills.md captions and text, sim/motion README, roadmap, site page 17 updated
    - decisions: policies on the new model and the RS10P margins seen in simulation
2026-11-03 Review fixes: RS10P dowels and pin angles, BOM and docs consistency
    - RS10P front rings cut for the motor's three dowels; stop/zero pins moved clear (19/79 deg)
    - shoulder yaw: unused cable hole and two grommets dropped; rear-face bolts in the bolt list
    - harness: capless motors' cable exit near the rear; upper-arm cover follows the yaw motor
    - head-drop FEA load matches its 10 g comment; hold gains for the RS10P shoulder roll
    - docs and site: stale masses, cost, stair results and widget defaults brought current;
    RobStride STEP use credited; robot.yaml height 1.408 m
    [bom.xlsx, marvin_bot.urdf, marvin_bot_covers.urdf, robot.yaml]
2026-11-03 Arm yokes at the shoulder roll and elbow; parts thinned; shells in white PETG
    - idler stubs on the RS10P rear faces with 6805 bearings; yoke plates on the driven links
    - roll front plate 10 -> 7 mm, yaw ring 4 -> 3 mm; fea: side-fall case and --no-idler
    - shells and head panels in PETG; BOM: PETG filament, bearings; CF nylon trimmed
    - 40.00 kg bare, 40.97 kg with shells
    [bom.xlsx, marvin_bot.urdf, marvin_bot_covers.urdf]
2026-11-03 Keep the yoke arm; RS10P output-bearing bench test; numbers, renders and site refreshed
    The tube upper arm (all three arm RS10Ps held at both ends) stays on the
    arm-v2-prototype branch as the fallback. RobStride publishes no output-bearing
    rating, so the shoulder yaw's bearing is checked by a bench test when the
    motors arrive (decisions 2026-11-03).
    Docs and site moved to 40.00 kg bare, 40.97 kg with white PETG shells, and
    $17,575 for 65 BOM lines. Robot picture, 3-D model, walking, stairs and skill
    clips re-rendered; flat v9 and rough v9 pass in MuJoCo on the yoke arm.
2026-11-03 CAD: stable sorts, so the harness clip spot is the same on every machine
    clip_spot sorted candidate points by distance with numpy's default sort,
    which orders equal distances differently on different CPUs; the CI runner
    put the torso base's clip hole elsewhere and cad.build --check failed.
    The covers' angle sort gets the same fix. Torso base +0.04 g.
    [marvin_bot.urdf, marvin_bot_covers.urdf]
2026-11-07 Site: re-render the link preview cards with the yoke arm and white shells
    og-image.png and social-card.png were last drawn before the yoke arm landed.
2026-11-08 Lite variant: base and column-head CAD, Lite URDF, wheeled MuJoCo check
    Lite is Max from the waist motor up on a LINAK DL6 desk column on a 0.55 m
    omni-wheel base (decisions 2026-11-07).
    - cad/lite_base.py: the wheeled base (design pass 1, untested): plates,
    sprung wheel pods on RS00s, snap-on printed shell, battery bricks,
    fasteners; wheel parts in their own link frames for the URDF
    - cad/lite_column.py: the column head, carrying the waist RS03 with the
    pelvis's ring, cage and bearing (shared through torso.waist_mount)
    - cad/build.py writes description/cad_model_lite.yaml
    - robot.yaml / skeleton.yaml variants.lite, DL6 in actuators.yaml;
    build_urdf.py writes marvin_bot_lite(_covers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
    [marvin_bot_lite.urdf, marvin_bot_lite_covers.urdf, robot.yaml]
2026-11-08 Lite: skills, renders, BOM column, reach task (untested), docs and site
    - sim/motion/lite_clips.py: upper-body clips with written base paths and
    column heights, played on Lite's wheels in MuJoCo; 15 clips, every one on
    all four wheels, no joint past 33% of its rating; rendered to
    docs/media/skills/lite/
    - generate_kimodo.py lite group (hold_box, hand_over; beckon dropped) and
    their clip checks; add_head_motion.py matches soma_ clip names
    - tools/render_lite.py: Lite column down and up, base details, animation
    - bom.xlsx Lite qty column, Lite total (~$13.4k) and its lines (DL6, column
    driver, omni wheels, base plates, springs, bearings, lidar estimate);
    check_description.py checks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
    [bom.xlsx, marvin_bot_lite.urdf, marvin_bot_lite_covers.urdf]
2026-11-08 Lite: base-frame stress results at a 6 mm mesh; the floor plate still to check
2026-11-08 Lite design pass 2: column from its data sheet, floor plate, springs, harness, training, site
    - Column mounting from LINAK's DL6 data sheet: bottom plate 4 x M6 + 2 x M8 into an 18 mm
    foot plate; the motor housing on top, turned to overhang to the back, held by cheeks on its
    side M6s; a new head cover. Column mass split 2.5 / 5.0 kg (base / moving)
    - Floor plate: the wheel slots cut through its rim, leaving four loose slivers; the slots are
    now open and the wheel segments' hooks moved clear. Stress-checked on its own: SF 3.5-5.5
    - Pod springs sized (spring_rates(), checked by --check); the spring tab lowered 24 mm, as the
    first pocket was too short for any spring
    - Lite's harness in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
    [bom.xlsx, marvin_bot_lite.urdf, marvin_bot_lite_covers.urdf]
