kranthie/marvin-bot/(notices)

Notices in the files:
site/src/content/docs/guide/sources.mdx:
10. [Isaac Sim on GitHub](https://github.com/isaac-sim/IsaacSim) — Isaac Sim source licence (Apache-2.0) and the Omniverse Kit SDK it downloads · cited on [14](../14-simulation/)
[Pollen Robotics, AmazingHand (CC-BY-4.0)](https://github.com/pollen-robotics/AmazingHand) — the hand meshes (simplified by the Marvin Bot project); 4 fingers, 8 DOF, two SCS0009 per finger parallel mechanism, 400 g, <200 EUR, licences, Enhanced STS3032 (<350 EUR), to-do; open hand design, build-fr
52. [three.js r160 (MIT licence)](https://github.com/mrdoob/three.js) — rendering the 3-D model in the browser · cited on [00](../00-3d-model/)
